machmind-dev/drone-swarm-challenge-2026/hardware/README.md

# Hardware

## Drone Version 2.0

| Swarm Stack Bracket | Base for LiDAR & Flow Motion | FC adapter 25.5 to 20 mm |
|---|---|---|
| [](drone/v2.0/swarm_stack_bracket.stl) | [](drone/v2.0/base_mount_lidar_flow_sensor_mk4.stl) | [](drone/v2.0/fc_mount_adapter_25_5%20_to_20_mm.stl) |

| Swarm Stack PCB | Spoiler Block (for RFID) | Spoiler Block Bracket |
|---|---|---|
| [](https://github.com/machmind-dev/drone-swarm-challenge-2026/tree/main/hardware/drone/v2.0/PCB) | [](drone/v2.0/spoiler_block_mk3.stl) | [](drone/v2.0/spoiler_block_bracket.stl) |

---

Drones assembled and ready for first flight test as formation of five units





<table><tr>
<td></td>
<td></td>
<td></td>
</tr><tr>
<td></td>
<td></td>
<td></td>
</tr><tr>
<td></td>
<td></td>
<td></td>
</tr></table>

---

## Ground Control Station

| Bezel Mk2 | Panel Bottom | Bottom Frame Mk2 |
|---|---|---|
| [](ground-station/bezel_mk2.stl) | [](ground-station/panel_bottom.stl) | [](ground-station/bottom_frame_mk2.stl) |

| Exhaust | Top Connector | Top Lower LH Mk3 |
|---|---|---|
| [](ground-station/exaust.stl) | [](ground-station/top_connector_mk3.stl) | [](ground-station/top_lower_lh_mk3.stl) |

| Top Lower RH Mk3 | Top Upper LH Mk3 | Top Upper RH Mk3 |
|---|---|---|
| [](ground-station/top_lower_rh_mk3.stl) | [](ground-station/top_upper_lh_mk3.stl) | [](ground-station/top_upper_rh_mk3.stl) |

Ground Control Station assembled and in use for flight testing





| Monitor trial fit | Assembling 1 | Assembling 2 |
|---|---|---|
|  |  |  |

---

## Transportation

| Transport Box Version 2.0 | Transport Box Version 1.0 |
|---|---|
| [](transportation/Version%202.0/transport_box_mk4.stl) | [](transportation/Version%201.0/transport_box_mk2.stl) |

---

Drones packed for trip to ILA Berlin 2026
