machmind-dev/drone-swarm-challenge-2026/ground-station-software/README.md

# Ground Control Station Software

Launch scripts are located in [launchers/](../launchers/).

**SDC26 Commander**



| Shortcut | Description | Source |
|---|---|---|
| Waypoint Commander | Sends arena coordinates to individual drones or all drones via Manhattan navigation. Format: `<drone_id\|all> <x> <y> [z] [yaw_deg]` | [Link](swarm/) |
| Keyboard Drone Control | Real-time manual keyboard control of a single drone. Selects drone and team/starting side interactively. | [Link](swarm/) |
| Ollama Control of Swarm | Natural-language swarm control via Gemma3 1B LLM running locally in Ollama. Converts text commands to arena coordinates over ROS2. | [Link](swarm/algorithm/) |
