machmind-dev/drone-swarm-challenge-2026/launchers/README.md

# Launchers

Platform-specific launch scripts for the Mach Mind Ground Control Station.

Screenshot of GCS desktop



| Property | [Ubuntu GNOME PC](ubuntu-gnome-pc/) | [Ubuntu XFCE Pi5](ubuntu-xfce-pi5/) |
|---|---|---|
| Platform | x86_64 | ARM64 (Raspberry Pi 5) |
| OS | Ubuntu 24.04 LTS (GNOME) | Ubuntu 24.04 LTS (XFCE) |
| ROS2 | Jazzy | Jazzy |
| Use | Development / home lab | Field GCS at competition |
| Network role | Wired to GL-AX1800 Flint router | Wired to GL-AX1800 Flint router |
