machmind-dev/drone-swarm-challenge-2026/hardware/drone/README.md

# Drone Hardware

## Drone v2.0

| Swarm Stack Bracket | Base for LiDAR & Flow Motion | FC adapter 25.5 to 20 mm |
|---|---|---|
| [](v2.0/swarm_stack_bracket.stl) | [](v2.0/base_mount_lidar_flow_sensor_mk4.stl) | [](v2.0/fc_mount_adapter_25_5%20_to_20_mm.stl) |

| Swarm Stack PCB | Spoiler Block (for RFID) | Spoiler Block Bracket |
|---|---|---|
| [](https://github.com/machmind-dev/drone-swarm-challenge-2026/tree/main/hardware/drone/v2.0/PCB) | [](v2.0/spoiler_block_mk3.stl) | [](v2.0/spoiler_block_bracket.stl) |

---

Drones assembled and ready for first flight test as formation of five units





<table><tr>
<td></td>
<td></td>
<td></td>
</tr><tr>
<td></td>
<td></td>
<td></td>
</tr><tr>
<td></td>
<td></td>
<td></td>
</tr></table>

---

## Version Comparison

| Version 1.0 | Version 2.0 |
|---|---|
| Version 1.0 | Version 2.0 |
| <div align="center">**Side view comparison**</div> | <div align="center">**Top view comparison**</div> |
| Stack comparison — side | Stack comparison — top |

**Swarm Stack Version 2.0**

Swarm Stack Version 2.0

---

## Part List

| # | Part Number | Description | Link |
|---|---|---|---|
| 1 | GEP-CT30 Cinebot30 | Airframe | [AliExpress](https://de.aliexpress.com/item/1005009477649601.html) |
| 2 | NxtPX4v2 H743 & BMI088 | Flight Controller | [AliExpress](https://de.aliexpress.com/item/1005006044318535.html) |
| 3 | GEPRC SPEEDX2 1804 2450KV | Motors | [AliExpress](https://de.aliexpress.com/item/1005009432319223.html) |
| 4 | HQPROP T3X1.5X3 | Propellers | [AliExpress](https://de.aliexpress.com/item/1005005411737841.html) |
| 5 | Tattu 1100mAh 15.2V 60C 4S1P | Battery | [Gens Ace](https://gensace.de/products/taa11004s60x3) |
| 6 | MicoAir MTF-01 | Optical Flow & LiDAR Sensor | [AliExpress](https://de.aliexpress.com/item/1005005545782306.html) |
| 7 | VL53L1X | ToF Laser Ranger (×6) | [AliExpress](https://de.aliexpress.com/item/1005009800135193.html) |
| 8 | OV5647 MIPI-CSI | Camera Module | [Amazon](https://www.amazon.de/dp/B07G9VLPZH) |
| 9 | ESP32-S3 | Comms Module | [Amazon](https://www.amazon.de/dp/B0C69FFVHH) |
| 10 | ESP32-P4 | Vision Module | [Amazon](https://www.amazon.de/dp/B0FKN8GCW6) |
| 11 | Seeed Studio 2.4GHz Rod Antenna | WiFi Antenna | [AliExpress](https://de.aliexpress.com/item/1005006991095171.html) |
