machmind-dev/drone-swarm-challenge-2026/hardware/ground-station/README.md

# Ground Control Station

| Bezel Mk2 | Panel Bottom | Bottom Frame Mk2 |
|---|---|---|
| [](bezel_mk2.stl) | [](panel_bottom.stl) | [](bottom_frame_mk2.stl) |

| Exhaust | Top Connector | Top Lower LH Mk3 |
|---|---|---|
| [](exaust.stl) | [](top_connector_mk3.stl) | [](top_lower_lh_mk3.stl) |

| Top Lower RH Mk3 | Top Upper LH Mk3 | Top Upper RH Mk3 |
|---|---|---|
| [](top_lower_rh_mk3.stl) | [](top_upper_lh_mk3.stl) | [](top_upper_rh_mk3.stl) |

---

Ground Control Station assembled and in use for flight testing





| Monitor trial fit | Assembling 1 | Assembling 2 |
|---|---|---|
|  |  |  |

---

## Part List

| # | Part Number | Description | Link |
|---|---|---|---|
| 1 | M3 x5 x 4 Voron | Threaded Insert M3 | [Amazon Shop](https://www.amazon.de/dp/B0CDH36ZMX?ref=ppx_yo2ov_dt_b_fed_asin_title&th=1) |
| 2 | Toolbox 38 x 14.5 x 33 cm | BigDean Machine Case with Foam Insert Empty | [Amazon Shop](https://www.amazon.de/dp/B0D37TFB92?ref=ppx_yo2ov_dt_b_fed_asin_title) |
