machmind-dev/drone-swarm-challenge-2026/hardware/transportation/README.md

# Transportation

| Transport Box Version 2.0 | Transport Box Version 1.0 |
|---|---|
| [](Version%202.0/transport_box_mk4.stl) | [](Version%201.0/transport_box_mk2.stl) |

---

Drones packed for trip to ILA Berlin 2026
