machmind-dev/drone-swarm-challenge-2026/drone-firmware/v2.0/README.md

# Drone Firmware v2.0

- **[drone-vision-esp32p4](drone-vision-esp32p4/)** — ESP32-P4 firmware — MIPI-CSI camera capture, ArUco marker detection (OpenCV), 6× VL53L1X ToF sensors, transmits pose + ToF data to S3 over UART
- **[drone-comms-esp32s3](drone-comms-esp32s3/)** — ESP32-S3 firmware — receives vision data from P4 over UART, bridges MAVLink between PX4 and the GCS over ROS2 micro-ROS
- **[shared](shared/)** — UART binary frame protocol header (`p4_link_protocol.h`) shared by both firmwares
- **[logs](logs/)** — PX4 flight logs (`.ulg`) and ROS2 bag files (`.mcap`) from test sessions

---

## Building and Flashing

Firmware is compiled and flashed from desktop shortcuts on the PC.

<table>
<tr>
<td align="center"><br><b>IDE — Flash P4</b></td>
<td>Firmware flashing for ESP32-P4 inside Docker (<a href="../../launchers/ubuntu-gnome-pc/launch-drone-vision-p4.sh">launch-drone-vision-p4.sh</a>)</td>
</tr>
<tr>
<td align="center"><br><b>IDE — Flash S3</b></td>
<td>Firmware flashing for ESP32-S3 inside Docker (<a href="../../launchers/ubuntu-gnome-pc/launch-drone-vision-s3.sh">launch-drone-vision-s3.sh</a>)</td>
</tr>
</table>

> **Note:** To avoid versioning issues, code is built and compiled inside Docker.

### Vision Module Configuration (ESP32-P4)

#### Camera Exposure Tuning

```cpp
#define CONFIG_VISION_AEC_TARGET 15   // ← tune per venue
```

| Value | Sensor target | Use when |
|---|---|---|
| 47 | ~91% (max) | Dark indoor arena, no windows |
| 20 | ~38% | Indoor with some ambient light |
| 15 | ~29% | Daylit venue, windows visible — current default |
| 10 | ~19% | Strong window glare / direct sunlight |

#### Detection Resolution

```cpp
#define VISION_RES_QVGA   // 320×240 — ~8 m detection range (default)
// #define VISION_RES_HVGA // 480×320 — ~12 m detection range, slower
```

---

### Comms Module Configuration (ESP32-S3)

#### DRONE_ID

```c
#define DRONE_ID 2   // ← set per airframe before flashing
```

Set `DRONE_ID` in `main/main.c` to the airframe number before building. This value is intentionally not committed — the repo keeps `2` as a neutral default. It controls the micro-ROS agent port (`8880 + DRONE_ID`) and the NED coordinate offset for arena navigation.

#### micro-ROS Agent IP and Port

The ESP32-S3 must be configured with the micro-ROS agent IP and port before flashing. Open `idf.py menuconfig` → **micro-ROS Settings**.

<table>
<tr>
<td align="center"><br><b>micro-ROS Agent IP</b><br>IP address of the GCS machine running the micro-ROS agent. Must match the static IP assigned to the GCS on the swarm network.</td>
<td align="center"><br><b>micro-ROS Agent Port</b><br>UDP port the agent listens on. Derived from <code>DRONE_ID</code>: port = <code>8880 + DRONE_ID</code> (e.g. drone 1 → 8881, drone 5 → 8885).</td>
</tr>
</table>

---

### idf.py commands

| Command | Description |
|---|---|
| `idf.py set-target <target>` | Set the chip target — `esp32p4` for the vision module or `esp32s3` for the comms module |
| `idf.py fullclean` | Delete build directory |
| `idf.py menuconfig` | Open settings menu for firmware settings (important for ESP32-S3) |
| `idf.py build` | Compile firmware |
| `idf.py flash` | Flash to board |
| `idf.py monitor` | Open serial console for debugging and troubleshooting |
