machmind-dev/drone-swarm-challenge-2026/hardware/drone/v2.0/PCB/README.md

# Swarm Stack PCB

Schematics and board design: **Autodesk Eagle** (`.sch` / `.brd`)

<table><tr>
<td></td>
<td></td>
</tr></table>

## ToF Sensors (VL53L1X)

| Sensor | XSHUT GPIO | Direction |
|---|---|---|
| S0 | GPIO4 | Left Hand (LH) |
| S1 | GPIO20 | LH 45° |
| S2 | GPIO21 | Forward |
| S3 | GPIO26 | 45° RH |
| S4 | GPIO32 | Right Hand (RH) |
| S5 | GPIO27 | Upwards |

## I2C (ESP32-P4)

| Signal | GPIO |
|---|---|
| SDA | GPIO2 |
| SCL | GPIO3 |

**Note 1:** The 1K Ohm current limiting resistor for LED strip control is not populated on the PCB — add it externally on the signal line.

**Note 2:** BEC must share a common ground with the Swarm Stack.

**Note 3:** Pinout was modified in the latest version — Waveshare ESP32-P4 with and without WiFi module have different pinouts.

**Note 4:** C6 module with WiFi 6 is not used and meant for the future.
