machmind-dev/drone-swarm-challenge-2026/docs/Technical Report for Finals Submission.pdf

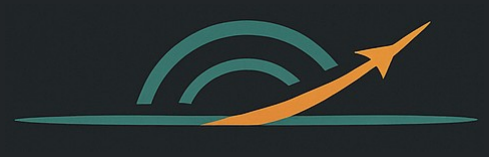
[picture p1: figure]

### 2026 June

2026

# Technical Report – Finals Submission

# Team

# Mach Mind

## Collective intelligence at Mach speed

X

# 1. System Architecture Overview – Version 2.0

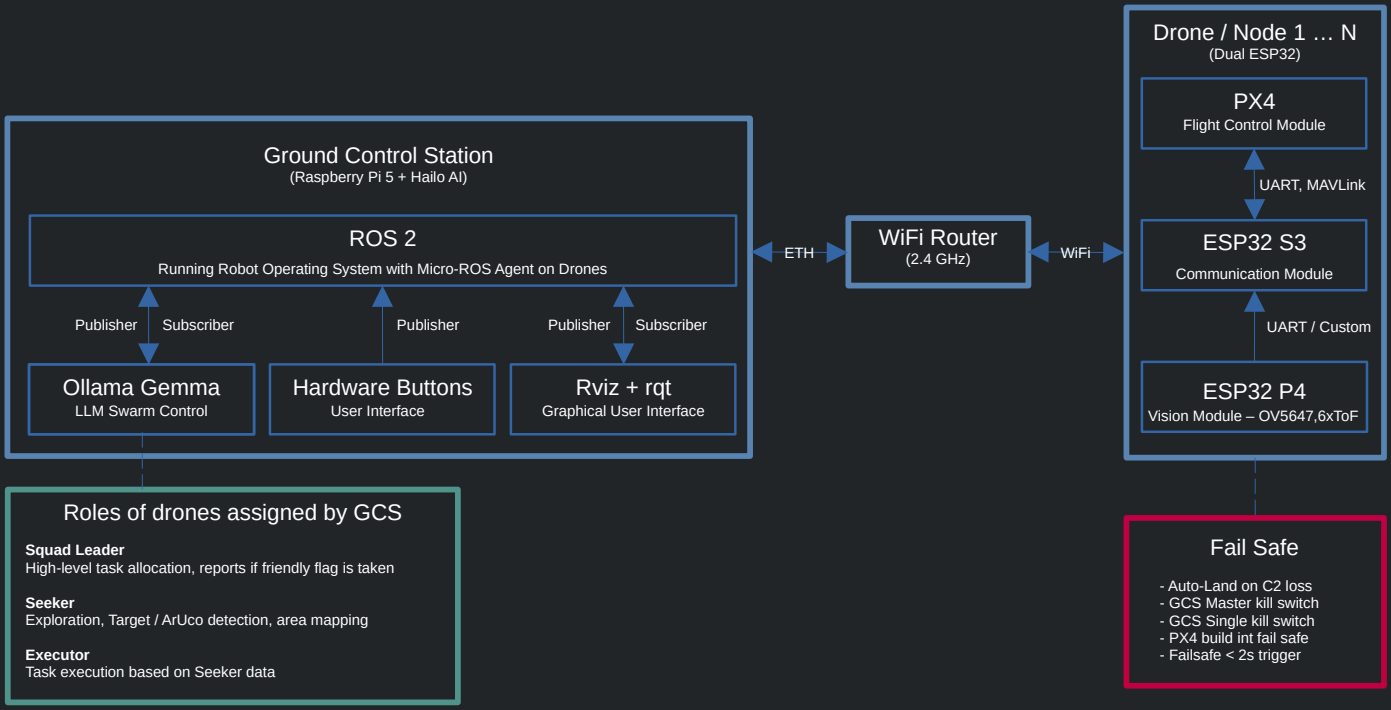
[picture p2: figure]
Ground Control Station; (Raspberry Pi 5 + Hailo AI); ROS 2; LLM Swarm Control; Ollama Gemma; Graphical User Interface; Hardware Buttons; Rviz + rqt; User Interface; WiFi Router; (2.4 GHz); WiFi; Drone / Node 1 … N; (Dual ESP32); Flight Control Module; ESP32 S3; Communication Module; Fail Safe; - Auto-Land on C2 loss - GCS Master kill switch - GCS Single kill switch - PX4 build int fail safe - Failsafe < 2s trigger; Roles of drones assigned by GCS; Squad Leader; Seeker; Executor Task execution based on Seeker data; Vision Module – OV5647,6xToF; ESP32 P4; UART, MAVLink; Publisher; Subscriber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

## System Summary

Mission | Autonomous multi-drone swarm for capture the flag scenario, GPS-denied indoor arena
Architecture | Ground Control Station handles tasks allocation, while drones maintain local autonomy.
System Config | 5 drones (1 Squad Leader, 2 Seekers, 2 Executors) and a Ground Control Station
Design Philosophy | Off-the-shelf hardware, open-source software stack - cost-effective, reproducible, scalable.

# Mach Mind

Collective intelligence at Mach speed

Team
Mindaugas Jonauskis
Hauke Renk

Contact
info@machmind.dev
http://machmind.dev

Running Robot Operating System with Micro-ROS Agent on Drones

High-level task allocation, reports if friendly flag is taken

Exploration, Target / ArUco detection, area mapping

# 2. Drone / Node

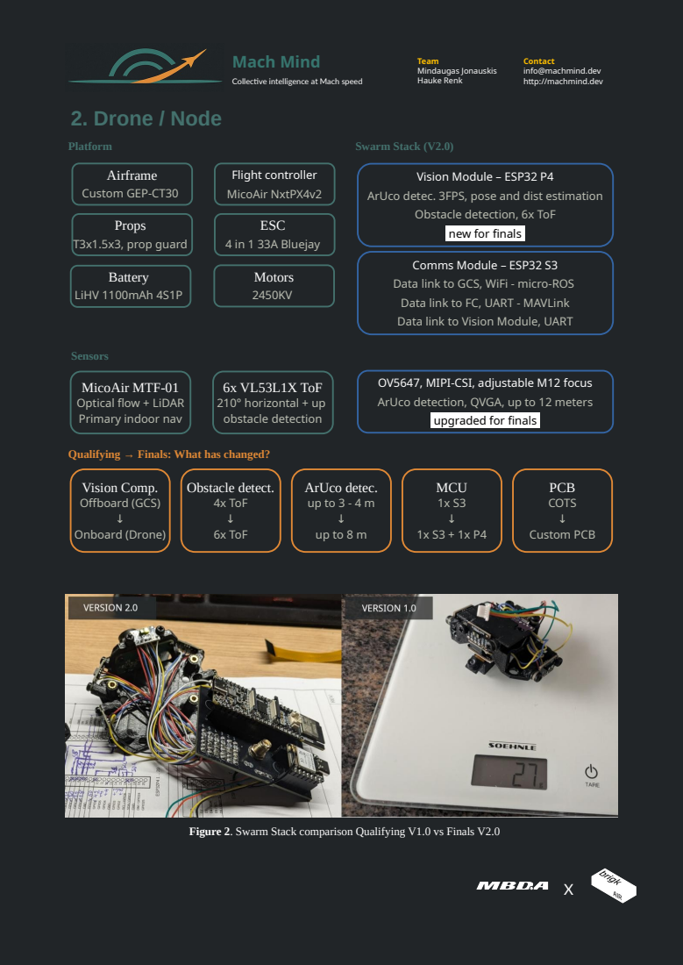
[picture p3: page 3]
Platform; Swarm Stack (V2.0); Sensors; Airframe Custom GEP-CT30; Flight controller MicoAir NxtPX4v2; Props T3x1.5x3, prop guard; ESC 4 in 1 33A Bluejay; Motors 2450KV; Battery LiHV 1100mAh 4S1P; Vision Module – ESP32 P4; 6x VL53L1X ToF 210° horizontal + up obstacle detection; Vision Comp. Offboard (GCS) ↓ Onboard (Drone); Obstacle detect. 4x ToF ↓ 6x ToF; ArUco detec. up to 3 - 4 m ↓ up to 8 m; MCU 1x S3 ↓ 1x S3 + 1x P4; PCB COTS ↓ Custom PCB

ArUco detec. 3FPS, pose and dist estimation

Obstacle detection, 6x ToF
new for finals

Comms Module – ESP32 S3
Team
Data link to GCS, WiFi - micro-ROS
Mindaugas Jonauskis
Hauke Renk
Data link to FC, UART - MAVLink
Data link to Vision Module, UART

Contact
info@machmind.dev
http://machmind.dev

MicoAir MTF-01
Optical flow + LiDAR
Primary indoor nav

OV5647, MIPI-CSI, adjustable M12 focus
ArUco detection, QVGA, up to 12 meters

upgraded for finals

Qualifying → Finals: What has changed?

Figure 2. Swarm Stack comparison Qualifying V1.0 vs Finals V2.0

# 3. Ground Control Station (GCS)

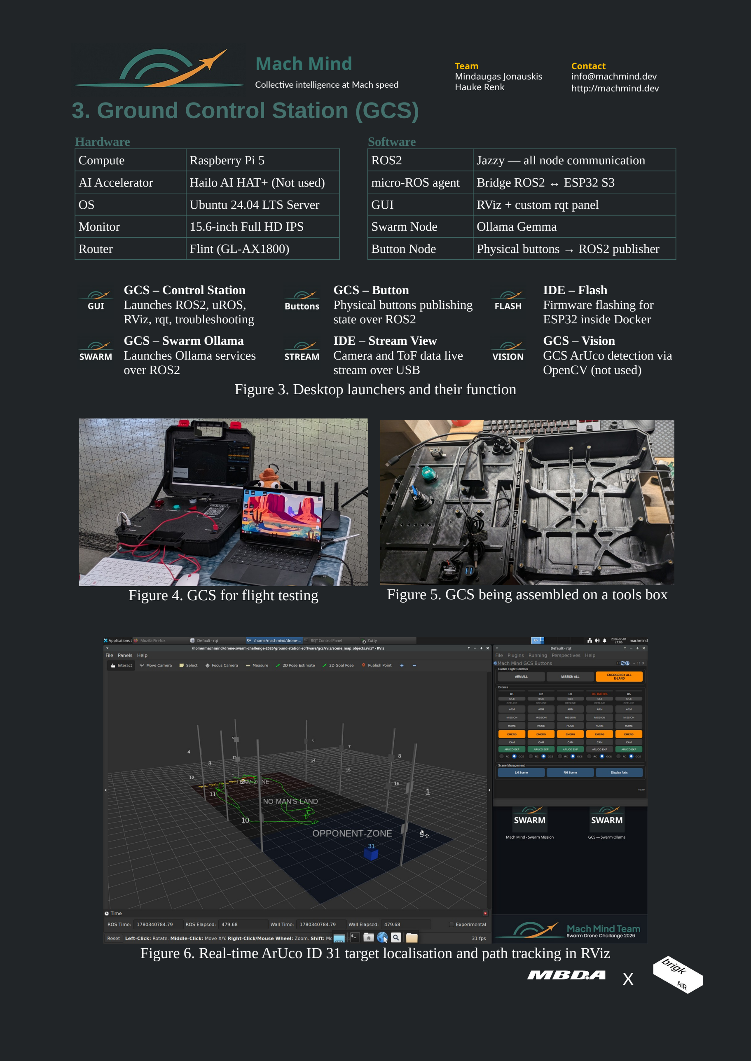
[picture p4: page 4]

Hardware
Compute | Raspberry Pi 5
AI Accelerator | Hailo AI HAT+ (Not used)
OS | Ubuntu 24.04 LTS Server
Monitor | 15.6-inch Full HD IPS
Router | Flint (GL-AX1800)

Software
ROS2 | Jazzy — all node communication
micro-ROS agent | Bridge ROS2 ↔ ESP32 S3
GUI | RViz + custom rqt panel
Swarm Node | Ollama Gemma
Button Node | Physical buttons → ROS2 publisher

GCS – Control Station
Launches ROS2, uROS,
RViz, rqt, troubleshooting

GCS – Button
Physical buttons publishing state over ROS2

IDE – Flash
Firmware flashing for
ESP32 inside Docker
GCS – Swarm Ollama
Launches Ollama services
over ROS2

IDE – Stream View
Camera and ToF data live
stream over USB

GCS – Vision
GCS ArUco detection via
OpenCV (not used)

### Figure 3. Desktop launchers and their function

Figure 4. GCS for flight testing | Figure 5. GCS being assembled on a tools box

### Figure 6. Real-time ArUco ID 31 target localisation and path tracking in RViz

# 4. Swarming

## 4.1 ROS Communication messaging for Swarm control

GCS (Publisher) → Drone (Subscriber) | Drone (Publisher) → GCS (Subscriber)
Topic (main) | Purpose | Topic (main) | Purpose
/gcs/drone_N/command Arm, takeoff, land, mission, emer. | /drone_N/state | Flight state
/gcs/drone_N/control | Waypoint | /drone_N/role | Accepted role
/gcs/drone_N/config | Runtime config (e.g. role) | /drone_N/vision_pose | Estimated position
/gcs/system/team_color Team colour, defines starting point | /drone_N/box_detected ID and position of box
Note: Only critical topics are shown, N – denotes drone ID.

## 4.2. Swarm Data

Swarm Size | 5 drones — finals config (2 drones at qualifying)
Coordination | Centralized GCS task allocation, drones maintain local autonomy
LLM control | Ollama Gemma 3 on Pi5 (CPU) via natural language ruleset → JSON → ROS2 commands
Inter-drone comms | All traffic routed through GCS
Autonomy level | Drones: local stabilize + collision avoidance. GCS: high-level task allocation

## 4.3. Swarm Control via LLM (DEMO)

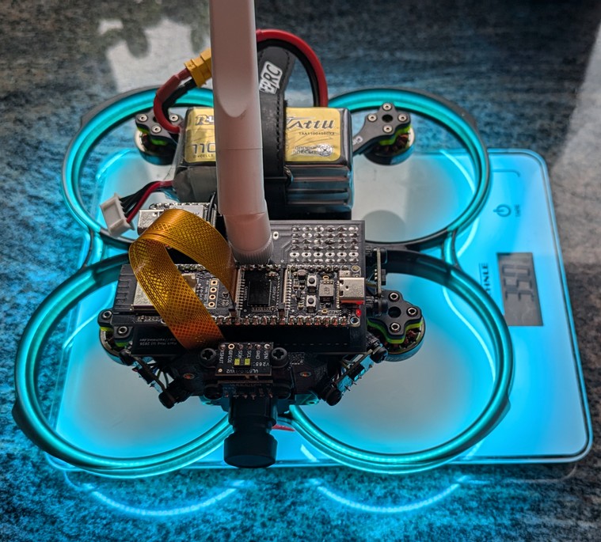
[picture p5: figure]
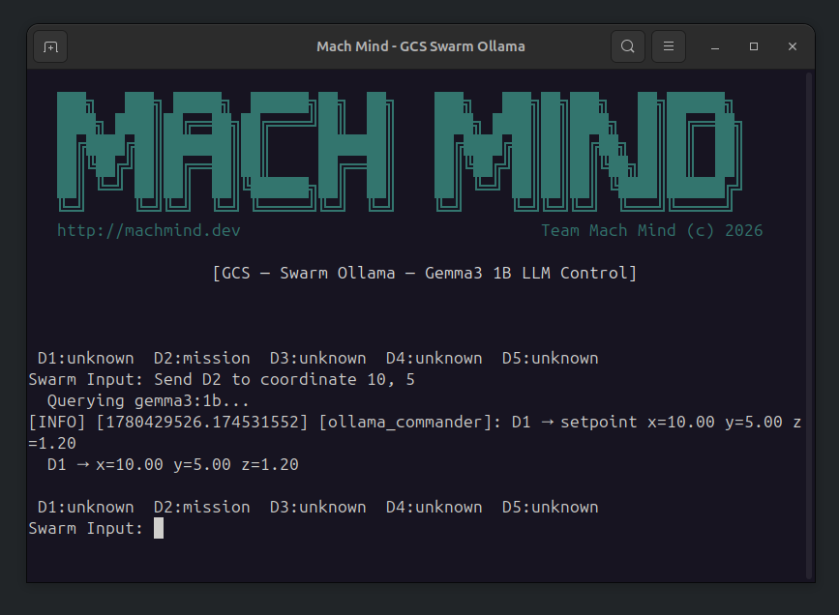
[picture p6: figure]

Figure 7. Sample of control input to LLM and drone with props removed.

# 5. Source Code and Drawings:

### https://github.com/machmind-dev/drone-swarm-challenge-2026

drone-swarm-challenge-2026/
├── drone-firmware/ | # All drone onboard firmware (v1.0 and v2.0)
│ | ├── v1.0/ | # SDC 2026 Qualifying — single ESP32-S3
│ | └── v2.0/ | # SDC 2026 Finals — dual ESP32-P4 + ESP32-S3
│ | ├── drone-vision-esp32p4/ | # Navigation: ArUco, ToF, UART TX
│ | ├── drone-comms-esp32s3/ | # Communication: MAVLink, micro-ROS
│ | └── shared/ | # Binary UART protocol header
├── ground-station-software/ | # ROS2 ground control station, swarm algorithms & vision
├── hardware/ | # Mechanical and electrical design files
├── launchers/ | # Platform-specific launch scripts
│ | ├── ubuntu-gnome-pc/ | # x86_64 Ubuntu GNOME (development GCS)
│ | └── ubuntu-xfce-pi5/ | # ARM64 Raspberry Pi 5 (field GCS)
└── docs/ | # Documentation and media
