machmind-dev/drone-swarm-challenge-2026/docs/media/README.md

# Media

## [flight-testing/](flight-testing/)

Flight test recordings and photos, in chronological order.

| First flight — 24 March 2026 | First flight 5 units — May 2026 | Basic swarming — June 2026 |
|---|---|---|
| [](https://github.com/machmind-dev/drone-swarm-challenge-2026/blob/main/docs/media/flight-testing/first-flight.mp4) | [](https://www.linkedin.com/embed/feed/update/urn:li:ugcPost:7463683893968187392) | [](https://www.linkedin.com/embed/feed/update/urn:li:ugcPost:7469555928992940034) |

### [flight-testing/crashes/](flight-testing/crashes/)

Photos from crash and repair incidents during development — documenting the hardware iteration process.

<table>
<tr>
<td></td>
<td></td>
<td></td>
</tr>
<tr>
<td></td>
<td></td>
<td></td>
</tr>
</table>

---

## [software/](software/)

3D model assets used by RViz for arena visualisation. Do not move or rename — paths are referenced by the RViz configuration.
