machmind-dev/drone-swarm-challenge-2026/ground-station-software/swarm/README.md

# Swarm Command and Control Tools

**SDC26 Commander** — [sdc26_commander.py](sdc26_commander.py)

Swarm orchestrator — assigns discovered boxes to executor drones, monitors leader home zone. Runs at 1 Hz, publishes waypoints over ROS2.



---

**Waypoint Commander** — [waypoint_commander.py](waypoint_commander.py)

Sends arena coordinates to individual drones or all drones via Manhattan navigation. Format: `<drone_id|all> <x> <y> [z] [yaw_deg]`. Arena: x=0–20 m, y=0–10 m.



---

**Keyboard Drone Control** — [mission_forward_back.py](mission_forward_back.py)

Real-time manual keyboard control of a single drone. Selects drone and team/starting side interactively before flight.



---

**Ollama Control of Swarm** — [algorithm/ollama_commander.py](algorithm/ollama_commander.py)

Natural-language swarm control via Gemma3 1B LLM running locally in Ollama. Converts text commands into arena coordinates published over ROS2.
