machmind-dev/drone-swarm-challenge-2026/drone-firmware/v1.0/components/espressif__opencv/examples/features2d/README.md

# Feature2d example for IDF OpenCV component

This example shows how to use OpenCV in ESP-IDF projects.

This example requires esp32-eye or esp32-s3-eye development boards. The example use opencv library to extract 
2D features from the image and compute the feature descriptors.
To run the example on target please run:

```
idf.py -p PORT flash monitor
```
