machmind-dev/drone-swarm-challenge-2026/(list of files, cad)

Other CAD files:
hardware/drone/for_reference_only_top_plate.stl
hardware/drone/v2.0/fc_mount_adapter_25_5 _to_20_mm.stl
hardware/ground-station/mk2/panel_4.stl
hardware/ground-station/top_lower_lh_mk3.stl
hardware/transportation/Version 2.0/transport_box_mk4.stl
hardware/drone/for_reference_only_bottom_frame_rough.stl
hardware/drone/v2.0/swarm_stack_bracket.stl
hardware/ground-station/mk2/panel_1_mk2.stl
hardware/ground-station/top_connector_mk3.stl
hardware/drone/v2.0/spoiler_block_bracket.stl
hardware/ground-station/bezel_mk2.stl
hardware/ground-station/mk2/panel_3_mk2.stl
hardware/drone/v2.0/spoiler_block_mk3.stl
hardware/ground-station/mk2/panel_6.stl
hardware/ground-station/top_upper_lh_mk3.stl
hardware/drone/v2.0/base_mount_lidar_flow_sensor_mk4.stl
hardware/ground-station/mk2/bottom_frame_mk2.stl
hardware/ground-station/top_upper_rh_mk3.stl
hardware/ground-station/mk2/panel_5.stl
hardware/ground-station/panel_bottom.stl
hardware/ground-station/mk2/panel_2.stl
hardware/ground-station/top_lower_rh_mk3.stl
hardware/ground-station/exaust.stl
drone-firmware/v1.0/components/espressif__opencv/opencv_contrib/modules/cnn_3dobj/samples/data/3Dmodel/ant.ply
drone-firmware/v1.0/components/espressif__opencv/opencv_contrib/modules/cnn_3dobj/samples/data/3Dmodel/ape.ply
drone-firmware/v1.0/components/espressif__opencv/opencv_contrib/modules/cnn_3dobj/samples/data/3Dmodel/bunny.ply
drone-firmware/v1.0/components/espressif__opencv/opencv_contrib/modules/cnn_3dobj/samples/data/3Dmodel/cow.ply
drone-firmware/v1.0/components/espressif__opencv/opencv_contrib/modules/cnn_3dobj/samples/data/3Dmodel/horse.ply
drone-firmware/v1.0/components/espressif__opencv/opencv_contrib/modules/cnn_3dobj/samples/data/3Dmodel/plane.ply
drone-firmware/v1.0/components/espressif__opencv/opencv_contrib/modules/sfm/samples/data/backyard.blend
drone-firmware/v1.0/components/espressif__opencv/opencv_contrib/modules/sfm/samples/data/desktop.blend
drone-firmware/v1.0/components/espressif__opencv/opencv_contrib/modules/surface_matching/samples/data/parasaurolophus_6700.ply
drone-firmware/v1.0/components/espressif__opencv/opencv_contrib/modules/surface_matching/samples/data/parasaurolophus_low_normals2.ply
drone-firmware/v1.0/components/espressif__opencv/opencv_contrib/modules/surface_matching/samples/data/rs1_normals.ply
drone-firmware/v1.0/components/espressif__opencv/opencv_contrib/modules/surface_matching/samples/data/rs22_proc2.ply
drone-firmware/v1.0/components/espressif__opencv/opencv_contrib/modules/viz/samples/data/bunny.ply
hardware/drone/v1.0/base_mount_lidar_flow_sensor_mk4.stl
hardware/drone/v1.0/camera_sleve.stl
hardware/drone/v1.0/camera_sleve_alternative.stl
hardware/drone/v1.0/fc_mount_adapter_25_5 _to_20_mm.stl
hardware/drone/v1.0/side_bracket_for_laser_ranger.stl
hardware/drone/v1.0/swarm stack bracket mk6.stl
hardware/drone/v1.0/swarm stack bracket mk7.stl
hardware/drone/v1.0/swarm stack bracket mk7_6.stl
hardware/transportation/Version 1.0/transport_box_mk2.stl
