machmind-dev/drone-swarm-challenge-2026/hardware/drone/v2.0/PCB/Schematics.brd

## EAGLE design hardware/drone/v2.0/PCB/Schematics.brd (2026-06-09)

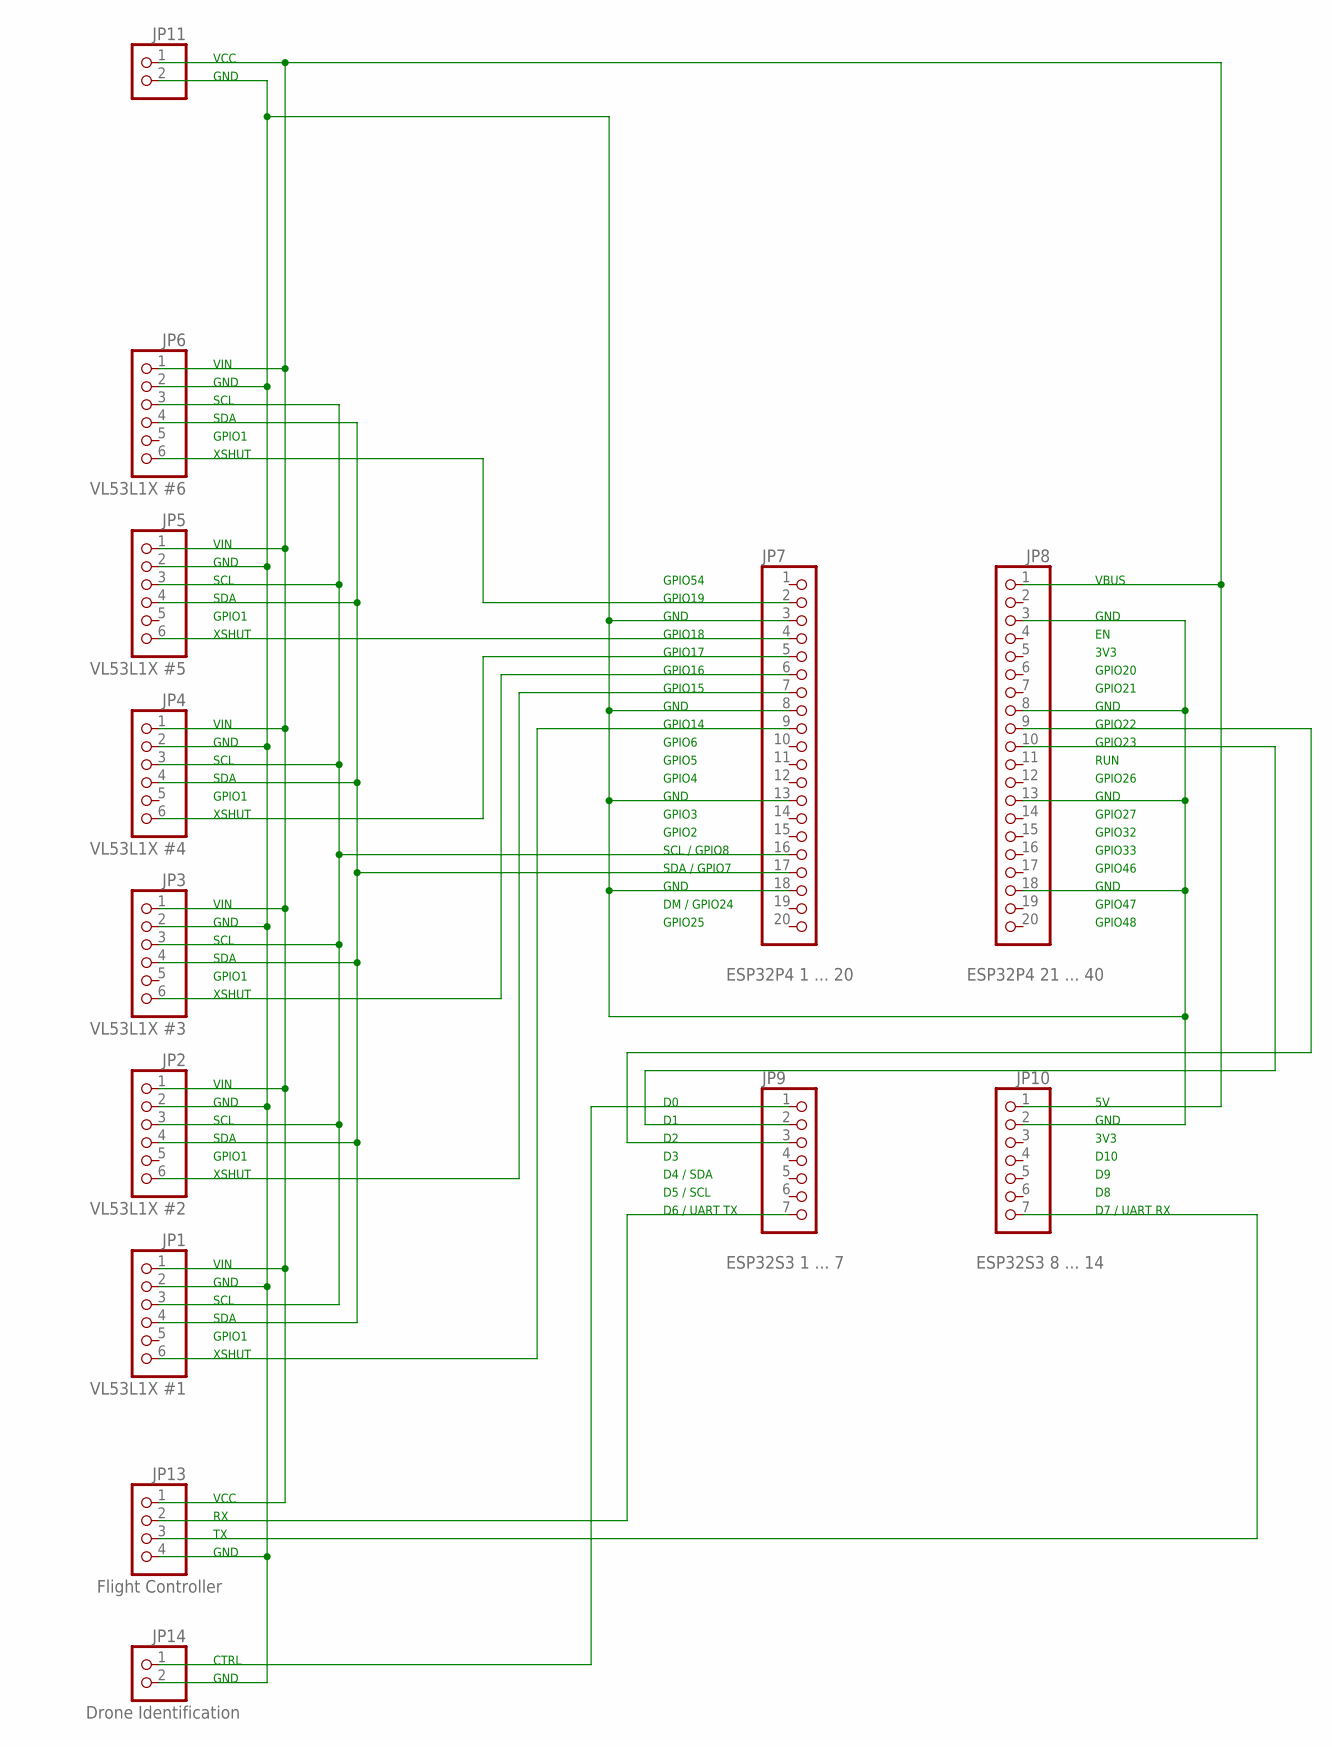
[picture p7: schematic Schematics.sch]

Parts:
JP1: VL53L1X #1; 1X06
JP2: VL53L1X #2; 1X06
JP3: VL53L1X #3; 1X06
JP4: VL53L1X #4; 1X06
JP5: VL53L1X #5; 1X06
JP6: VL53L1X #6; 1X06
JP7: ESP32P4 1 ... 20; 1X20
JP8: ESP32P4 21 ... 40; 1X20
JP9: ESP32S3 1 ... 7; 1X07
JP10: ESP32S3 8 ... 14; 1X07
JP11: PINHD-1X2; 1X02
JP13: Flight Controller; 1X04
JP14: Drone Identification; 1X02

Connections:
5VDC: JP1.1, JP2.1, JP3.1, JP4.1, JP5.1, JP6.1, JP8.1, JP10.1, JP11.1, JP13.1
GND: JP1.2, JP2.2, JP3.2, JP4.2, JP5.2, JP6.2, JP7.3, JP7.8, JP7.13, JP7.18, JP8.3, JP8.8, JP8.13, JP8.18, JP10.2, JP11.2, JP13.4, JP14.2
LED_CTRL: JP9.1, JP14.1
MASTER_RX: JP8.10, JP9.2
MASTER_TX: JP8.9, JP9.3
MAVLINK_RX: JP10.7, JP13.3
MAVLINK_TX: JP9.7, JP13.2
SCL: JP1.3, JP2.3, JP3.3, JP4.3, JP5.3, JP6.3, JP7.16
SDA: JP1.4, JP2.4, JP3.4, JP4.4, JP5.4, JP6.4, JP7.17
XSHUT1: JP1.6, JP7.9
XSHUT2: JP2.6, JP7.7
XSHUT3: JP3.6, JP7.6
XSHUT4: JP4.6, JP7.5
XSHUT5: JP5.6, JP7.4
XSHUT6: JP6.6, JP7.2

Notes on the sheet:
VIN
GND
SCL
SDA
GPIO1
XSHUT
GPIO54
GPIO19
GPIO18
GPIO17
GPIO16
GPIO15
GPIO14
GPIO6
GPIO5
GPIO4
GPIO3
GPIO2
SCL / GPIO8
SDA / GPIO7
DM / GPIO24
GPIO25
VBUS
GPIO20
3V3
GPIO21
GPIO22
GPIO23
RUN
GPIO26
GPIO27
GPIO32
GPIO33
GPIO46
GPIO47
GPIO48
D4 / SDA
D5 / SCL
D6 / UART TX
D10
D7 / UART RX
VCC
CTRL

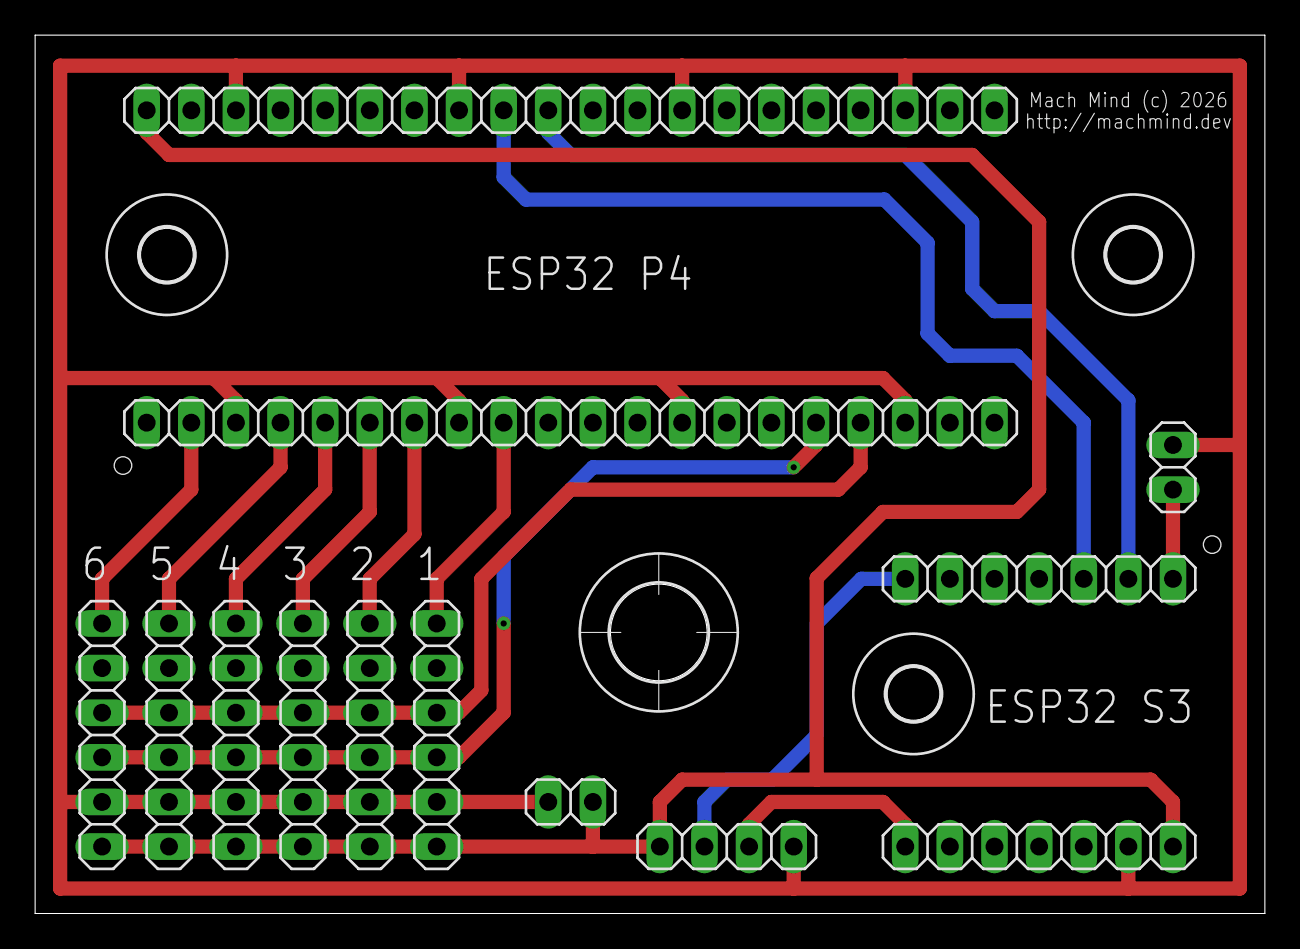
[picture p8: board Schematics.brd from above]

Board: 2 copper layers, 70.0 x 50.0 mm, 17 parts (0 on the bottom side), 15 nets.

Other parts of the board:
U$1, U$2, U$3: 3,0
U$4: 5,5
