machmind-dev/drone-swarm-challenge-2026/drone-firmware/PX4_settings.params

1	1	BAT1_A_PER_V	17.000000000000000000	9
1	1	BAT1_CAPACITY	-1.000000000000000000	9
1	1	BAT1_I_CHANNEL	-1	6
1	1	BAT1_N_CELLS	4	6
1	1	BAT1_R_INTERNAL	0.004999999888241291	9
1	1	BAT1_SOURCE	0	6
1	1	BAT1_V_CHANNEL	-1	6
1	1	BAT1_V_CHARGED	4.199999809265136719	9
1	1	BAT1_V_DIV	10.100000381469726563	9
1	1	BAT1_V_EMPTY	3.200000047683715820	9
1	1	BAT1_V_LOAD_DROP	0.100000001490116119	9
1	1	BAT_AVRG_CURRENT	15.000000000000000000	9
1	1	BAT_CRIT_THR	0.070000000298023224	9
1	1	BAT_EMERGEN_THR	0.050000000745058060	9
1	1	BAT_LOW_THR	0.150000005960464478	9
1	1	BAT_N_CELLS	3	6
1	1	BAT_V_CHARGED	4.050000190734863281	9
1	1	BAT_V_EMPTY	3.599999904632568359	9
1	1	BAT_V_LOAD_DROP	0.300000011920928955	9
1	1	BAT_V_OFFS_CURR	0.000000000000000000	9
1	1	CA_AIRFRAME	0	6
1	1	CA_ROTOR0_AX	0.000000000000000000	9
1	1	CA_ROTOR0_AY	0.000000000000000000	9
1	1	CA_ROTOR0_AZ	-1.000000000000000000	9
1	1	CA_ROTOR0_CT	6.500000000000000000	9
1	1	CA_ROTOR0_KM	0.050000000745058060	9
1	1	CA_ROTOR0_PX	0.150000005960464478	9
1	1	CA_ROTOR0_PY	0.150000005960464478	9
1	1	CA_ROTOR0_PZ	0.000000000000000000	9
1	1	CA_ROTOR10_AX	0.000000000000000000	9
1	1	CA_ROTOR10_AY	0.000000000000000000	9
1	1	CA_ROTOR10_AZ	-1.000000000000000000	9
1	1	CA_ROTOR10_CT	6.500000000000000000	9
1	1	CA_ROTOR10_KM	0.050000000745058060	9
1	1	CA_ROTOR10_PX	0.000000000000000000	9
1	1	CA_ROTOR10_PY	0.000000000000000000	9
1	1	CA_ROTOR10_PZ	0.000000000000000000	9
1	1	CA_ROTOR11_AX	0.000000000000000000	9
1	1	CA_ROTOR11_AY	0.000000000000000000	9
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
1	1	PWM_MAIN_DIS3	1000	6
1	1	PWM_MAIN_DIS4	1000	6
1	1	PWM_MAIN_DIS5	1000	6
1	1	PWM_MAIN_DIS6	1000	6
1	1	PWM_MAIN_DIS7	1000	6
1	1	PWM_MAIN_DIS8	1000	6
1	1	PWM_MAIN_FAIL1	-1	6
1	1	PWM_MAIN_FAIL2	-1	6
1	1	PWM_MAIN_FAIL3	-1	6
1	1	PWM_MAIN_FAIL4	-1	6
1	1	PWM_MAIN_FAIL5	-1	6
1	1	PWM_MAIN_FAIL6	-1	6
1	1	PWM_MAIN_FAIL7	-1	6
1	1	PWM_MAIN_FAIL8	-1	6
1	1	PWM_MAIN_FUNC1	101	6
1	1	PWM_MAIN_FUNC2	104	6
1	1	PWM_MAIN_FUNC3	103	6
1	1	PWM_MAIN_FUNC4	102	6
1	1	PWM_MAIN_FUNC5	0	6
1	1	PWM_MAIN_FUNC6	0	6
1	1	PWM_MAIN_FUNC7	0	6
1	1	PWM_MAIN_FUNC8	0	6
1	1	PWM_MAIN_MAX1	2000	6
1	1	PWM_MAIN_MAX2	2000	6
1	1	PWM_MAIN_MAX3	2000	6
1	1	PWM_MAIN_MAX4	2000	6
1	1	PWM_MAIN_MAX5	2000	6
1	1	PWM_MAIN_MAX6	2000	6
1	1	PWM_MAIN_MAX7	2000	6
1	1	PWM_MAIN_MAX8	2000	6
1	1	PWM_MAIN_MIN1	1000	6
1	1	PWM_MAIN_MIN2	1000	6
1	1	PWM_MAIN_MIN3	1000	6
1	1	PWM_MAIN_MIN4	1000	6
1	1	PWM_MAIN_MIN5	1000	6
1	1	PWM_MAIN_MIN6	1000	6
1	1	PWM_MAIN_MIN7	1000	6
1	1	PWM_MAIN_MIN8	1000	6
1	1	PWM_MAIN_TIM0	-3	6
1	1	PWM_MAIN_TIM1	400	6
1	1	PWM_MAIN_TIM2	400	6
1	1	SYS_AUTOSTART	4001	6
