machmind-dev/drone-swarm-challenge-2026/drone-firmware/v2.0/drone-vision-esp32p4/main/tof_task.c

/* tof_task.c — VL53L1X ToF sensor task for ESP32-P4 Navigation Module
 *
 * Hardware (Mach Mind Sensors Board rev 07/2026):
 *   I2C bus — dedicated I2C_NUM_0 on GPIO2 (SDA) / GPIO3 (SCL).
 *   Separate from camera SCCB (I2C_NUM_1, GPIO7/8): ISP AEC polls OV5647
 *   continuously; sharing that bus causes collision with 20 Hz TOF reads.
 *   Pull-ups: provided by the VL53L1X breakout board (4.7 kΩ to 3.3 V).
 *
 *   Wiring: SDA→GPIO2, SCL→GPIO3, GND, 3V3
 *   XSHUT pins: slot0→GPIO4, slot1→GPIO20, slot2→GPIO21, slot3→GPIO26,
 *               slot4→GPIO32, slot5→GPIO27 (up)
 *   GPIO22/23 reassigned to UART1 TX/RX → ESP32-S3
 *
 * Sensor slots (6 active):
 *   Slot 0  XSHUT GPIO4   addr 0x54
 *   Slot 1  XSHUT GPIO20  addr 0x56
 *   Slot 2  XSHUT GPIO21  addr 0x58
 *   Slot 3  XSHUT GPIO26  addr 0x5A
 *   Slot 4  XSHUT GPIO32  addr 0x5C
 *   Slot 5  XSHUT GPIO27  addr 0x5E  (upward-facing)
 *
 * Poll rate: ~20 Hz (50 ms; VL53L1X LONG mode needs ~33 ms/measurement)
 */

#include "tof_task.h"
#include "VL53L1X_api.h"
#include "vl53l1_platform.h"
#include "i2c_platform_esp.h"
#include "boards.h"
#include "p4_link_tx.h"
#include "aruco_pose.h"

#include "freertos/FreeRTOS.h"
#include "freertos/task.h"
#include "driver/gpio.h"
#include "esp_log.h"

static const char *TAG = "tof";

/* ── I2C bus config — pin constants come from boards.h ──────────────────── */
#define TOF_SDA_PIN     TOF_I2C_SDA     /* GPIO2 — dedicated I2C_NUM_0 bus  */
#define TOF_SCL_PIN     TOF_I2C_SCL     /* GPIO3 — dedicated I2C_NUM_0 bus  */
#define TOF_I2C_PORT    I2C_NUM_0
#define TOF_I2C_FREQ    100000

/* ── Sensor array ────────────────────────────────────────────────────────── */
#define SENSOR_COUNT 6
static VL53L1_Dev_t s_sensors[SENSOR_COUNT] = {
    { .I2cDevAddr = VL53L1_I2C_ADDRESS + 2,  /* 0x54 */
      .shutdown_pin = TOF_XSHUT_PIN_0,        /* GPIO4  */
      .distance_mode = DISTANCE_MODE_LONG, .timing_budget = 33, .inter_measurement = 40 },
    { .I2cDevAddr = VL53L1_I2C_ADDRESS + 4,  /* 0x56 */
      .shutdown_pin = TOF_XSHUT_PIN_1,        /* GPIO20 */
      .distance_mode = DISTANCE_MODE_LONG, .timing_budget = 33, .inter_measurement = 40 },
    { .I2cDevAddr = VL53L1_I2C_ADDRESS + 6,  /* 0x58 */
      .shutdown_pin = TOF_XSHUT_PIN_2,        /* GPIO21 */
      .distance_mode = DISTANCE_MODE_LONG, .timing_budget = 33, .inter_measurement = 40 },
    { .I2cDevAddr = VL53L1_I2C_ADDRESS + 8,  /* 0x5A */
      .shutdown_pin = TOF_XSHUT_PIN_3,        /* GPIO26 */
      .distance_mode = DISTANCE_MODE_LONG, .timing_budget = 33, .inter_measurement = 40 },
    { .I2cDevAddr = VL53L1_I2C_ADDRESS + 10, /* 0x5C */
      .shutdown_pin = TOF_XSHUT_PIN_4,        /* GPIO32 */
      .distance_mode = DISTANCE_MODE_LONG, .timing_budget = 33, .inter_measurement = 40 },
    { .I2cDevAddr = VL53L1_I2C_ADDRESS + 12, /* 0x5E */
      .shutdown_pin = TOF_XSHUT_PIN_5,        /* GPIO27 — upward-facing */
      .distance_mode = DISTANCE_MODE_LONG, .timing_budget = 33, .inter_measurement = 40 },
};


/* ── Latest readings (written by tof_task, read by aruco task) ──────────── */
static volatile uint16_t s_dist_mm[6]      = {0};
static volatile uint8_t  s_range_status[6] = {255, 255, 255, 255, 255, 255};

uint16_t tof_get_distance_mm(uint8_t idx)  { return (idx < SENSOR_COUNT) ? s_dist_mm[idx]      : 0;   }
uint8_t  tof_get_range_status(uint8_t idx) { return (idx < SENSOR_COUNT) ? s_range_status[idx] : 255; }
uint8_t  tof_sensor_count(void)            { return SENSOR_COUNT; }

/* ── Task ───────────────────────────────────────────────────────────────── */
static void tof_task(void *arg)
{
    (void)arg;

    /* Drive all XSHUT LOW immediately — pure GPIO, no I2C needed.
     * VL53L1X may hold SDA low from a previous boot's incomplete transaction.
     * This must happen before camera SCCB starts so the shared bus is clean;
     * otherwise esp_video_init() gets an I2C timeout and fails. */
    for (int k = 0; k < SENSOR_COUNT; k++) {
        gpio_num_t pin = s_sensors[k].shutdown_pin;
        if (pin == GPIO_NUM_NC) continue;
        gpio_config_t xshut_cfg = {
            .pin_bit_mask       = 1ULL << pin,
            .mode               = GPIO_MODE_OUTPUT_OD,
            .pull_up_en         = GPIO_PULLUP_DISABLE,
            .pull_down_en       = GPIO_PULLDOWN_DISABLE,
            .intr_type          = GPIO_INTR_DISABLE,
        };
        gpio_config(&xshut_cfg);
        gpio_set_level(pin, 0);
        ESP_LOGI(TAG, "XSHUT GPIO%d → LOW", (int)pin);
    }
    vTaskDelay(pdMS_TO_TICKS(10));

    i2c_init_config(TOF_I2C_PORT, TOF_SDA_PIN, TOF_SCL_PIN, TOF_I2C_FREQ);
    ESP_LOGI(TAG, "I2C_NUM_%d  SDA=GPIO%d  SCL=GPIO%d  %d Hz",
             (int)TOF_I2C_PORT, (int)TOF_SDA_PIN, (int)TOF_SCL_PIN, TOF_I2C_FREQ);

    /* Scan with all XSHUTs still LOW — no sensors on bus, so i2c_master_probe
     * never touches address 0x29 and leaves no ghost device in the driver.
     * Running the scan after releasing XSHUTs caused i2c_master_bus_add_device(0x29)
     * to fail for the entire InitSensorArray sequence. */
    i2c_scan();

    /* XSHUTs stay LOW — InitSensorArray releases each sensor individually
     * for address assignment; pre-releasing all here would put multiple
     * sensors on the bus at 0x29 simultaneously and cause contention. */
    ESP_LOGI(TAG, "=== VL53L1X_InitSensorArray START ===");
    VL53L1X_ERROR err = VL53L1X_InitSensorArray(s_sensors, SENSOR_COUNT);
    if (err != VL53L1_ERROR_NONE) {
        ESP_LOGE(TAG, "=== VL53L1X_InitSensorArray FAILED err=%d — check XSHUT wiring and I2C bus ===", err);
        vTaskDelete(NULL);
        return;
    }
    ESP_LOGI(TAG, "=== VL53L1X_InitSensorArray OK ===");

    for (int k = 0; k < SENSOR_COUNT; k++) {
        ESP_LOGI(TAG, "sensor[%d] addr=0x%02X XSHUT=GPIO%d ready",
                 k, s_sensors[k].I2cDevAddr, (int)s_sensors[k].shutdown_pin);
    }

    while (1) {
        for (int k = 0; k < SENSOR_COUNT; k++) {
            VL53L1_Dev_t *t = &s_sensors[k];
            if (t->I2cDevAddr == 0) continue;   /* not present — skipped during init */
            t->range_error = VL53L1X_GetAndRestartMeasurement(
                t->I2cDevAddr, &t->range_status, &t->range_mm);

            if (t->range_error == VL53L1_ERROR_NONE) {
                s_dist_mm[k]      = t->range_mm;
                s_range_status[k] = t->range_status;
            }
        }
        /* Transmit COMBINED frame to ESP32-S3 over UART1. */
        float px = 0, py = 0, pz = 0, pqx = 0, pqy = 0, pqz = 0, pqw = 1;
        float reproj = 0.0f;
        uint8_t tid = 0xFF;
        p4_boxes_t boxes;
        bool pv = aruco_pose_get_latest(&px, &py, &pz, &pqx, &pqy, &pqz, &pqw, &tid, &reproj);
        aruco_boxes_get_latest(&boxes);
        p4_link_send_combined(
            (const uint16_t *)s_dist_mm, (const uint8_t *)s_range_status,
            pv, px, py, pz, pqx, pqy, pqz, pqw, tid, reproj, &boxes);

        /* VL53L1X LONG mode measurement time ~33 ms; poll at 50 ms -> ~20 Hz */
        vTaskDelay(pdMS_TO_TICKS(50));
    }
}

void tof_task_start(void)
{
    p4_link_tx_init();
    xTaskCreatePinnedToCore(tof_task, "tof", 4096, NULL, 4, NULL,
                            1 /* CPU1 — aruco/camera on CPU0 */);
}
