machmind-dev/drone-swarm-challenge-2026/drone-firmware/v2.0/drone-comms-esp32s3/main/p4_link.h

/* p4_link.h — ESP32-S3 UART receiver for the P4->S3 binary link. */
#pragma once
#include <stdint.h>
#include <stdbool.h>
#include "../shared/p4_link_protocol.h"

typedef struct {
    uint16_t dist_mm[P4_LINK_SENSORS];
    uint8_t  status[P4_LINK_SENSORS];
} p4_tof_data_t;

typedef struct {
    bool    valid;
    uint8_t trigger_id;   /* TEST: detected marker ID, 0xFF = none */
    float   x, y, z;
    float   qx, qy, qz, qw;
    float   reproj_err;   /* mean corner reprojection error (pixels); 0 if pose invalid */
} p4_pose_data_t;

/* Start the UART2 receiver task.  Must be called once before app_main spins. */
void p4_link_init(void);

/* Copy the latest received ToF frame into *out.
 * Returns true if at least one frame has been received since boot. */
bool p4_link_get_tof(p4_tof_data_t *out);

/* Copy the latest received pose frame into *out.
 * Returns true if at least one frame has been received since boot. */
bool p4_link_get_pose(p4_pose_data_t *out);

/* Copy the latest received box marker positions into *out (count may be 0). */
void p4_link_get_boxes(p4_boxes_t *out);

/* Milliseconds since the last successfully parsed frame was received.
 * Returns INT64_MAX if no frame has arrived yet. */
int64_t p4_link_age_ms(void);
