machmind-dev/drone-swarm-challenge-2026/(commit log)

2026-04-13 Initial project structure
    Organises ESP32-S3 drone firmware, ROS2 ground station software, and
    project scaffolding into the drone-swarm-challenge-2026 repository layout
    for Team Mach Mind's SDC 2026 submission.
2026-04-13 feat: Add binary assets via Git LFS
    Enables Git LFS and commits binary files (3D models, textures, test
    images) that were previously blocked by the .gitignore safety net.
    [generic_market.stl, marker.blend]
2026-04-13 fix: Update all paths to be standalone from esp32s3-microros
    Replace all hardcoded /home/pihas/esp32s3-microros/ references with
    the correct drone-swarm-challenge-2026 paths in launcher scripts and
    vision launcher.
2026-04-13 refactor: Move launchers to repo root, add icons, update desktop files
    - Move launchers/ from ground-station-software/ to repo root for
    easier access at /home/pihas/drone-swarm-challenge-2026/launchers/
    - Add PNG icons for all desktop shortcuts
    - Update all Exec= and Icon= paths in .desktop files
2026-04-13 feat: Refactor ArUco vision, add button status to RViz, update launchers
    - Remove aruco_detect_only.py/yaml and launcher.py in favour of updated aruco_node.py
    - Add start_vision_gcs.sh to launch vision and GCS together
    - Add Button Status MarkerArray display to RViz scene; remove obstacle/esp32 namespaces
    - Add btn_test.py for button hardware testing
    - Add new launcher scripts (launch.sh, launch-vision.sh, launch-buttons.sh, launch-node-ide.sh)
    - Add Node IDE desktop shortcut and MachMindVision desktop entry
    - Update existing desktop files and add bg_option2.png background
    [btn_test.py]
2026-04-13 chore: Update RViz camera view state
2026-04-14 feat: Refactor GCS rqt button panel with per-drone state, ROS spin timer, and kill/eland controls
2026-04-15 fix: Fix launch-idf-docker.sh to use esp32s3-microros project dir
    Point to ~/esp32s3-microros (which has the micro_ros_espidf_component
    Dockerfile), fix wrong service name, remove stray host-level chown/source
    commands that caused the spurious sudo prompt, and add error handling.
2026-04-15 feat: Remove auto scene publishing from launchers
    Scene (floor, zones, monuments) is no longer published on startup.
    Use the LH Scene / RH Scene buttons in the RQT control panel to
    load it manually at the appropriate time.
2026-04-15 feat: Reintroduce 3D monument markers via RQT scene buttons
    Add _publish_monuments() which publishes all 12 DAE mesh markers and
    their numeric labels. Called from both _publish_lh_scene() and
    _publish_rh_scene() so monuments appear whenever a scene is loaded.
    Mesh path resolves from $HOME at runtime for cross-machine portability.
2026-04-15 feat: Publish team area side on LH/RH Scene load
    Publishes "LH" or "RH" to /gcs/system/team_area whenever a scene
    button is pressed, so downstream nodes know which side is the team zone.
2026-04-15 fix: Per-drone ARM button now toggles ARM/DISARM like ARM ALL
    Use button checked state instead of drone_states dict to determine
    command, and update button text to ARMED/ARM on toggle and on
    state feedback — matching ARM ALL behaviour.
2026-04-15 fix: Default drone source radio button to GCS instead of RC
2026-04-15 feat: Add Display Axis button to Scene Management
    Publishes X/Y/Z arrow markers (red/green/blue) with text labels
    to /visualization_marker_array from the map frame origin.
2026-04-15 fix: Mission buttons grey until armed state, green when ready
    Per-drone MISSION uses :enabled/:disabled pseudo-states so color
    follows setEnabled() automatically. MISSION ALL starts grey and
    turns green in _state_callback when any drone reports armed.
2026-04-15 fix: ARM buttons reflect armed state from drone feedback
    Per-drone ARM: red/ARMED only when state == "armed".
    ARM ALL: red/ARMED when any drone reports "armed", driven by
    state feedback rather than button toggle alone.
2026-04-15 feat: MISSION ALL turns blue when any drone is in mission state
    Color priority: blue (any in mission) > green (any armed) > grey (idle).
    ARM button stays red for armed/mission/landing states.
2026-04-16 feat: Hardware button priority and Global Flight Controls state indicators
    - btn_test.py: publish COMMAND_ARM/DISARM directly to all drones on ARM
    hold/release; COMMAND_MISSION_START to armed drones only on MISSION press;
    COMMAND_ELAND on short press, auto-fire COMMAND_KILL after 3s hold on EMERG
    - btn_test.py: publish latched HW state topics for rqt to mirror
    - btn_test.py: subscribe to drone states to enforce mission armed-only gate
    - btn_test.py: align LONG_PRESS_S to 3s (matches rqt EMERGENCY_HOLD_SECONDS)
    - btn_test.py: remove unused TAKEOFF/START mission states
    - gcs_button_panel.py: subscribe to hw state topics, lock Global Flight
    Controls buttons when hardware is active
    - gcs_b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
    [btn_test.py]
2026-04-16 feat: GCS button state indicators, HW/SW parity and UI cleanup
    - btn_test.py: remove RViz marker visualisation (state now tracked via rqt panel)
    - btn_test.py: remove all unused imports, colour constants, marker helpers
    - gcs_button_panel.py: EMERGENCY button colour-coded by state (orange-red=ELAND, red=KILL)
    - gcs_button_panel.py: SW emergency active state persists until pressed again to reset
    - gcs_button_panel.py: HW EMERG countdown published per-second (KILL IN 3/2/1)
    - gcs_button_panel.py: HW command helpers publish individual message per drone matching SW
    - gcs_button_panel.py: rename VIS button to ARUCO EKF on all drone panels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
    [btn_test.py]
2026-04-16 feat: add HOME (RTB) button per drone with context-aware colours
    - Add HOME button below MISSION for each drone, publishing COMMAND_RETURN_HOME
    to /gcs/drone_{i}/command
    - Button enabled only when drone is airborne (mission / returning_home states)
    - Colour logic: blue = active state, green = action available, grey = disabled
    - mission state: MISSION blue, HOME green
    - returning_home state: MISSION green, HOME blue
    - armed state: MISSION green, HOME grey
    - MISSION button now also enabled in returning_home state to allow resuming
    - Add returning_home to strip colour map (green)
    - Fix shutdown crash: stop all QTimers before destroying rclpy node
    - Fix launch.sh: source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
2026-04-16 feat: integrate GCS commands into drone firmware via MAVLink and micro-ROS
    - Replace flat /gcs_command topic with per-drone /gcs/drone_{ID}/command,
    /gcs/drone_{ID}/config, and /gcs/drone_{ID}/control subscribers
    - ARM/DISARM, KILL (force), ELAND via MAV_CMD_COMPONENT_ARM_DISARM and NAV_LAND
    - Mission sequence FreeRTOS task: pre-arm OFFBOARD stream → climb → setpoint → land
    - Return-home FreeRTOS task: stream home NED position → land
    - Home position captured from vision pose on ARM command
    - SET_POSITION_TARGET_LOCAL_NED for OFFBOARD setpoint streaming at 20 Hz
    - VISION_POSITION_ESTIMATE forwarded to PX4 EKF2 (MAV_FRAME_LOCAL_NED)
    when CONFIG_VISION_ENABLE; quat→euler conversio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
    [main.c]
2026-04-16 fix: raise micro-ROS entity limits and resolve firmware build errors
    - colcon.meta: increase MAX_PUBLISHERS/MAX_SUBSCRIPTIONS from 2→5 and
    MAX_HISTORY from 1→4 to support 4 publishers + 4 subscribers required
    by the new GCS command/config/control/vision_pose topics; track
    colcon.meta in git via .gitignore exception
    - main.c: cast ip4addr_aton args to (ip4_addr_t *) to fix
    -Werror=incompatible-pointer-types on esp_netif_ip_info_t fields;
    rewrite compact same-line if chains to else-if to fix
    -Werror=misleading-indentation; set DRONE_ID=2 for this unit
    - launch-idf-docker.sh: point PROJECT_DIR at new repo path, remove sudo,
    add chown step to fix /code permission errors in Dock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
    [main.c]
2026-04-16 chore: add PX4 settings params and brochure reference snapshot
    - drone-firmware/PX4_settings.params: PX4 flight controller parameter
    export for the swarm drones
    - for broschure/: snapshot of source files and docs prepared for the
    project brochure
    [PX4_settings.params, generic_market.stl, marker.blend]
2026-04-16 chore: remove for broschure directory
    [generic_market.stl, marker.blend]
2026-04-17 feat: add C2 watchdog, ELAND disarm, waypoint arrow, and mission setpoints
    Drone firmware (main.c):
    - camera_streaming initialised to false (black-frame mode on boot)
    - ELAND: extract trigger_eland() helper + eland_task_fn that disarms
    after MISSION_LAND_DESCEND_MS — closes missing disarm after landing
    - Mission Phase 5: land on spot immediately, remove return-to-home stream
    - C2 watchdog: pings micro-ROS agent every 1 s with 500 ms timeout;
    2 consecutive failures (~2 s) triggers ELAND per competition rules
    - RViz waypoint arrow: 2-point ARROW from drone to setpoint with
    TEXT_VIEW_FACING label at midpoint, Z-staggered by DRONE_ID * 0.15 m
    GCS buttons (btn_test.py):
    - Subscribe to /d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
    [btn_test.py, main.c]
2026-04-17 fix: increase c2_watchdog stack size to 4096 to prevent overflow
    rmw_uros_ping_agent requires more stack than the initial 2048 bytes,
    causing a stack overflow crash on boot.
    [main.c]
2026-04-17 fix: remove camera drain when streaming disabled to prevent cam_task panic
    With CAMERA_GRAB_WHEN_EMPTY and fb_count=2 the driver stops capturing
    once buffers are full — draining is unnecessary. Periodic fb_get/return
    while camera_streaming=false was causing a FB-SIZE mismatch panic in
    the camera driver's internal cam_task.
    [main.c]
2026-04-17 fix: move C2 ping into micro_ros_task to prevent lwIP pbuf race condition
    rmw_uros_ping_agent called from a separate FreeRTOS task concurrently
    with rcl_publish caused a double-free in the lwIP pbuf stack, crashing
    the firmware. Moved the ping check inline into the micro_ros_task while
    loop so transport access is always single-threaded.
    [main.c]
2026-04-17 perf: reduce obstacle marker latency to 40 Hz, drop idle black frame
    - Add dedicated 25 ms obstacle_timer_callback so ToF distance labels
    publish at 40 Hz (matching sensor read rate) instead of 10 Hz
    - Remove black-frame publish when camera_streaming=false — the 19200-byte
    UDP payload every 100 ms was competing with obstacle markers in the
    executor loop and had no effect on ArUco detection (black frame never
    yields a marker detection anyway)
    - Executor handle count bumped from 5 to 6 (2 timers + 4 subscriptions)
2026-04-17 feat: publish single black frame with drone ID on camera disable
    On the streaming→off transition, timer_callback fires the black-frame
    generator exactly once then goes silent. Prevents the RViz viewer from
    freezing on the last live image while keeping executor bandwidth free.
    [main.c]
2026-04-17 fix: status line overwrites in-place, shorten sensor labels
    Add fflush(stdout) so the \r line is flushed before any ESP_LOG message
    can push the cursor to a new line. Shorten labels for compactness:
    RIGHT→RH, LEFT→LH, FRONT→FWD, VISION→VIS.
    [main.c]
2026-04-17 fix: reformat status line with pipe separators and correct sensor order
    Format: |LH|RH|FWD|TOP|STATE|VIS| with (cm) units per field.
    Sensor order corrected: LH=tof[2], RH=tof[0], FWD=tof[3], TOP=tof[1].
    STATE padded to 14 chars (covers "returning_home").
    [main.c]
2026-04-17 fix: hide waypoint arrow until vision_pose is valid
    Arrow tail (vp_x/y/z) defaults to 0,0,0 on boot. If a setpoint
    arrives before the first vision_pose message the tail is stuck at the
    map origin while the tip is at the drone's real position, producing a
    spurious 10-12 m diagonal. Guard with vision_pose_valid so the arrow
    only appears when both a setpoint and a confirmed drone position exist.
    [main.c]
2026-04-17 feat: phase arrows with drone ID label for takeoff, waypoint, landing
    Three state-gated 2-point ARROW markers, each with drone ID label at midpoint:
    - Takeoff (green): DRONE_MISSION while vp_z < takeoff altitude - 0.15 m
    - Waypoint (amber): DRONE_MISSION at altitude with valid setpoint
    - Landing (orange): DRONE_LANDING covers both NAV_LAND and ELAND/C2 loss
    publish_phase_arrow() helper updates points + label midpoint and publishes ADD.
    hide_phase_arrow() sends DELETE only once on the visible→hidden transition,
    avoiding repeated DELETE traffic when an arrow is already hidden.
    [main.c]
2026-04-17 fix: phase arrows not appearing in RViz
    Two bugs:
    1. All three arrows required vision_pose_valid which is false whenever
    ArUco times out (VISION_TIMEOUT_MS=1500ms). Replace with pos_known
    (last_vision_pose_ms > 0) for takeoff/landing — tolerates brief
    dropouts while still preventing the 0,0,0 tail bug. Waypoint arrow
    keeps vision_pose_valid since it needs a live position for direction.
    2. at_altitude check (vp_z >= 1.35) permanently blocked the waypoint
    arrow on vision systems that publish NED z (negative when airborne).
    Removed the altitude split — takeoff and waypoint arrows both show
    throughout DRONE_MISSION, which is more informative anyway.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
    [main.c]
2026-04-17 fix: show phase arrows regardless of vision state
    Log confirmed VIS:NO throughout entire flight — last_vision_pose_ms
    stays 0 when ArUco is not running, so pos_known check also blocked
    all arrows. Gate purely on drone state so arrows always appear during
    DRONE_MISSION and DRONE_LANDING regardless of vision availability.
    [main.c]
2026-04-20 fix: improve drone launch reliability and camera streaming
    - firmware: fix OV3660 gain=0 zeroing registers (use gain=1 minimum)
    - firmware: add Option 1 camera settings for noisy 2.4GHz ArUco detection
    - firmware: switch to CAMERA_GRAB_LATEST to eliminate stale frame lag
    - firmware: image publisher soft-fail with publisher_image_ok guard
    - firmware: change image publisher to best-effort QoS to prevent WiFi backlog
    - colcon.meta: increase RMW_UXRCE_XML_BUFFER_LENGTH 400→4000
    - gcs/btn_test: add 400ms ARM→MISSION guard with pending-retry loop
    - gcs/rqt: add 400ms ARM→MISSION guard with QTimer auto-retry
    - gcs/rqt: lock per-drone ARM buttons when hardware ARM is held
    - gcs/rqt: populate _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
    [btn_test.py, main.c]
2026-04-21 feat: integrate OpenCV ArUco marker detection on ESP32S3
    - Add aruco_task.cpp/h for onboard ArUco pose estimation
    - Add espressif/opencv ^4.10.0~3 IDF component dependency
    - Add custom partitions.csv and enable PSRAM BSS/stack to fit OpenCV
    - Wire aruco_task_start() into app_main after camera init
    - Expose vision globals and mav_send_vision_estimate for ArUco task
    [ant.ply, ape.ply, backyard.blend, bunny.ply, cow.ply, desktop.blend, funclist.csv, horse.ply]
2026-04-21 debug: add Xtensa static-init diagnostic probes to OpenCV core
    Add printf probes guarded by #ifdef __XTENSA__ to narrow down the
    ESP32S3 do_global_ctors crash location:
    - system.cpp: 7 step probes around each file-scope static initializer
    - logger.cpp: probe confirming TU static init completes (GlobalLoggingInitCall disabled for Xtensa)
    - parallel_impl.cpp: per-variable probes inside HAVE_PTHREADS_PF block
    - umatrix.cpp: probe at TU entry
    - utility.hpp: no-op cv::Mutex/AutoLock for Xtensa (OPENCV_DISABLE_THREAD_SUPPORT)
    - main.c: probe confirming app_main is reached
    [main.c]
2026-04-21 debug: add binary-search TU probes for do_global_ctors crash
    Adds 6 Xtensa printf probes to narrow down the TU crashing after
    [cv::logger] fires but before [cv::parallel] probes would appear:
    [cv::alloc] alloc.cpp
    [cv::mathfuncs] mathfuncs.cpp
    [cv::matrix_expressions] matrix_expressions.cpp
    [cv::norm] norm.cpp
    [cv::ocl] ocl.cpp
    [cv::parallel.cpp] parallel.cpp
    The first probe absent from the serial log identifies the crashing TU.
2026-04-21 fix: defer AllocatorStatistics construction to avoid do_global_ctors crash on ESP32-S3
    File-scope `static cv::utils::AllocatorStatistics` objects crash during
    `do_global_ctors` on Xtensa because the vtable pointer write to PSRAM
    happens before FreeRTOS/PSRAM is fully initialised.
    Convert both `allocator_stats` (alloc.cpp) and `opencl_allocator_stats`
    (ocl.cpp) to function-local statics so construction is deferred until the
    first call at runtime. Also skip the eager `g_force_initialization_memalign_flag`
    init on __XTENSA__ — `isAlignedAllocationEnabled()` uses its own magic static
    and is safe to call lazily.
2026-04-21 debug: add probes to narrow crash location beyond alloc.cpp on Xtensa
    alloc.cpp exit-confirmation probe + imgproc/utils (last alphabetically),
    imgproc/thresh, imgproc/accum (first alphabetically) probes.
    The post-alloc-exit probe confirms whether alloc.cpp itself completes
    cleanly; imgproc probes determine whether the next crashing TU is in
    imgproc and whether the reverse-alphabetical init order holds across
    module boundaries.
2026-04-21 debug: add thresh.cpp exit probe to confirm TU completes on Xtensa
2026-04-21 debug: add binary-search probes to imgproc TUs between thresh and accum
    Probes added to color_lab.cpp, imgwarp.cpp, and resize.cpp to bracket
    the crash occurring between thresh.cpp (confirmed clean) and accum.cpp
    (probe never fires). Init order is reverse-alphabetical:
    resize (r) → imgwarp (i) → color_lab (c)
2026-04-21 fix: skip eager LUT init in imgwarp.cpp on Xtensa at file scope
    initAllInterTab2D() calls AutoBuffer heap alloc, std::sin/cos before
    FreeRTOS scheduler — crashes in do_global_ctors on ESP32-S3. Guard
    with !defined(__XTENSA__) so tables are lazily initialized on first
    use via the existing inittab[] guard in initInterTab2D().
    Also add exit probe to confirm TU completes cleanly.
2026-04-21 cleanup: remove all ESP32-S3 static-init diagnostic probes
    Boot crash during do_global_ctors is fully resolved. Removing all
    #ifdef __XTENSA__ printf probes from core and imgproc TUs.
2026-04-21 debug: halt on panic to capture WDT backtrace
    TG1WDT_SYS_RST (interrupt watchdog) fires after WiFi init at runtime.
    Device reboots before backtrace can print. Add PRINT_HALT to stop on
    panic and show the full register dump + stack trace.
2026-04-21 debug: increase INT WDT timeout to capture full panic backtrace
    Level-2 INT WDT (2x level-1) fires and resets before panic handler can
    print. Increase from 300ms to 2000ms so the backtrace fully prints.
    Requires idf.py fullclean to regenerate sdkconfig from defaults.
2026-04-21 fix: restore INT WDT and raise timeout for WiFi crash diagnosis
    Removing CONFIG_ESP_INT_WDT=n — disabling the interrupt WDT left the
    ROM-level TG1 WDT running unfed (ESP-IDF startup only feeds TG1 when
    INT WDT is enabled), causing TG1WDT_SYS_RST during WiFi init at ~1.8s.
    Raise INT WDT timeout to 800ms so the panic handler can print the full
    backtrace before the level-2 hard-reset fires.
2026-04-21 fix: stop routing all BSS to PSRAM, use selective opencv_psram_bss.ld instead
    CONFIG_SPIRAM_ALLOW_BSS_SEG_EXTERNAL_MEMORY=y was moving every library's
    BSS (including WiFi net80211/pp DMA descriptors and ring buffers) into PSRAM.
    The ESP32-S3 DMA engine cannot access PSRAM, so WiFi init crashed with
    TG1WDT_SYS_RST immediately after "Init static tx buffer num: 16".
    The opencv_psram_bss.ld linker script already handles moving only OpenCV
    library BSS to PSRAM via INSERT BEFORE. The global flag is redundant for
    OpenCV and fatal for WiFi — remove it.
2026-04-21 fix: rescue WiFi/LwIP BSS to DRAM, re-enable ext_ram BSS for heap safety
    Root cause of WiFi crash (TG1WDT_SYS_RST at 'Init static tx buffer num: 16'):
    Two problems existed depending on CONFIG_SPIRAM_ALLOW_BSS_SEG_EXTERNAL_MEMORY:
    1. With it ENABLED: .ext_ram.bss captures ALL .bss (including WiFi DMA blob BSS)
    into PSRAM. WiFi DMA ring buffers in PSRAM → DMA engine can't reach them →
    WiFi abort → panic → crash.
    2. With it DISABLED (our previous attempt): esp_psram_extram_heap_add() starts
    the PSRAM heap at SOC_EXTRAM_DATA_LOW (0x3D000000). opencv_psram_bss.ld also
    places .opencv.bss at 0x3D000000. Heap TLSF metadata overwrites OpenCV BSS
    at boot → memory corruption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
2026-04-21 fix: route OpenCV BSS to PSRAM, zero-init before WiFi
    opencv_psram_bss.ld: use INSERT BEFORE .dram0.bss (not .ext_ram.bss)
    so extern_ram_seg is valid at parse time; capture all OpenCV library
    BSS/COMMON into .opencv.bss with boundary symbols for zero-init.
    With CONFIG_SPIRAM_ALLOW_BSS_SEG_EXTERNAL_MEMORY=y the PSRAM heap
    starts at _ext_ram_bss_end (after our BSS), eliminating the
    heap-metadata/OpenCV-BSS overlap that caused the TG1WDT WiFi crash.
    app_main: memset [_opencv_psram_bss_start, _opencv_psram_bss_end]
    before WiFi init so OpenCV static tables start clean.
    [main.c]
2026-04-21 fix: INSERT BEFORE .ext_ram.bss so OpenCV BSS lands in real PSRAM
    extern_ram_seg and drom0_0_seg share the same bus/address space on
    ESP32-S3 (both origin 0x3c000020). sections.ld uses .ext_ram.dummy
    to advance the pointer past the flash-mapped DROM content to the first
    actual PSRAM address before .ext_ram.bss is placed.
    INSERT BEFORE .dram0.bss fired before .ext_ram.dummy ran, leaving the
    extern_ram_seg pointer at 0x3c000020 (read-only flash) — memset to that
    address faulted, causing TG1WDT_SYS_RST on every boot.
    INSERT BEFORE .ext_ram.bss fires after .ext_ram.dummy has positioned
    the pointer at real PSRAM, so .opencv.bss now lands at ~0x3c5a0000.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
2026-04-21 fix: route OpenCV BSS to PSRAM via linker fragment (extram_bss)
    Replace custom opencv_psram_bss.ld INSERT script with an ESP-IDF linker
    fragment file (linker.lf) that maps all OpenCV library BSS/COMMON into
    .ext_ram.bss using the standard extram_bss scheme.
    The INSERT script approach placed OpenCV BSS outside [_ext_ram_bss_start,
    _ext_ram_bss_end], causing esp_psram.c to start the PSRAM heap inside the
    OpenCV BSS region. The memset in app_main then zeroed the PSRAM heap's
    TLSF metadata, corrupting every subsequent heap allocation and manifesting
    as ESP_ERR_NO_MEM in WiFi init.
    With linker fragments, OpenCV BSS is inside .ext_ram.bss. esp_psram.c
    correctly advances the heap start past the f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
    [main.c]
2026-04-21 fix: init camera before WiFi to avoid DRAM heap fragmentation
    WiFi static TX/RX buffers (16×1600B + management buffers) fragment the
    DRAM heap before camera init, leaving the largest contiguous block at
    15 KB — smaller than the camera DMA ring buffer (30720 B).
    Moving esp_camera_init() to before uros_network_interface_initialize()
    claims the contiguous 30 KB block from the fresh, unfragmented heap.
    Camera uses its own SCCB port (I2C0, pins 40/39) with no runtime
    dependencies before this point.
    [main.c]
2026-04-21 fix: resolve WiFi init OOM when camera DMA and WiFi coexist in DRAM
    Camera DMA ring (30 720 B) consumed 94 % of the 32 KB DMA-capable
    internal DRAM pool (SPIRAM_MALLOC_RESERVE_INTERNAL), leaving < 2 KB
    for WiFi static RX buffer allocation → esp_wifi_init() abort.
    - sdkconfig.defaults: double DMA pool to 64 KB so camera (30 720) +
    WiFi static RX (10 × 1 600 = 16 000) fit with 18 KB headroom
    - sdkconfig.defaults: add WiFi dynamic TX / reduced static RX tuning
    (belt-and-suspenders, primary fix is the pool size)
    - main.c: move esp_camera_init() before WiFi to claim the 30 KB DMA
    ring from the unfragmented heap; defer aruco_task_start() to after
    WiFi so task stacks don't compete with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
    [main.c]
2026-04-22 fix: run ArUco detector end-to-end with PSRAM stacks and 80×60 detection
    All tasks now start and ArUco marker detection works (VIS:OK).
    Key changes:
    - aruco_task.cpp: use xTaskCreateStaticPinnedToCore with EXT_RAM_BSS_ATTR
    stacks for both cam and det tasks — only ~2 KB internal DRAM was free at
    boot so dynamic stack alloc always failed silently (return unchecked)
    - aruco_task.cpp: TCBs kept in internal DRAM (xPortCheckValidTCBMem requires it)
    - aruco_task.cpp: downsample 160×120 → 80×60 in cam task before queuing;
    reduces detectMarkers cost from ~5 s to ~300 ms per frame
    - aruco_task.cpp: allocate 4800-byte fast_frame in internal DRAM for OpenCV
    pixel ops — PSRAM random-acc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
    [main.c]
2026-04-22 fix: update ArUco marker size to 50 cm, improve console output, fix cam_task stack overflow
    - Set MARKER_SIZE_M to 0.50 m for 50×50 cm physical markers (was 0.15 m)
    - Replace pos=(x,y,z) log with dist/yaw/pitch/detection-ratio for situational awareness
    - Set CONFIG_CAMERA_TASK_STACK_SIZE=4096 — default 2048 B overflows during FB-OVF handling
    - Fix duplicate else clause in gcs_button_panel.py mission_all_btn handler
2026-04-22 fix: gate OV3660 180° flip on sensor PID — do not flip OV2640
    Previously vflip+hmirror was applied unconditionally to all cameras.
    Now checks sensor PID: OV3660 (mounted 180° rotated) gets hardware flip,
    OV2640 (mounted correctly) gets none. Console logs which path was taken.
    [main.c]
2026-04-22 fix: per-sensor ArUco params and exposure to fix OV3660 false positives and missed detections
    OV3660 heavy downscaling (2048x1536 → 80x60) produces noisier bit patterns
    than OV2640, causing ghost IDs (e.g. ID 17) and poor detection rate.
    - Tighten errorCorrectionRate to 0.3 for OV3660 (vs 0.6 for OV2640)
    - Reduce adaptiveThreshWinSizeMax to 11 for OV3660 noise profile
    - Raise minMarkerPerimeterRate from 0.05 to 0.10 for both sensors
    - Set aec_value=200 for OV3660, 400 for OV2640 (different exposure scales)
    [main.c]
2026-04-22 docs: document dual camera support and per-sensor ArUco settings in README
2026-04-22 fix: revert OV3660 detection params — errorCorrectionRate=0.3 was too strict
    Strict errorCorrectionRate prevented any detection on OV3660 because heavy
    downscaling (2048x1536 → 80x60) blurs edges and legitimate markers need the
    full correction budget. Reverted to 0.6 for both sensors.
    Also re-enable AEC for OV3660: manual aec_value=200 was making the image too
    dark. OV3660 exposure register scale differs from OV2640 and needs calibration
    before a fixed value can be used safely.
    [main.c]
2026-04-22 fix: apply OV3660 flip last — gain/exposure writes reset image option registers
    Some OV3660 register writes (set_gain_ctrl, set_exposure_ctrl) trigger an
    internal set_image_options call that clears previously written flip bits.
    Moving set_vflip + set_hmirror to after all other register writes ensures
    the 180° correction is always the final state.
    [main.c]
2026-04-22 fix: apply 180° flip unconditionally — both OV2640 and OV3660 are mounted rotated
    Both sensors are physically mounted 180° rotated on the drone frame.
    Previously gating the flip on OV3660_PID left OV2640 streams rotated on GCS.
    Flip is applied last in init to prevent OV3660 register writes from clearing it.
    [main.c]
2026-04-22 fix: rotate streamed image 180° in software during downsampling
    Hardware flip registers do not reliably affect the streaming pipeline.
    Reverse pixel indices in the 160x120 → 80x60 downsampling loop to apply
    180° rotation in software. Detection pipeline is unaffected.
    [main.c]
2026-04-22 revert: remove software 180° rotation from streaming — hardware flip is working
    Hardware set_vflip + set_hmirror correctly orients the streamed frames.
    The software pixel reversal was double-rotating back to wrong orientation.
    [main.c]
2026-04-22 fix: software 180° rotation for OV3660 stream — hardware flip does not persist
    OV2640 hardware flip works reliably. OV3660 flip bits are cleared by
    subsequent register writes and cannot be made to persist. Added
    camera_rotate_180 flag set at init, used in streaming downsampling loop
    to reverse pixel indices for OV3660 only.
    [main.c]
2026-04-22 fix: disable AEC on OV3660 so hardware flip persists — remove software rotation
    OV3660 AEC continuously rewrites TIMING_TC_REG20/21 (flip registers) as
    part of its exposure loop, clearing vflip+hmirror after init. Disabling AEC
    with aec_value=300 (tune 150-500 to ambient) allows hardware flip to persist.
    Software rotation fallback and camera_rotate_180 flag removed.
    [main.c]
2026-04-22 fix: software 180° rotation for OV3660 stream — hardware flip non-functional
    OV3660 AEC continuously rewrites TIMING_TC_REG20/21 (the vflip/hmirror
    registers), so hardware flip bits do not persist regardless of AEC being
    disabled. Rotate 180° by reversing pixel indices in the streaming
    downsampling loop instead. OV2640 hardware flip works reliably and is
    unchanged.
    [main.c]
2026-04-22 fix: OV3660 stream — software vflip only, hmirror persists via hardware
    AEC clears the vflip bit (TIMING_TC_REG20) but leaves hmirror intact.
    Previous fix reversed both x and y, double-applying hmirror and leaving
    the image horizontally mirrored when the camera was panned. Now only
    y is reversed in software; hardware handles the horizontal mirror.
    [main.c]
2026-04-22 tune: OV3660 ArUco params — smaller window, stricter error correction
    Heavy downscaling (2048×1536 → 80×60) makes OV3660 images noisier than
    OV2640 at the same resolution. Apply per-sensor params at runtime:
    adaptiveThreshWinSizeMax: 15 → 11 (matches OV3660 noise profile)
    minMarkerPerimeterRate: 0.10 → 0.12 (rejects sub-10 px noise blobs)
    errorCorrectionRate: 0.6 → 0.5 (stricter bit-pattern matching)
    OV2640 params unchanged. Log line now prints all three active values.
2026-04-22 fix: OV3660 ArUco — Gaussian blur before detection, revert tighter params
    Tighter detector params (Option 1) reduced false positives but also
    eliminated real detections — OV3660's heavy downscaling blurs marker
    edges beyond what param tuning can recover.
    Apply a 3×3 Gaussian blur (OV3660 only) before detectMarkers so the
    adaptive threshold finds real edges instead of noise spikes. Detector
    params reverted to OV2640 values (errorCorrectionRate=0.6) to give
    markers the full correction budget.
2026-04-22 fix: 2×2 averaging downsampling for ArUco cam task + increase cam_task stack
    OV3660 point-sampled 80×60 frames have high noise — Gaussian blur on the
    result was smoothing aliasing artifacts, not the original pixel noise.
    Replace point sampling with 2×2 box-filter averaging in aruco_cam_task_fn:
    each output pixel = mean of the 2×2 input block. Suppresses noise at source
    before the blur in aruco_task_fn runs, improving edge contrast for detection.
    Increase CONFIG_CAMERA_TASK_STACK_SIZE 4096 → 6144 to handle bursts of
    consecutive FB-OVF events without cam_task stack overflow.
2026-04-22 fix: add CLAHE after Gaussian blur for OV3660 ArUco detection
    Heavy downscaling (2048×1536 → 80×60) collapses local contrast — blur
    alone reduces noise but doesn't recover the lost edge contrast needed
    by detectMarkers' adaptive threshold.
    Add CLAHE (clipLimit=2.0, tileSize=8×8) after the Gaussian blur for
    OV3660. CLAHE redistributes intensity locally so marker edges become
    detectable without amplifying the noise the blur already suppressed.
2026-04-22 fix: CLAHE output to internal DRAM — prevent PSRAM bus starvation on Core 0
    CLAHE's default allocator uses PSRAM (SPIRAM_USE_MALLOC=y), causing
    detectMarkers to run on a PSRAM-backed Mat (~5 s/frame). The continuous
    PSRAM bus traffic on Core 1 starved Core 0 micro-ROS of memory bandwidth,
    causing ping timeouts and stream drops immediately after detection.
    Allocate a dedicated internal DRAM buffer (clahe_buf, 4800 B) at task
    init and pass it as the CLAHE output Mat. detectMarkers now always runs
    on internal DRAM regardless of preprocessing path.
2026-04-22 fix: move clahe_buf declaration after is_ov3660 — build error
    clahe_buf allocation used is_ov3660 before it was declared in scope.
    Reorder: is_ov3660 first, then clahe_buf conditional malloc.
2026-04-22 fix: disable OV3660 DNR and maximise contrast/sharpness for ArUco
    OV3660 default register 0x5306=0x1c enables digital noise reduction at
    boot. DNR blurs edges — exactly the opposite of what ArUco's adaptive
    threshold needs. OV2640 has no DNR block, which is why it produces
    visibly higher-contrast images with the same firmware settings.
    For OV3660: disable DNR (set_denoise=0), contrast 2→3, sharpness 2→3.
    OV2640 settings unchanged.
    [main.c]
2026-04-22 revert: remove OV3660 SW preprocessing — hardware DNR disable makes it counterproductive
    Now that OV3660 DNR is disabled and contrast/sharpness are at max in HW,
    Gaussian blur + CLAHE were blurring a hardware-sharpened image, degrading
    the edges detectMarkers needs. Also revert cam task to point sampling —
    same pipeline as OV2640, which works without any SW preprocessing.
2026-04-22 fix: reliable first-shot arm and mission without GPS
    Three changes to fix PX4 arming and mission reliability when flying
    without GPS or VISION_POSITION_ESTIMATE:
    1. Prearm setpoint stream: start streaming SET_POSITION_TARGET_LOCAL_NED
    at 20 Hz the moment COMMAND_ARM is received, before MISSION_START.
    Gives PX4 EKF2 the maximum convergence time (ARM→MISSION gap + Phase 1).
    Task exits naturally when drone transitions out of DRONE_ARMED.
    2. OFFBOARD → ARM order (was ARM → OFFBOARD): PX4 waives the "no valid
    global position estimate" pre-arm check once OFFBOARD mode is active
    with setpoints flowing. Setpoints continue streaming during the 500 ms
    OFFBOARD settle window s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
    [main.c]
2026-04-22 fix: auto-restart on C2 loss while disarmed for clean micro-ROS reconnect
    When the micro-ROS agent connection drops while the drone is disarmed
    or killed (safely on the ground), call esp_restart() instead of doing
    nothing. This gives a clean XRCE-DDS session on reconnect so rqt shows
    the drone online without requiring a manual power cycle.
    Previously, a brief connection drop on first battery boot left the
    micro-ROS spin loop running but silently undelivered — the drone
    appeared offline in rqt until a second power cycle re-established a
    stable session.
    In-flight C2 loss (armed, mission, returning home) still triggers
    emergency landing as before.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
    [main.c]
2026-04-22 feat: swarm mission script — forward / rotate 180° / back
    Firmware (main.c):
    - Add mav_set_position_yaw_ned(): SET_POSITION_TARGET_LOCAL_NED with
    position + yaw (type_mask 0b0000101111111000). Yaw extracted from
    pose.orientation quaternion in control_callback and stored as
    setpoint_yaw (radians, NED convention, 0 = North CW positive).
    - Phase 4 hover loop now calls mav_set_position_yaw_ned so the drone
    follows both position and heading from /gcs/drone_X/control.
    - setpoint_yaw reset to 0 on each COMMAND_MISSION_START.
    - MISSION_MAX_HOVER_MS = 15 min safety timeout replaces fixed 3 s dwell.
    Python (ground-station-software/swarm/mission_forward_back.py):
    - Waits for drone to enter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
    [main.c]
2026-04-22 feat: battery status on rqt drone title via PX4 MAVLink BATTERY_STATUS
    Firmware: add a MAVLink UART RX task (mav_rx) that parses incoming
    BATTERY_STATUS messages from PX4 and stores battery_remaining_pct.
    Publish /drone_{ID}/battery (std_msgs/Int8, 0-100, -1=unknown) every 5 s
    from the existing 100 ms timer callback.
    rqt: subscribe to /drone_{i}/battery (Int8) for each drone; update the
    title label to "D1 BAT:87%" with colour coding (red <20%, orange <40%,
    default otherwise). Falls back to plain "D1" when value is -1/unknown.
2026-04-23 fix: drone 2 bringup — init order, memory, I2C crash, mav_rx stack
    - WiFi init before camera in app_main: WiFi static DMA buffers (9.6 KB)
    claim the 64 KB reserved DMA pool first; camera DMA ring (30 KB) then
    falls to the unfragmented main DRAM heap and succeeds
    - SPIRAM_TRY_ALLOCATE_WIFI_LWIP=y routes WiFi/LwIP dynamic allocs to PSRAM,
    keeping main DRAM contiguous for the camera DMA allocation
    - Add CONFIG_ESP_WIFI_STATIC_TX_BUFFER=y / STATIC_RX_BUFFER=y as explicit
    Kconfig choice prerequisites so buffer counts (6/6) apply on fresh builds
    - mav_rx task stack 2048 → 4096 B — fixes stack overflow during MAVLink parsing
    - VL53L1X I2C: replace heap-allocated cmd_link with a static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
    [i2c_platform_esp.c, main.c]
2026-04-23 fix: rqt panel version label, window focus, and MISSION ALL guard fixes
    - Add version label (v1.3.1) to bottom-right of panel
    - Call raise_() and activateWindow() so panel comes to foreground on launch
    - Fix MISSION ALL: send to ready drones immediately, then retry pending ones
    (previously drones past the ARM guard were silently dropped when others were pending)
    - Add returning_home to ARMED_STATES in hw_arm_callback so ARM ALL button
    stays active during return-home phase
2026-04-23 feat: L-loop flight path for two drones in parallel
    Replace the simple forward/rotate/back path with a full L-loop sequence:
    fwd 1m → rotate -90° → fwd 2m → climb 3m → rotate -90° → fwd 1m →
    rotate -90° → fwd 2m → descend 0.5m → return home
    Launcher updated to run D1 and D2 simultaneously with prefixed output
    ([D1]/[D2]) instead of a single configurable drone ID.
    Node name is now drone-ID-scoped (swarm_mission_forward_back_d{ID}) so
    both instances can run without ROS node name conflicts.
2026-04-23 feat: rqt panel — drone OFFLINE detection via heartbeat watchdog
    Add a 1 Hz staleness timer that marks each drone panel OFFLINE when no
    /drone_{i}/state message has been received for >3 s. OFFLINE drones show
    a dim strip, greyed-out state label, and have ARM/MISSION/HOME buttons
    disabled until the drone reconnects. Controls and colours restore
    automatically on the next incoming state message. Bumps version to 1.3.2.
2026-04-23 fix: unique micro-ROS client key per drone + set DRONE_ID=2
    - rmw_uros_options_set_client_key(DRONE_ID): each drone registers a unique
    XRCE-DDS session with the agent; without this both drones use the same
    default key and the agent conflates them, causing one to drop offline
    when the other connects
    - DRONE_ID 1 → 2 for the second drone hardware unit
    [main.c]
2026-04-23 fix: state publish every 2 s to stay under 3 s GCS offline timeout
    Previous 5 s interval caused drones in stable state (DISARMED / MISSION
    with no transitions) to be marked OFFLINE by the GCS heartbeat watchdog.
    Reduces to 20 × 100 ms = 2 s, giving 1 s headroom. DRONE_ID reset to 1.
    [main.c]
2026-04-24 fix: lower C2 ping timeout to 100 ms and drop RViz phase arrows
    - C2_PING_TIMEOUT_MS 500 → 100: cuts worst-case executor blocking from
    1 s/s to 200 ms/s so arm/mission callbacks stop being missed when
    multiple drones share the agent.
    - Removed takeoff / waypoint / landing arrow markers and their helpers
    to declutter RViz during flight.
    [main.c]
2026-04-27 feat: drone-vision — ESP32S3 ArUco FPS benchmark (OV3660, OpenCV, PSRAM)
    - New drone-vision project: stripped-down ESP-IDF app with espressif/opencv
    and esp32-camera only (no micro-ROS, no MAVLink, no VL53L1)
    - 4-stage ArUco benchmark: QQVGA → QVGA → HVGA → VGA, prints FPS/hit%/
    latency table + CSV over USB-serial, auto-restarts after 10 s
    - OV3660 support: DNR disabled, sharpness=2, correct board pin macros
    - psram_bss_scheme component: provides [scheme:extram_bss] linker fragment
    so OpenCV BSS (~500 KB) routes to PSRAM without requiring esp_wifi
    - fix: fast_buf sized per-stage (not max VGA) so DRAM fast-path works for
    QQVGA/QVGA/HVGA; VGA falls back gracefully with named wa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
    [partitions.csv]
2026-04-27 feat: drone-vision — on-board ArUco pose estimator (aruco_pose mode)
    Adds CONFIG_VISION_MODE_POSE build target alongside existing BENCH mode.
    aruco_pose.cpp ports aruco_node.py to bare ESP32-S3: continuous QVGA/QQVGA/HVGA
    capture, DICT_4X4_50 detection, per-marker dist/H/V angles, multi-marker
    world pose via solvePnP, output over USB-serial at 115200.
    SDC26 arena map hardcoded (25 markers, 0.50 m side, yaw-facing).
    Fallback default for POSE_MARKER_SIZE_CM so bench mode still compiles.
    Fix container volume-mount stale state by tracking all source in host mount.
    [aruco_pose.cpp, aruco_pose.h, main.c]
2026-04-27 fix: aruco_pose — stack overflow, OV3660 mirror, FPS optimisation
    - Spawn aruco_pose in 32 KB FreeRTOS task on CPU1 (fixes main_task
    stack overflow from cv::Mat / std::vector / solvePnP allocations)
    - OV3660: set_hmirror(0) + set_vflip(1) — mirrored image prevented
    ArUco bit-pattern matching; OV2640 was unaffected
    - Reduce adaptiveThreshWinSizeMax 23→7 (2 window sizes vs 6): ~3×
    faster detection at QQVGA; confirmed ~5 FPS vs ~1 FPS before
    - Pre-allocate ids/corners/rejected vectors outside detect loop to
    eliminate per-frame heap alloc/free overhead
    - Add FPS + det_ms to heartbeat log for performance monitoring
    - Kconfig: default pose resolution QVGA→QQVGA (19 KB fits in DRAM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
    [aruco_pose.cpp, main.c]
2026-04-27 feat: rolling single-line console status + pose as default mode
    Output overwrites the same terminal line every frame:
    [f=142] 2M: M1:1.83m(-5/+13) M3:2.10m(+2/-3) | x=4.23 y=2.14 z=0.50 5.4fps
    [f=143] --- no markers --- 5.1fps
    Uses \r\033[K so no scrolling; fflush(stdout) after each frame.
    FPS computed over 30-frame rolling window; det_ms removed (was per-heartbeat).
    mbuf pre-allocated static char[160] — no heap alloc in hot path.
    Kconfig: default mode changed from BENCH → POSE.
    sdkconfig.defaults: pin CONFIG_VISION_MODE_POSE=y so fullclean + rebuild
    never reverts to bench mode.
    vision_bench.cpp: #ifndef fallbacks so it compiles in pose mode.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
    [aruco_pose.cpp, main.c]
2026-04-27 feat: compact single-line console output for pose mode
    Drop frame counter, shorten distance to 1 decimal, remove marker count
    prefix. New format: M1:1.8(-5/+13) M3:2.1(+2/-3) > 4.23,2.14,0.50 5fps
    No-marker line: --- 5fps
    [aruco_pose.cpp]
2026-04-27 feat: simplify console output to marker ID + distance only
    Remove angles, world pose, fps from rolling status line.
    Output: M1:1.23m M3:2.45m (or --- when no markers).
    Drops world-pose solvePnP call each frame, freeing ~5ms CPU.
2026-04-27 feat: add fps back to console output, update every 10 frames
    fps_last persists between updates so it always shows a value.
    Update interval 30→10 frames so reading refreshes ~3× faster.
    Helps diagnose actual detection rate vs perceived 2s delay.
2026-04-27 feat: multi-drone ARM fix, inertial position tracking, L-loop showcase modes
    - Reduce C2 ping timeout to 100 ms (was 500 ms) so rmw_uros_ping_agent
    blocks the executor for at most 200 ms — well within the 400 ms GCS
    ARM_MISSION_GUARD window that determines which drones enter mission
    - Add publish_state_now() helper for immediate state publish from within
    executor callbacks; replaces state_dirty flag on ARM/DISARM/MISSION_START/
    RETURN_HOME/KILL so GCS sees state changes without waiting for next timer tick
    - Capture PX4 home position on ARM for inertial displacement tracking
    - Parse LOCAL_POSITION_NED from PX4 MAVLink RX task; negate z (NED→up-positive)
    - Update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
    [main.c]
2026-04-27 feat: bind-mount sdkconfig to host filesystem
    sdkconfig is now stored in drone-vision/sdkconfig on the Pi5.
    Avoids needing to enter the container to delete it after git pulls.
2026-04-27 feat: print detection line only when markers found, no fps
    Silent when no markers detected. Each detection prints a new line.
    Removes fps counter and ANSI escape sequences entirely.
2026-04-27 perf: single adaptive threshold window + raise min perimeter rate
    - adaptiveThreshWinSizeMin/Max both 7: one threshold pass instead of two,
    halving the most expensive detector step (~40% faster overall)
    - minMarkerPerimeterRate 0.10→0.35: rejects blobs <14px/side early,
    eliminating noise contours before any ArUco decode work
    - cornerRefinementMethod=NONE: explicit, guards against future default change
    Expected result: ~8-10fps at QQVGA for 50cm markers at 0.5-5m range.
    [aruco_pose.cpp]
2026-04-27 fix: lower minMarkerPerimeterRate 0.35→0.20, restores 4m detection
    0.35 was cutting off markers at 4m due to focal-length uncertainty in
    the hardcoded fx=140 estimate. 0.20 covers ~8m with safe margin.
    [aruco_pose.cpp]
2026-04-28 feat: switch ESP32-P4 camera to esp_cam_ctlr_csi API (Option D)
    Replace the esp_video V4L2 layer with the low-level esp_cam_ctlr_csi
    API, matching the official Espressif mipi_isp_dsi example. This
    eliminates the esp_video_buffer_element PSRAM uninit crash entirely:
    Old path: esp_video_init → /dev/video0 MMAP → on_get_new_trans reads
    ELEMENT_SIZE(element) → dereferences element->video_buffer (PSRAM
    garbage 0x00138800) → buflen=1.2 GB → esp_cache_msync overflow crash
    New path: I2C/SCCB + OV5647 detect → ISP (RAW8→RGB565) → CSI ctlr →
    fixed PSRAM frame buffer → esp_cam_ctlr_receive() per frame
    - aruco_pose.cpp: sensor init loop (esp_cam_sensor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
    [aruco_pose.cpp]
2026-04-28 chore: add ESP32P4/S3 full project, launchers, and desktop shortcuts
    Includes everything not staged in the previous commit:
    ESP32-P4:
    - CMakeLists.txt, Dockerfile, docker-compose.yml
    - main.c, aruco_pose.h, boards.h, Kconfig.projbuild
    - sbss_psram.lf, sbss_extram.ld, partitions.csv
    ESP32-S3:
    - Full project: CMakeLists.txt, Dockerfile, docker-compose.yml
    - main.c, aruco_pose.cpp/h, vision_bench.cpp/h, boards.h
    - idf_component.yml, Kconfig.projbuild, partitions.csv
    - sdkconfig, sdkconfig.defaults
    Launchers (ubuntu-gnome-pc and ubuntu-xfce-pi5):
    - Desktop .desktop shortcut files for GCS, Vision, Swarm Mission, IDE
    - launch-*.sh scripts for P4/S3 vision, swarm mission, node IDE
    - README.md fi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
    [partitions.csv]
2026-04-30 feat: ESP32-P4 binary stream camera viewer working (CAMERA_VIEW_MODE)
    Switch camera_view_mode() from hex-text protocol to binary streaming:
    - Protocol: [0xAA][0x55][0x50][0x3C] + 80x60x2 raw RGB565 per frame
    - Camera stays STREAMON always (no per-frame stop/start → no overheating)
    - fwrite() sends whole frame atomically — ISP log interleaving harmless
    - stream_view.py resyncs on magic header after any stray log bytes
    - ~9 fps at 921600 baud (vs 1 fps at 115200 with hex protocol)
    Also includes full ESP32-P4 V4L2 camera stack (OV5647 MIPI-CSI, ISP
    pipeline controller, PSRAM frame buffers, ArUco pose estimation).
    [aruco_pose.cpp, main.c, stream_view.py, view_frame.py]
2026-04-30 fix: silence ISP log stripes in binary stream with null vprintf
    esp_log_level_set("*", ESP_LOG_NONE) filters by log level but some ISP
    and CSI driver tasks bypass it via direct uart_write_bytes(), producing
    rainbow noise stripes in the RGB panels of stream_view.py.
    Replace the vprintf function pointer with a no-op lambda — this is the
    only path guaranteed to intercept all log output before it reaches UART.
    [aruco_pose.cpp]
2026-04-30 fix: 8-byte magic prevents false-sync mid-frame in stream_view.py
    The 4-byte magic [0xAA][0x55][0x50][0x3C] can appear as valid RGB565
    pixel values in ordinary image data, causing stream_view.py to
    false-sync partway through a frame and display it as stacked fragments
    with rainbow noise between them.
    Expand magic to 8 bytes: AA 55 A5 5A F0 0F 50 3C
    P(false match in 9600-byte frame) < 10^-15.
    Also silences ISP log output completely via esp_log_set_vprintf(null
    lambda) to prevent any stray bytes corrupting the binary stream.
    [aruco_pose.cpp, stream_view.py]
2026-04-30 feat: switch OV5647 to 800x640 mode, fix stream_view frame dimensions
    Sensor mode: RAW8 800x800 → RAW8 800x640 (50fps, closer to standard
    640x480 Full Frame mode; ~20% fewer pixels → lower ISP heat).
    Stream viewer output: 80x60 → 80x64 (exact 10x downscale of 800x640,
    preserves correct 5:4 aspect ratio; avoids fractional row sampling).
    stream_view.py: updated W,H and docstring to match new frame size.
    [aruco_pose.cpp, stream_view.py]
2026-04-30 fix: sync_to_magic uses len(MAGIC) not hardcoded 4
    Buffer was trimmed to [-4:] while MAGIC grew to 8 bytes —
    buf could never equal MAGIC so sync never succeeded.
    [stream_view.py]
2026-04-30 fix: extend ISP convergence delay 3s→5s, improve log suppression comment
    Bright light sources trigger fast AE/AWB adjustments which produce
    log bursts. Extra 2 s lets the ISP AE/AWB loop fully settle before
    binary streaming begins, reducing residual noise stripes.
    [aruco_pose.cpp]
2026-05-01 feat: resolution select via #define in aruco_pose.cpp, stream detection crop
    - main.c: add /* ── Identity */ block with #define DRONE_ID 1 (matches S3 pattern)
    - aruco_pose.cpp: replace Kconfig VISION_POSE_RES with VISION_RES_QVGA /
    VISION_RES_HVGA defines at top of file; adds VIEW_W/VIEW_H for stream output
    - aruco_pose.cpp: camera_view_mode now streams the detection crop region
    (same center-crop as ArUco detector) instead of raw 800×800 downscale
    - aruco_pose.cpp: protocol adds 4-byte W×H header after magic so viewer
    auto-adapts to resolution without changes
    - aruco_pose.cpp: fix intrinsics scale to use cap_w (from V4L2) not stale POSE_W=1280
    - Kconfig.projbuild: remove VISION_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
    [aruco_pose.cpp, main.c, stream_view.py]
2026-05-02 feat: ESP32P4 ArUco world-pose estimation enabled
    Disable CAMERA_VIEW_MODE to activate OpenCV ArUco detection.
    For each detected known marker, compute camera world position via
    R_lw * (-R_l2c^T * t) + t_marker and average across all visible
    known markers. Quaternion taken from closest marker. Output:
    M7:2.34m M9:3.10m POSE:2:7.230:3.456:1.512:0.001:-0.003:0.707:0.707
    Remove unused-function pragma suppressions from find_marker() and
    rot_to_quat() since both are now called in the detection loop.
2026-05-02 feat: DETECTION_STREAM mode — live annotated view + POSE overlay
    Firmware (aruco_pose.cpp / CMakeLists.txt):
    - Add DETECTION_STREAM define (enabled by default alongside ArUco detection)
    - After each detection cycle, draw detected marker outlines (white lines)
    onto fast_frame, downsample 320×240 → 80×60, convert gray→RGB565, and
    send as a binary frame using the same magic+W×H+pixels protocol as
    CAMERA_VIEW_MODE — runs every frame so viewer stays live with no markers
    - Restructure ids.empty() early-exit into if(!ids.empty()) wrapper so the
    binary stream unconditionally follows the per-marker POSE block
    Viewer (stream_view.py):
    - sync_to_magic() now captures printable bytes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
2026-05-02 fix: DETECTION_STREAM use color thumbnail not fast_frame
    fast_frame is overwritten in-place by detectMarkers via adaptive
    thresholding — the output is a binary (black/white) image, producing
    the checkerboard artifact in the viewer.
    Switch to s_color_thumb (80×60 RGB888), which is built every frame
    from the raw ISP data before detectMarkers runs and is never touched
    by the detection pipeline. Convert RGB888→RGB565 for the stream and
    scale marker corner coordinates from detection (320×240) to view (80×60).
    [aruco_pose.cpp]
2026-05-02 fix: DETECTION_STREAM use raw ISP snapshot instead of s_color_thumb
    s_color_thumb was unreliable for streaming: it applies the aggressive
    98th-percentile normalization (ns), may be placed in PSRAM by the linker,
    and the RGB888→RGB565 re-encode introduced additional unknowns.
    Replace with det_snap: a static uint16_t[VIEW_W*VIEW_H] buffer filled
    once per frame in the STREAMOFF window from the raw ISP buffer using the
    exact same crop+downsample code as CAMERA_VIEW_MODE (which the viewer
    confirmed correct). The format is identical — raw ISP RGB565 uint16 LE —
    so no decode changes are needed in stream_view.py.
    [aruco_pose.cpp]
2026-05-02 fix: restore original 3-panel stream_view.py + add POSE overlay
    Restore the exact working layout from commit 947cc94:
    - Three panels: RGB565→RGB | RGB565→BGR (swapped) | Luminance Y
    - Up to 32× brightness amplification for dark scenes
    - R/G/B mean + max + DARK/BRIGHT/OK status line
    New additions on top:
    - sync_to_magic() now captures text lines between binary frames and
    parses M:/POSE: output from DETECTION_STREAM firmware mode
    - Cyan POSE overlay (top-left of first panel) shows world position
    x/y/z when a known marker is visible, marker distances otherwise
    [stream_view.py]
2026-05-02 fix: DETECTION_STREAM use ns-normalised fast_frame not raw ISP
    Root cause: STREAMOFF every frame prevents ISP auto-exposure from
    converging. Raw ISP pixels are very dark; stream_view.py's 32x
    brightness amplification then turns tiny noise into colourful pixels.
    Fix: snapshot fast_frame (already corrected to 0-255 by the 98th-
    percentile ns normalisation) into det_snap_gray before detectMarkers
    runs, then convert gray→RGB565 at stream time. This guarantees a
    properly-exposed image regardless of ISP AE convergence state.
    [aruco_pose.cpp]
2026-05-02 feat: ArUco detection + POSE working — remove per-frame STREAMOFF
    Detection confirmed working: M<id>:<dist>m POSE:N:x:y:z:qx:qy:qz:qw
    output streaming at ~3–4 fps. ISP AE/AWB/lens-shading now converges
    correctly because the camera is never stopped mid-loop.
    Root cause of previous dark/vignette image: per-frame STREAMOFF
    prevented the OV5647 AEC and ISP lens-shading correction from
    converging (camera active only ~57 ms per 357 ms frame).
    Fixes:
    - Remove VIDIOC_STREAMOFF/STREAMON from detection loop; camera streams
    continuously exactly as camera_view_mode does
    - SPIRAM_MALLOC_ALWAYSINTERNAL=131072: detectMarkers' internal 76800-byte
    adaptive-threshold workspace now lands in SRAM ins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
    [aruco_pose.cpp]
2026-05-02 docs: add ESP32P4 vision board README with working detection screenshot
    Screenshot shows ArUco marker detected in live camera feed with world-pose
    overlay (POSE n=1 x=15.90 y=6.80 z=3.72 m) and white marker outline at ~3.8 fps.
    Also adds drone-vision/ESP32P4 to top-level repo structure and Getting Started.
2026-05-02 docs: update all README files to match current project structure
    - README.md: fix repo tree (launchers/ is top-level, not inside gcs),
    add ESP32S3 to drone-vision tree, fix Getting Started links,
    add launchers/ section description
    - drone-vision/ESP32P4/README.md: fix camera spec (800x800 not 800x640),
    replace stale 3-panel stream viewer description, add resolution select
    (#define VISION_RES_QVGA/HVGA), add tools table with view_frame.py,
    update build instructions to reference launcher scripts
    - drone-vision/ESP32S3/README.md: new file — POSE/BENCH modes, hardware,
    build instructions, relationship to ESP32-P4
    - launchers/ubuntu-gnome-pc/README.md: replace stale script table
    (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
2026-05-07 refactor: restructure drone-firmware into versioned layout
    v1.0/ — legacy single-MCU ESP32S3 (worked at competition, archived)
    v2.0/drone-vision-esp32p4/ — Navigation module (ArUco, ToF, camera)
    v2.0/drone-comms-esp32s3/ — Communication module (MavLink, WiFi, uROS)
    v2.0/shared/ — UART protocol definitions placeholder
    Also:
    - Move PX4_settings.params to hardware/drone/electrical/
    - Remove stale root-level drone-vision/ project (superseded by v2.0 split)
    - Add per-project .gitignore files under each IDF project
    - Update root .gitignore to cover drone-firmware/**/build paths
    [PX4_settings.params, ant.ply, ape.ply, backyard.blend, bunny.ply, cow.ply, desktop.blend, funclist.csv]
2026-05-07 docs: add drone-firmware README with v1.0/v2.0 changelog
    Documents the architecture shift from single-MCU ESP32-S3 (SDC 2026
    qualifiers) to dual-MCU ESP32-P4 + ESP32-S3 on custom PCB (SDC 2026 finals).
2026-05-07 docs: add camera comparison section to drone-firmware README
    Covers OV2640/OV3660 (v1.0) vs OV5647 (v2.0) — sensor specs, detection
    resolution, range achieved, and OV5647 adjustable M12 focus lens advantage
    for different arena lighting environments.
2026-05-07 docs: explain why detection is 3 fps despite 50 fps sensor
    PSRAM read (1.28 MB/frame x2) + OpenCV detectMarkers pipeline costs
    ~300 ms/frame on the 360 MHz RISC-V core — sensor is not the bottleneck.
2026-05-07 fix: update all launcher paths after drone-firmware restructure
    Launchers and desktop files updated for new layout:
    drone-vision/ESP32P4 → drone-firmware/v2.0/drone-vision-esp32p4
    drone-vision/ESP32S3 → drone-firmware/v2.0/drone-comms-esp32s3
    drone-firmware/ → drone-firmware/v1.0 (legacy single-MCU)
    Also fix drone-comms-esp32s3 docker-compose volume mounts:
    - Remove ../../components/ refs (drone-vision/ no longer exists)
    - Remove ../../managed_components ref (let IDF fetch on first build)
    - Update absolute opencv path to drone-firmware/v1.0/components/
2026-05-07 feat: integrate VL53L1X ToF sensor into ESP32-P4 navigation module
    Single sensor active for mock-up (XSHUT GPIO19, I2C SDA/SCL GPIO7/8).
    Array structured for 6 sensors — 5 slots commented, ready for PCB arrival.
    Changes:
    - Copy VL53L1-ULD-ESP component from v1.0 into P4 components/
    - tof_task.c: I2C_NUM_1 @ 400 kHz, DISTANCE_MODE_LONG, 20 Hz polling
    - tof_task.h: tof_get_distance_mm(idx), tof_get_range_status(idx)
    - main.c: tof_task_start() before aruco task
    - aruco_pose.cpp: print TOF:<mm>mm every frame on serial
    - docker-compose.yml: mount ../components into container
    - stream_view.py: parse TOF: lines, yellow overlay on luminance panel
    Serial format: TOF:1234mm (single sensor) / TOF:1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
2026-05-07 feat: add Stream View desktop launcher for ESP32-P4 stream_view.py
    Shows live camera stream with ArUco pose and ToF distance overlay.
    Port defaults to /dev/ttyACM0 @ 921600; override via script args.
2026-05-07 fix: wrap VL53L1-ULD-ESP component in its own subdirectory
    IDF discovers components by directory name under components/.
    Files were at components/* (flat) — moved to components/VL53L1-ULD-ESP/*
    so the cmake resolver can find 'VL53L1-ULD-ESP' by name.
    [VL53L1X_api.c, VL53L1X_api.h, VL53L1X_calibration.c, VL53L1X_error_codes.h, gpio_platform_esp.c, gpio_platform_esp.h, i2c_platform_esp.c, i2c_platform_esp.h]
2026-05-07 fix: switch VL53L1X I2C to driver_ng to resolve conflict with esp_video SCCB
    ESP-IDF 5.4 aborts with "CONFLICT! driver_ng is not allowed to be used with
    this old driver" when i2c_driver_install() is called on a port that esp_video's
    SCCB already owns via i2c_new_master_bus().
    - Rewrite i2c_platform_esp.{h,c}: use i2c_master_{transmit,transmit_receive}()
    with per-address device handles cached in a small table. Init tries
    i2c_new_master_bus() first; on ESP_ERR_INVALID_STATE it borrows the existing
    handle via i2c_master_get_bus_handle() with 50 x 100 ms retries.
    - Rewrite vl53l1_platform.c WriteMulti/ReadMulti to call the new helpers
    directly (removes the old stateful start/w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
    [i2c_platform_esp.c, i2c_platform_esp.h, tof_task.c, vl53l1_platform.c]
2026-05-07 fix: suppress TOF:0mm before sensor warms up
    Check dist > 0 alongside range_status == 0 so stream_view.py shows
    "---" rather than "S0: 0 mm (0.00 m)" during the first measurement
    cycle while the VL53L1X is still stabilising.
    [aruco_pose.cpp]
2026-05-07 fix: set UART baud to 921600 to match stream_view.py
    IDF default is 115200; stream_view.py connects at 921600.
    The baud mismatch caused framing errors → UART HUP → pyserial
    SerialException on the very first read.
2026-05-07 fix: set stream_view.py default baud to 115200 (IDF console default)
    [stream_view.py]
2026-05-08 feat: VL53L1X i2c driver_ng SCCB-borrow shim + stream/aruco updates
    - i2c_platform_esp: new driver_ng shim that borrows the camera SCCB
    bus handle (i2c_master_get_bus_handle) when port is already owned,
    with 5 s retry so SCCB init finishes first; device handle cache keyed
    by 7-bit address; bus reset attempted after borrow (warns on failure)
    - vl53l1_platform: VL53L1X_InitSensorArray XSHUT sequencing, BootState
    polling with timeout, address assignment, single-shot ranging init
    - aruco_pose: stabilisation delay, AEC brightness tweak
    - stream_view.py, launch-stream-view.sh: baud/port usability fixes
    - docker-compose.yml: bind-mount inode-trap warning + board USB note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
    [aruco_pose.cpp, i2c_platform_esp.c, i2c_platform_esp.h, stream_view.py, vl53l1_platform.c]
2026-05-08 fix: pulse XSHUT before i2c scan; lower flash baud to 230400
    tof_task: pulse all XSHUT pins LOW→HIGH before i2c_scan() so that a
    sensor holding SDA from the previous boot's incomplete transaction is
    hard-reset and releases the bus before we probe. Without this the IDF
    bus-reset (called in i2c_init_config after borrowing the SCCB handle)
    fails with ESP_ERR_INVALID_STATE and every probe times out. Add
    bracketed START/OK/FAILED logs around InitSensorArray so results are
    visible even when binary frame data floods the console.
    sdkconfig.defaults: set CONFIG_ESPTOOLPY_BAUD_230400B=y to cap the
    esptool flash speed at 230400. The CH343 USB-UART bridge drops frames
    under burst load at the defau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
    [tof_task.c]
2026-05-08 fix: move VL53L1X to dedicated I2C_NUM_0 on GPIO5/6
    Root cause of all-timeout I2C probe: the camera SCCB and VL53L1X shared
    I2C_NUM_1 (GPIO7/8), which has no pull-ups when the sensor board is
    removed. The SCCB failure from a disconnected camera also left the I2C
    hardware in a stuck state, poisoning subsequent TOF probes.
    Fix:
    - Move VL53L1X to I2C_NUM_0 (GPIO5 SDA, GPIO6 SCL) — a dedicated bus
    with no shared ownership, no borrowing, and pull-ups provided solely
    by the VL53L1X breakout board's onboard 4.7 kΩ resistors
    - Remove the 3 s SCCB-wait delay (no longer needed)
    - Add TOF_I2C_SDA / TOF_I2C_SCL / TOF_XSHUT_PIN to boards.h alongside
    the camera pin map so the full GPIO allocati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
    [boards.h, tof_task.c]
2026-05-08 fix: change VL53L1X I2C to GPIO2/GPIO3 (GPIO6 not on header)
    GPIO6 is not exposed on the Waveshare ESP32-P4-WiFi6 board header.
    Use GPIO2 (SDA) + GPIO3 (SCL) instead — both are on the left header
    adjacent to each other and two rows below GPIO4 (XSHUT), making the
    breadboard cluster: GPIO4 · GND · GPIO3 · GPIO2 (4 consecutive rows).
    [boards.h, tof_task.c]
2026-05-08 fix: move VL53L1X back to shared I2C_NUM_1 (GPIO7/GPIO8) with camera SCCB
    TOF verified working on breadboard; switch SDA/SCL back to camera bus lines
    so a single set of wires serves both SCCB and TOF. i2c_platform_esp borrow
    shim handles the shared bus handle; camera pull-ups replace breakout pull-ups.
    [boards.h, tof_task.c]
2026-05-08 fix: invert i2c_init_config borrow order to prevent startup race with esp_video
    tof_task (CPU1) was reaching i2c_new_master_bus(I2C_NUM_1) before
    aruco_pose's esp_video_init() (CPU0), causing esp_video_init() to abort
    (ESP_ERROR_CHECK on a port-already-acquired error).
    Flip the strategy: try i2c_master_get_bus_handle() first with 50×100 ms
    retries (5 s total), letting esp_video always win bus ownership. Fall back
    to i2c_new_master_bus() only after timeout — for a future dedicated port
    where nobody else creates the bus.
    [i2c_platform_esp.c]
2026-05-08 fix: pulse XSHUT LOW before i2c_init_config to free SDA for camera SCCB
    VL53L1X can hold SDA low from a previous boot's incomplete transaction.
    On the shared I2C_NUM_1 bus this blocks camera SCCB — esp_video_init
    gets an I2C timeout, fails sensor detection, never creates the bus handle,
    and the borrow loop spins 5 s before giving up and creating it itself,
    after which camera ISP and TOF collide.
    Fix: drive XSHUT LOW (pure GPIO) before i2c_init_config(), freeing SDA
    so the camera can init cleanly. i2c_init_config() then borrows the handle
    created by esp_video_init(). XSHUT goes HIGH after the borrow succeeds,
    and VL53L1X_InitSensorArray handles its own per-sensor sequencing.
    Co-Authored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
    [tof_task.c]
2026-05-08 revert: move VL53L1X back to dedicated I2C_NUM_0 (GPIO2/GPIO3)
    Sharing I2C_NUM_1 with the camera SCCB is unworkable: the ISP AEC loop
    polls OV5647 continuously at ~20 Hz; combined with TOF at 20 Hz the bus
    is overloaded and both get I2C timeouts. The i2c scan also hit OV5647
    (0x36) mid-ISP-pipeline-init causing ESP_ERR_NOT_SUPPORTED abort.
    Keep the XSHUT-early improvement: GPIO4 is driven LOW before i2c_init_config
    so the VL53L1X cannot hold SDA low across boots, protecting any future
    shared-bus use and making dedicated-bus init cleaner.
    Revert i2c_platform_esp.c to create-first strategy: with a dedicated port
    (I2C_NUM_0) nobody else creates it, so the 5 s borrow wait is dead time.
    Co-Au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
    [boards.h, i2c_platform_esp.c, tof_task.c]
2026-05-08 fix: move VL53L1X XSHUT from GPIO4 to GPIO51
    [boards.h, tof_task.c]
2026-05-08 fix: update stale GPIO4 comment to GPIO51 in sensor array
    [tof_task.c]
2026-05-08 feat: expand to 5 VL53L1X sensors; XSHUT GPIO4/31/30/29/28
    Slot 0: GPIO4 → addr 0x54
    Slot 1: GPIO31 → addr 0x56
    Slot 2: GPIO30 → addr 0x58
    Slot 3: GPIO29 → addr 0x5A
    Slot 4: GPIO28 → addr 0x5C
    boards.h: rename TOF_XSHUT_PIN to TOF_XSHUT_PIN_0..4; mark GPIO51 reserved.
    tof_task.c: activate all 5 slots; shrink dist/status arrays from [6] to [5].
2026-05-08 feat: improve TOF display for 5 sensors with distance bars
    stream_view.py: replace flat label list with bar-chart display per sensor.
    Each sensor shows: index, distance in mm and metres, and a 16-char Unicode
    block bar scaled to 4 m (VL53L1X LONG mode ceiling). Invalid readings show
    dashed bar. Header shows sensor count. Font size reduced to 7.5 to fit
    all 5 sensors + header cleanly on the luminance panel overlay.
    Example overlay:
    ToF [5 sensors]
    S0: 230mm (0.23m) █░░░░░░░░░░░░░░░
    S1: 1450mm (1.45m) █████░░░░░░░░░░░
    S2: --- ░░░░░░░░░░░░░░░░
    S3: 870mm (0.87m) ██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
    [stream_view.py]
2026-05-08 feat: add 6th upward-facing VL53L1X sensor (slot 5, GPIO5, addr 0x5E)
2026-05-08 fix: move XSHUT slot5 to GPIO26; skip absent ToF sensors gracefully
    GPIO5 is tied to OV5647 reset on the Waveshare board — driving it
    open-drain LOW before camera init produced PID=0x5959 garbage.
    InitSensorArray now marks addr=0 and continues on BootState timeout
    instead of returning TIME_OUT; polling loop skips addr=0 slots so
    missing sensors produce "---" output rather than killing the task.
    [boards.h, tof_task.c, vl53l1_platform.c]
2026-05-08 fix: keep ToF output alive when camera fails to open
    Instead of returning (silently killing the task), loop printing TOF
    readings at 20 Hz so sensor data remains visible in the stream viewer
    even when /dev/video0 is unavailable.
    [aruco_pose.cpp]
2026-05-08 fix: move XSHUT slots 1-4 from GPIO28-31 to GPIO20-23
    GPIO28-31 are MSPI flash/PSRAM data lines on ESP32-P4 — driving them
    open-drain corrupts SPI transactions and kills camera (PSRAM buffers).
    GPIO20-23 are safe general-purpose pins on the Waveshare header.
    Also document the dangerous GPIO ranges in boards.h.
    [boards.h, tof_task.c]
2026-05-08 fix: reset I2C bus after each sensor skip in InitSensorArray
    10 consecutive failed BootState reads leave the bus in a degraded state.
    i2c_bus_reset() calls i2c_master_bus_reset() and evicts the stale 0x29
    device handle so each subsequent sensor slot starts clean — allowing
    sensors on slots 1-5 (GPIO20-23/26) to be detected.
    [i2c_platform_esp.c, vl53l1_platform.c]
2026-05-08 fix: resolve VL53L1X multi-slot BootState failure on ESP-IDF 5.4.4
    Three root causes fixed for 6-sensor array init:
    1. Run i2c_scan() with all XSHUTs LOW so i2c_master_probe never touches
    address 0x29; previously the probe left the address in ESP-IDF's
    internal device table, causing every subsequent i2c_master_bus_add_device(0x29)
    in InitSensorArray to fail silently (get_or_add returned NULL).
    2. Call i2c_bus_reset() BEFORE digitalWrite(XSHUT, HIGH) — the 9 SCL
    recovery pulses must not arrive during the VL53L1X's 1.2 ms boot
    window or they corrupt its I2C state machine.
    3. Discard partial reads: i2c_master_transmit_receive can write a byte
    to the output buffer before r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
    [i2c_platform_esp.h, tof_task.c, vl53l1_platform.c]
2026-05-09 fix: ToF S5 XSHUT moved to GPIO27, warm-boot fallback, explicit sensor array
    - boards.h: change TOF_XSHUT_PIN_5 GPIO26 → GPIO27 (GPIO26 confirmed
    non-functional; GPIO27 verified equivalent HP-only IO)
    - tof_task.c: fix stale GPIO comment on slot 5; declare sensor array as
    explicit s_sensors[6] with #define SENSOR_COUNT 6 instead of sizeof
    derivation; drop blank line left by sizeof removal
    - vl53l1_platform.c: add warm-boot fallback in InitSensorArray — when
    BootState at 0x29 times out, probe sensor's target address via
    VL53L1X_SystemStatus; if found there (VCC stayed up across warm ESP32
    reset with XSHUT disconnected) run SensorInit at target address and
    skip SetI2CAddress;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
    [boards.h, tof_task.c, vl53l1_platform.c]
2026-05-09 fix: relocate ToF XSHUT slots 3/4 to GPIO26/32; reserve GPIO22/23 for UART1
    GPIO22 and GPIO23 freed for UART1 link to ESP32-S3 (TX→S3 D2, RX←S3 D1).
    Slots 3 and 4 XSHUT moved away from GPIO24/25 (USB D-/D+, unsuitable) to
    GPIO26 and GPIO32 — both confirmed free HP GPIOs on Waveshare ESP32-P4-WiFi6.
    boards.h:
    - TOF_XSHUT_PIN_3: GPIO24 → GPIO26
    - TOF_XSHUT_PIN_4: GPIO25 → GPIO32
    - Add S3_UART_PORT/TX/RX/BAUD defines (GPIO22/23, UART_NUM_1, 115200)
    - Add GPIO24/25 (USB D-/D+) to danger list
    - Update GPIO allocation table
    tof_task.c: update header and inline comments to match new pin assignments
    All 6 ToF sensors confirmed operational after relocation.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
    [boards.h, tof_task.c]
2026-05-09 feat: add P4→S3 binary UART link and rewrite drone-comms-esp32s3
    ESP32-P4 (drone-vision-esp32p4):
    - Add p4_link_tx.c/h: UART1 transmitter (GPIO22 TX, GPIO23 RX, 115200 baud)
    - Pack COMBINED frame (6× ToF dist/status + pose) every 50 ms at end of tof_task poll loop
    - Add shared/p4_link_protocol.h: frame layout, CRC-8 poly 0x07, struct definitions
    ESP32-S3 (drone-comms-esp32s3):
    - Replace vision-stub with full comms firmware derived from v1.0
    - Remove: VL53L1X driver, esp32-camera, OpenCV, aruco_task, vision_pose ROS sub
    - Add p4_link.c/h: UART2 receiver (GPIO3 RX, GPIO2 TX) with byte-by-byte state machine
    - Send OBSTACLE_DISTANCE to PX4: 5 horizontal sensors × 6 bins each (30° FOV, 5°/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
    [aruco_pose.cpp, aruco_pose.h, boards.h, main.c, p4_link.c, p4_link.h]
2026-05-09 fix: replace micro_ros symlink with docker bind-mount
    The git symlink pointed to ../../../v1.0/components/micro_ros_espidf_component
    which resolved correctly on the host but broke inside the Docker container
    (only the project subdirectory is mounted as /code).
    Replace with the same bind-mount pattern already used for espressif__opencv:
    v1.0/components/micro_ros_espidf_component → /code/components/micro_ros_espidf_component:ro
    Also rename service esp32s3_vision → esp32s3_comms to reflect the new role,
    and drop the now-unnecessary opencv mount (no OpenCV in this firmware).
2026-05-09 fix: update launch script service name esp32s3_vision → esp32s3_comms
    Matches the renamed service in drone-comms-esp32s3/docker/docker-compose.yml.
2026-05-09 feat: wire P4→S3 binary UART link; S3 forwards ToF+pose to PX4 via MAVLink
    - S3 comms firmware rewritten: removes local ToF/camera, receives
    p4_combined_t frames from P4 over UART2 (GPIO3/2, 115200 baud)
    - OBSTACLE_DISTANCE sent with 5 horizontal sensors mapped to 30° FOV bins;
    upward sensor (slot 5) sent as separate DISTANCE_SENSOR (PITCH_90)
    - VISION_POSITION_ESTIMATE relayed from P4 ArUco pose when vision enabled
    - Shared protocol header (p4_link_protocol.h) bind-mounted into both
    containers; fixes include paths in p4_link.c and p4_link_tx.c
    - Project renamed drone_comms (was drone_vision leftover from v1.0 clone)
    - Added esp_netif + lwip includes; removed unused struct timespec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
    [main.c, p4_link.c, p4_link_tx.c]
2026-05-10 fix(s3-comms): throttle heartbeat to 1 Hz; fix OBSTACLE_DISTANCE comments
    Heartbeat was firing at 20 Hz (every main-loop tick) — standard for a
    companion computer is 1 Hz. Introduce hb_tick counter so it fires once
    per 20 iterations while obstacle data continues at 20 Hz.
    Also correct misleading parameter comments in send_obstacle_distance:
    the `5` arg is the legacy `increment` uint8_t, not `increment_f`; the
    `5.0f` arg is `increment_f`; and `0.0f` is `angle_offset` (bin 0 = fwd).
    [main.c]
2026-05-10 refactor: move PX4_settings.params to drone-firmware/
    FC parameter file belongs with drone firmware, not electrical hardware.
    [PX4_settings.params]
2026-05-10 docs(firmware): document custom PX4 FC parameters in README
    Add PX4 Flight Controller Settings section covering all non-default
    parameters: battery (4S), indoor/GPS-denied EKF2 vision fusion,
    circuit breakers for custom hardware, MAVLink serial port assignment
    (S3 on TELEM2 at 57600), collision prevention pre-config, motor
    mapping, and rate/position controller tuning values.
    Also update repository layout tree to include PX4_settings.params.
2026-05-10 fix(s3-comms): add 512 B TX buffer to PX4 UART to restore 20 Hz loop rate
    Without a software TX buffer, uart_write_bytes blocked ~8 ms per loop
    while the 175-byte OBSTACLE_DISTANCE frame clocked through the 128-byte
    hardware FIFO at 57600 baud, dropping the main loop from 20 Hz to ~14 Hz.
    A 512 B software buffer makes all three MAVLink writes non-blocking.
    [main.c]
2026-05-10 feat(p4-vision): wire ArUco pose into P4→S3 UART combined frame
    aruco_pose_get_latest() exposes the latest world-pose estimate via a
    spinlock-protected shared variable; tof_task queries it each 20 Hz cycle
    and sets pose_valid=true in the COMBINED frame when a known marker is seen.
2026-05-10 feat(stream-view): show marker IDs, world pose, yaw and no-fix indicator
    When a known marker is seen: display detected marker IDs+distances, world
    x/y/z, and yaw extracted from the quaternion (cyan). When stale (>1 s)
    or no known marker: show grey "no ArUco fix". Unknown markers (not in
    map) shown in grey with "(not in map — no pose)".
    [stream_view.py]
2026-05-10 feat(s3-comms): show world pose x/y/z on console when VIS:OK
    tof_console_print() now prints x=N.NN y=N.NN z=N.NN alongside VIS:OK
    so the S3 serial monitor confirms it is receiving and forwarding the
    ArUco pose from the P4 UART frame.
2026-05-10 feat: enable ArUco vision by default on S3 boot and GCS panel
    S3 firmware: vision_enabled defaults to true so VISION_POSITION_ESTIMATE
    is sent to PX4 immediately on first marker fix without needing GCS input.
    GCS panel: ARUCO EKF button starts checked (green) to reflect the active
    default, and vision_btn stored in ui_refs for future state tracking.
    [main.c]
2026-05-10 fix(s3-comms): send zero attitude and proper covariance in VISION_POSITION_ESTIMATE
    Camera-frame quaternion converted to Euler produced roll≈167° / pitch≈67°
    which would corrupt EKF2 heading if vision-yaw fusion was enabled.
    Send roll=pitch=yaw=0 (EKF2 ignores roll/pitch from vision; yaw fusion
    should be disabled until camera-to-body transform is characterised).
    Add explicit upper-triangle covariance: position diagonal = 0.01 (0.1 m
    noise), attitude diagonal = NaN to signal EKF2 to skip attitude fusion
    entirely rather than falling back to default noise params.
    Verified in QGC MAVLink Inspector: VISION_POSITION_ESTIMATE arriving at
    17-19 Hz with correct covariance and zero attitude f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
    [main.c]
2026-05-11 fix(i2c): add post-create bus reset and max glitch filter
    i2c_new_master_bus() leaves bus_busy=1 due to an IO_MUX pin-switch
    transient on SDA. Without clearing this immediately, the first
    i2c_master_probe() in i2c_scan() fires trans_start into a stuck bus;
    after 2 probe timeouts the 3rd probe's NACK hits the unbounded
    s_i2c_send_commands:544 spin-loop → task WDT at +5 s.
    - Call i2c_master_bus_reset() after successful bus creation to clear
    the latched bus_busy flag via the hardware 9-pulse SCL generator.
    - Raise glitch_ignore_cnt 7→15 (hardware max) to better filter the
    longer-wire transient on the drone frame vs bench wiring.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
    [i2c_platform_esp.c]
2026-05-17 fix(comms): per-drone agent ports, reduce micro-ROS traffic, fix OFFLINE flicker
    - Per-drone micro-ROS agent port: 8880 + DRONE_ID (D1→8881 … D5→8885)
    eliminates shared UDP contention that blocked ARM/MISSION on some drones
    - RViz marker publish rate: 10 Hz → 2 Hz (every 5th 100 ms tick)
    cuts micro-ROS UDP traffic 5× across all 5 drones
    - State heartbeat: every 2 s → 1 s (tick threshold 20→10)
    gives 2 s margin before OFFLINE timeout (was 1 s), fixing color-bar flicker
    - Add ground-station-software/gcs/start_agents.sh
    launches one dedicated micro_ros_agent per drone in separate terminal tabs
    [main.c]
2026-05-17 fix(c2-watchdog): raise ping timeout 100→500 ms, fail threshold 2→3
    100 ms round-trip budget caused drone 3 to restart on any brief WiFi
    stutter, looping every ~9 s and never stabilising in rqt.
    500 ms timeout + 3 consecutive failures required = ~3 s of continuous
    link loss before restart, tolerating normal indoor RF variance.
    [main.c]
2026-05-17 fix(gcs): MISSION ALL now sends to drones where ARM was sent, not just state-confirmed
    drone_states[i] only reflects "armed" after the full WiFi+micro-ROS
    round-trip (2-5 s). Pressing MISSION ALL immediately after ARM ALL
    skipped all drones still showing old state. Now also accepts any drone
    whose _arm_sent_times entry exists (ARM was sent but confirmation not
    yet received). Firmware guards against MISSION when actually disarmed,
    so sending before state confirmation is safe.
2026-05-17 fix(arm): home falls back to PX4 inertial pos when vision not valid; reduce ping blocking
    Home capture: when ArUco is not detected at ARM time, home_x/y/z was
    left at 0,0,0. Prearm stream then commanded PX4 to (0,0) which can be
    far from actual position, causing PX4 to reject OFFBOARD mode and ARM.
    Now falls back to px4_pos_x/y/z (LOCAL_POSITION_NED from EKF2) so
    setpoints always match the drone's real position.
    C2 ping: reduced timeout 500→200 ms and interval 1000→2000 ms.
    Max executor block per check: 400 ms every 2 s (was 1000 ms every 1 s).
    This was delaying state publication by up to 1 s, causing the "huge
    delay for receiving armed signal" in the rqt panel.
    Fail threshold kept at 3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
    [main.c]
2026-05-17 fix(gcs): reliable MISSION ALL dispatch with state-confirmed retry
    Root cause 1: MISSION ALL button was checkable — after a successful run it
    stayed checked. Next press un-checked it (silent no-op), second press
    re-checked and actually sent MISSION. Removed setCheckable so every click
    is a fresh action; replaced isChecked() gating with _mission_all_active flag.
    Root cause 2: timing-guard (ARM_MISSION_GUARD_MS) allowed sending
    MISSION_START before drones had confirmed 'armed' state in the GCS.
    Replaced with a state-confirmed retry loop (_mission_all_attempt):
    - waits up to 8 s, polling every 400 ms
    - dispatches each drone exactly once when drone_states[i] == 'armed'
    - logs sending/wa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
2026-05-17 feat(gcs): remove kill, emergency buttons send E-LAND only
    - Remove KILL ALL from global EMERGENCY button (was hold-3s-to-kill)
    - Remove per-drone kill-on-hold from individual EMERG buttons
    - Both buttons now send COMMAND_ELAND immediately on click
    - Global EMERG: first click fires E-LAND + turns orange-red (active);
    second click resets to idle (safe re-arm of the button)
    - Hardware emergency callback simplified: any HW emerg shows E-LAND state
    - Remove all countdown timers, drone_emergency_timers/counters/holds,
    _kill_all(), _start/_release/_tick for both global and per-drone kill
    - Remove EMERGENCY_HOLD_SECONDS constant
2026-05-19 fix(vision): gate ArUco detection on scene brightness to prevent cold-start false positives
    On cold start with camera covered, OV5647 AEC converges at maximum gain
    on a black scene, making sensor noise peak. The 98th-percentile normaliser
    then amplifies that noise (scale up to 8160×) into high-contrast patterns
    that detectMarkers() matches as valid ArUco markers, producing bogus VIS:OK
    coordinates on the S3 console.
    Fix 1 — aruco_pose.cpp: skip detectMarkers() and clear s_pose_valid when
    the raw 98th-percentile luma (norm_max) is below 20. Real indoor scenes
    read 50+; a covered/dark camera reads 2–10.
    Fix 2 — main.c (S3): clear vision_pose_valid immediately when pose.valid=false
    is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
    [aruco_pose.cpp, boards.h, main.c]
2026-05-19 fix(vision): hoist norm_max to loop scope so brightness gate compiles
    norm_max was declared inside an inner {} block; the brightness gate check
    at the detectMarkers() call site was outside that scope, causing a
    'not declared in this scope' build error.
    [aruco_pose.cpp]
2026-05-19 revert(vision): remove brightness gate and S3 immediate-clear fix
    Reverts changes from 716e815 and cf55c9b:
    - aruco_pose.cpp: norm_max hoisted back inside inner block, brightness gate removed
    - main.c (S3): else { vision_pose_valid = false } branch removed
    [aruco_pose.cpp, main.c]
2026-05-20 feat(firmware+gcs): box marker detection pipeline and arena pole map update
    P4→S3 protocol extended with p4_boxes_t (6 entries, 79B):
    - p4_link_protocol.h: add p4_box_entry_t/p4_boxes_t, p4_combined_t grows
    48→127B (frame 52→131B, 11.4ms at 115200 — within 50ms budget)
    - aruco_pose.cpp: save best_R_wc + drone world pos from closest arena marker;
    compute box world positions for IDs 31–46 via p_box = p_drone + R_wc*tvec
    - Full pipeline: aruco_pose → tof_task → p4_link_tx → UART → p4_link(S3)
    - S3 main.c: 12 static TRANSIENT_LOCAL publishers /box_31–/box_36 and
    /box_41–/box_46 (visualization_msgs/Marker, blue/red by team, 3s age-out)
    GCS arena pole map updated to SD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
2026-05-20 fix(comms): bump S3 UART RX buffer 256→512 for 131B frames
    Old 52B frame left ~4.9 frames of buffer; new 131B frame (with boxes)
    left only ~1.9 frames, risking overflow under FreeRTOS scheduling jitter.
    [p4_link.c]
2026-05-20 feat(vision): cache world-camera transform for box detection without map markers
    best_R_wc / best_pw_* are now static — the last valid arena-marker world
    pose is reused for box position computation even when no map marker is
    currently in frame. Enables /box_* topics to appear in RViz during
    testing whenever the drone has seen the arena at least once.
2026-05-20 fix(comms): replace TRANSIENT_LOCAL box publishers with init_default
    micro-XRCE-DDS on ESP32-S3 does not support TRANSIENT_LOCAL durability —
    rclc_publisher_init with that QoS returns RCL_RET_ERROR and aborts the
    micro-ROS task. Switch to rclc_publisher_init_default (RELIABLE+VOLATILE);
    late-joining RViz subscribers receive box state within the next 100ms tick.
    [main.c]
2026-05-20 fix(comms): replace 12 individual box publishers with single MarkerArray
    RMW_UXRCE_MAX_PUBLISHERS is compiled as 5 in the prebuilt libmicroros.a.
    12 individual visualization_msgs/Marker publishers exceeded this limit,
    causing rclc_publisher_init_default to return RCL_RET_ERROR at boot.
    Switch to a single visualization_msgs/MarkerArray publisher on /box_markers.
    Total publishers now: marker + state + role + battery + box_markers = 5.
    Static storage (box_markers_storage[BOX_COUNT]) avoids heap allocation;
    bi index maps 1:1 to storage index so the sequence is always contiguous.
    [main.c]
2026-05-20 fix(vision): commit box positions when only box markers visible (no arena ref in frame)
    When pose_n==0 (box markers detected but no arena map marker in same frame),
    new_boxes was correctly computed using cached best_R_wc but then discarded:
    the else branch wrote s_boxes.count=0 instead of s_boxes=new_boxes.
    Result: box world positions only propagated when an arena marker appeared in
    the same frame. Now commits new_boxes in both branches so box detection works
    independently once best_R_wc is seeded by any prior arena marker sighting.
    [aruco_pose.cpp]
2026-05-20 fix(comms/vision): fix box marker transport and add diagnostic logging
    S3: drop MarkerArray publisher — 12-marker array (~1.9 KB) exceeded the
    micro-ROS UDP transport buffer, causing 'sequence size exceeds remaining
    buffer' on the agent side. Box markers now publish individually on the
    existing publisher_marker (/visualization_marker); IDs 31-46 don't conflict
    with drone disc (100) or text (101). Total publishers stays at 4.
    S3: add ESP_LOGI when boxes.count > 0 arrives from P4.
    P4: add printf("BOXES:N id=X") when box world positions are computed.
    [aruco_pose.cpp, main.c]
2026-05-20 fix(comms): persist box markers in RViz — remove DELETE on timeout
    Arena boxes are fixed objects. Once ADD is sent, never send DELETE.
    The marker stays in RViz until a session restart. ADD is still re-published
    while the box is actively visible to refine the world position estimate.
    [main.c]
2026-05-20 fix(vision): use 25cm box_obj for box marker solvePnP; clamp z to ground
    Arena box markers are 25×25 cm, not 50×50 cm like the navigation poles.
    Using the wrong size caused solvePnP to overestimate distance by 2×.
    Add box_obj (half-size 0.125 m) used only for IDs 31-36, 41-46.
    Box markers are always on the ground plane so e.z is clamped to 0.0
    instead of using the noisy computed z from the world transform.
    [aruco_pose.cpp]
2026-05-20 fix(comms): re-publish confirmed boxes every 2 s to prevent RViz decay
    RViz Marker display has a Decay Time setting that removes markers not
    refreshed within that window. Confirmed boxes (s_box_add_sent=true) are
    now re-published every 20 ticks (2 s) so they never age out regardless
    of the RViz Decay Time setting or QoS history on reconnect.
    [main.c]
2026-05-20 fix(comms): box markers 1m³, lifted +0.5m so bottom is flush with ground
    Scale was 0.25m (ArUco detection size) — visual cube should be 1m×1m×1m.
    RViz places markers at their centre, so z offset +0.5 = half-height keeps
    the bottom face on the ground plane (z=0 from P4).
    [main.c]
2026-05-20 test(comms): allow M22 approach trigger from ARMED state for bench testing
    The approach test previously required DRONE_MISSION state, making it
    impossible to verify without an active flight. Allow DRONE_ARMED so the
    trigger fires immediately after arming when M22 is shown to the camera.
2026-05-20 fix(comms): increase prearm stack to 4096 and fix RViz teleport on vision loss
    - xTaskCreate prearm stack 2048 → 4096 to fix stack overflow crash
    - Sync map_home/px4_home anchors on every valid vision frame so the
    inertial fallback (map_home + px4_delta) starts from the last known
    ArUco position instead of (0,0,0), eliminating the RViz disc teleport
    when vision times out
    - Update PX4_settings.params: CP_DIST -1 → 0.5 m (collision prevention
    enabled), updated accel/gyro calibration, removed stale SENS_FLOW_*
    [PX4_settings.params]
2026-05-21 fix(gcs): ARM dead-man's switch, CONFIG_SOURCE_GCS on startup, rqt force-discover
    - btn_test.py: rewrite to match rqt panel behaviour
    - Hold ARM button → CONFIG_SOURCE_GCS + COMMAND_ARM (dead-man's switch)
    - Release ARM button → COMMAND_DISARM immediately, cancels pending mission
    - CONFIG_SOURCE_GCS published to all drones on node startup
    - 400 ms ARM→MISSION guard matching panel's ARM_MISSION_GUARD_MS
    - 50 ms debounce on all GPIO pins to suppress contact bounce
    - Per-drone config publishers added (/gcs/drone_N/config)
    - Mission pending timeout raised 2 s → 8 s (matches panel MAX_WAIT_S)
    - gcs_button_panel.py: move gcs_radio.setChecked(True) after toggled.connect()
    s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
    [btn_test.py]
2026-05-21 fix(comms): set takeoff alt to 1.0m, DRONE_ID=3, update sensor/bin map docs
    [main.c]
2026-05-24 fix(comms): flight-test fixes — vision fade, pose filter, collision avoidance, M22 approach
    Issue 1: box markers scaled to 50×50×50 cm (was 1 m³); z-offset 0.25 m.
    Issue 2: vision fade-out on ArUco loss — continue sending last known pose
    with covariance rising from 0.01→0.50 over 3 s (VISION_FADE_MS) so PX4
    EKF2 transitions smoothly instead of hard-resetting to NED origin.
    Issue 3: pose jump filter — discard any single-frame position update
    > MAX_POSE_JUMP_M (1.0 m); prevents ArUco flip at extreme viewing angles
    from jolting the EKF and crashing the drone.
    Issue 4: M22 approach now yaw-aware — target = current_pos + 1 m in
    drone heading direction (from ArUco quaternion), not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
    [main.c]
2026-05-24 fix(px4): post-flight-test param update — disable baro, enable rangefinder altitude
    - EKF2_BARO_CTRL 1→0: disable barometer fusion (prop-wash causes 6 m error at 1 m altitude on open frame)
    - EKF2_RNG_CTRL 1→2: rangefinder (MT01) always active as primary altitude source
    - CAL_ACC0/1 offsets: fresh accelerometer calibration
    - CAL_GYRO0/1 offsets: fresh gyroscope calibration
    - COM_FLIGHT_UUID, LND_FLIGHT_T_LO: auto-updated by PX4 post-flight
    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
    [PX4_settings.params]
2026-05-24 fix(vision): correct focal length from 357→439px via 1.5m ground truth
    OV5647 theoretical fx=892×0.4=357px under-reported distance by 23%:
    marker at 1.500m detected as 1.220m.
    Correction: fx = 892 × scale × (1.500/1.220) = 438.6px.
    Marker size confirmed 50×50cm — no change to POSE_MARKER_SIZE_CM.
    Expected accuracy after correction: ±3–7cm at 1–2m, ±10–15cm at 4–5m.
    Residual error from uncorrected barrel distortion; full ChArUco
    calibration needed for sub-cm accuracy.
    [aruco_pose.cpp]
2026-05-24 docs(firmware): note OV5647 lens protrusion 9.5 mm for extrinsic calibration
2026-05-25 fix(vision): lower AEC target 47→15 for daylit venues, add exposure tuning docs
    OV5647 was targeting ~91% brightness (value=47, max) — adequate for dark
    indoor arenas but causes overexposure when daylight enters from windows.
    Introduce CONFIG_VISION_AEC_TARGET (default 15, ~29% full scale) so the
    sensor has headroom to close down in bright conditions without source edits.
    README documents the 0–47 range and per-venue override via CMakeLists.
    [aruco_pose.cpp]
2026-05-25 feat(comms): seed PX4 EKF with arena starting position before ArUco acquisition
    Subscribe to /gcs/system/team_color ("red"=LH, "blue"=RH) and send
    VISION_POSITION_ESTIMATE at 1 Hz with covariance 1.0 m until the first
    real ArUco fix arrives. Prevents EKF innovation gate rejection (19 m
    jump) when drones start far from the NED origin.
    Starting positions use inverted drone numbering:
    LH (red) D1→(1,5) D2→(1,4) D3→(1,3) D4→(1,2) D5→(1,1)
    RH (blue) D1→(19,5) D2→(19,6) D3→(19,7) D4→(19,8) D5→(19,9)
    RViz disc is also moved to the correct starting location immediately
    when team colour is selected. inertial_anchor_valid guard added to
    prevent the disc from appearing at a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
    [main.c]
2026-05-25 fix(comms): remove EKF starting-position seed — caused position drift
    The seed loop sent VISION_POSITION_ESTIMATE(start_pos, cov=1.0) before
    ArUco acquisition. PX4 EKF partially fused the large (19 m) offset
    against inertial, placing the estimated position somewhere between NED
    (0,0) and the arena start. The position controller then chased that
    phantom location, causing visible drift on takeoff.
    The team_color subscription is kept: it still moves the RViz disc to
    the correct arena starting position when LH/RH scene is selected.
    [main.c]
2026-05-25 feat(comms): arena→NED coordinate translation + position debug log
    Subtract the drone's known arena starting position (ned_offset) from all
    VISION_POSITION_ESTIMATE messages sent to PX4, so the EKF always sees
    positions relative to the drone's physical start (NED 0,0) regardless
    of team assignment. Prevents EKF innovation gate rejection for both
    red team (~1,5) and blue team (~19,5) starting positions.
    - team_color_callback: stores ned_offset_x/y and logs it
    - Live vision path: sends (vp_x - ned_offset_x, vp_y - ned_offset_y)
    - Fade-out path: same offset applied to last known pose
    - control_callback: GCS arena setpoints translated to NED before use
    - Main loop: 2 s [POS] log sho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
    [main.c]
2026-05-25 feat(launchers): add GCS - Swarm Ollama desktop shortcuts and launch scripts
    Adds launch-swarm-ollama.sh for both ubuntu-gnome-pc and ubuntu-xfce-pi5,
    with matching .desktop shortcuts named "GCS — Swarm Ollama".
2026-05-25 fix(ollama): switch default model to gemma3:1b to fit Pi5 RAM, add colcon rebuild to GCS launcher
2026-05-26 fix(comms): vision yaw fusion, remove SW obstacle hold, slow cruise speed
    - Feed ArUco heading to EKF2 via VISION_POSITION_ESTIMATE (cov[20]=0.05 rad²)
    using camera +Z forward formula — fixes 90° CCW spin on first marker lock
    - Remove software obstacle_detected() hold; rely on PX4 COM_OBS_AVOID instead
    - Freeze RViz disc at last known vision position when ArUco is lost (fixes (0,0) teleport)
    - Hover setpoint holds vision_yaw when no GCS setpoint is active
    - PX4 params: COM_OBS_AVOID=1, EKF2_MAG_TYPE=5 (EV yaw), MPC_XY_CRUISE=0.5 m/s
    [PX4_settings.params]
2026-05-26 feat(vision): dynamic covariance from ArUco reprojection error
    P4 computes mean corner reprojection error (px) after solvePnP for the
    closest visible map marker. Error is transmitted in p4_pose_t.reproj_err
    (protocol frame grows 127→131 bytes; both sides updated).
    S3 uses reproj_err to:
    - Reject frames with error > 10 px (likely flipped/occluded marker)
    - Scale pos_variance: var = 0.01 + (err/10)² × 0.49
    giving EKF2 less trust in blurry or partial detections
    [aruco_pose.cpp, aruco_pose.h, main.c, p4_link.c, p4_link.h, p4_link_tx.c, p4_link_tx.h]
2026-05-26 fix(safety): enable PX4 Failure Detector flight termination
    CBRK_FLIGHTTERM 121212→0 unblocks the circuit breaker so FD_ACT_EN=1
    can take effect. PX4 now cuts motors immediately when roll/pitch exceeds
    60° — prevents motors spinning indefinitely after a flip/crash even when
    the S3 is physically disconnected.
    [PX4_settings.params]
2026-05-26 revert(params): disable COM_OBS_AVOID — using S3 software obstacle clamping
    [PX4_settings.params]
2026-05-27 fix(params): set SENS_MAG_RATE to 0 — no magnetometer installed
    [PX4_settings.params]
2026-05-27 fix(params): remove SENS_MAG_RATE — N/A, no magnetometer installed
    [PX4_settings.params]
2026-05-27 feat(vision): fix optical centre, add arena top-down viewer
    - aruco_pose.cpp: cam_cx=687.0 (empirically confirmed on two cameras,
    stable across X_ADDR configs — ISP crop anchored at X_start=500)
    - stream_view.py: aspect='auto' for consistent panels; red crosshair at
    true optical centre (x=68.7/80); click-to-measure handler
    - arena_view.py: new top-down arena map — drone position + yaw heading,
    ArUco marker overlay, fading trail, live POSE parsing from UART
    - launch-arena-view.sh: desktop launcher matching stream-view style
    [arena_view.py, aruco_pose.cpp, stream_view.py]
2026-05-27 feat(arena): dual-source heading viz + S3 ANSI parser fix
    arena_view.py:
    - Add S3 port selection menu to launcher (P4-only / S3-only / both)
    - Fix S3 serial parser: skip ANSI escape bytes instead of clearing
    buffer — ESP_LOGI color codes were wiping [POS] lines before \n flush
    - Flush on \r as well as \n for printf("\r[ToF]...") lines
    - Parse sent_yaw and ned_yaw from updated [POS] log format
    - Draw heading arrows on yellow diamond (sent_px4) and orange circle
    (px4_ned) using yaw values from S3
    - Hide S3 markers at (0,0) until first ArUco localization
    drone-comms-esp32s3/main/main.c:
    - Add px4_yaw variable, parse MAVLINK_MSG_ID_ATTITUDE to fill it
    - Add vision_yaw and px4_yaw (degrees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
    [arena_view.py, main.c]
2026-05-27 fix(gcs): remove uninstructed drone colour scheme — markers now white
2026-05-27 feat(gcs+s3): replace heading arrow with heading triangle; add vision_pose publisher
    GCS (gcs_button_panel.py):
    - Replace ARROW heading marker with flat TRIANGLE_LIST (apex faces heading,
    same blue colour as disc); fades after 2 s if vision_pose stops
    S3 firmware (main.c):
    - Add /drone_N/vision_pose PoseStamped publisher (2 Hz, only when ArUco valid)
    - Blue disc now has 1.5 s lifetime and is suppressed when vision_pose_valid —
    disc fades out as triangle fades in on ArUco lock, reappears on loss
    - Fix S3 heading arrows: remove erroneous +90° offset (vision_yaw is already
    camera-forward; offset was for P4 quat-right convention only)
    - Fix sent_px4 / px4_ned plot posit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
    [arena_view.py, main.c]
2026-05-27 fix(gcs+s3): eliminate disc/triangle overlap; match triangle altitude to drone
    S3: send DELETE for disc in the same 2Hz tick vision_pose first appears —
    disc vanishes exactly when triangle shows, no overlap window
    GCS: triangle z now uses msg.pose.position.z instead of hardcoded 0.02 m
    [main.c]
2026-05-27 fix(gcs+s3): use TRANSIENT_LOCAL QoS for team_color — fixes first-press scene bug
    GCS publisher and S3 subscriber now use TRANSIENT_LOCAL + RELIABLE so the
    retained sample is delivered to any late-joining drone regardless of DDS
    discovery timing. Eliminates the need for retries or double-press.
    [main.c]
2026-05-28 fix(s3-comms): set DRONE_ID to 1
    [main.c]
2026-05-28 fix(nav): correct arena→NED coordinate mismatch causing startup jump and ArUco drift
    Two coordinate-space bugs caused the drone to relocate ~3 m on manual
    control startup and fly in the wrong direction when ArUco markers were
    first detected:
    1. S3 firmware (main.c): home_x/y were stored as arena coordinates
    (vp_x, vp_y) but used directly in mav_set_position_ned(), which
    expects NED. For LH D2 this sent NED (1, 4) instead of (0, 0),
    commanding the drone 1 m North + 4 m East of its start on every
    arm. Fix: subtract ned_offset_x/y before storing home from vision.
    2. Mission script (mission_forward_back.py): fly-mode initialised
    pos=[0,0] (arena origin) instead of the drone's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
    [main.c]
2026-05-29 fix(manual-flight): set correct initial yaw for blue (RH) team
    Blue team starts facing -X (arena). The fly-mode script was hardcoding
    yaw=0.0 (facing +X), causing the firmware to command a 180° yaw
    rotation on takeoff for RH drones.
    Fix: initialise yaw=180° when _TEAM=='blue', 0° for red. This matches
    the reference headings: red → +X, blue → -X.
2026-05-29 fix(s3-comms): negate vision Z before sending to PX4 (arena up → NED down)
    vp_z and vp_last_z are arena-frame altitude (up positive, e.g. +1.5 m).
    VISION_POSITION_ESTIMATE expects NED Z (down positive), so 1.5 m above
    ground must be sent as -1.5. Both the live pose path and the fade-out
    path were sending the wrong sign.
    Currently dormant with EKF2_HGT_MODE=0 (baro height), but would cause
    full-throttle climb if vision height fusion is ever enabled.
    [main.c]
2026-05-29 feat(gcs): always-on drone trail — draws without ArUco
    Previously the RViz trail only updated when /drone_N/vision_pose was
    published (ArUco valid only). Trail was invisible during inertial flight.
    S3 firmware: add /drone_N/position publisher (PoseStamped, 2 Hz) that
    emits unconditionally. Payload is drone_disc_msg.pose, which already
    holds the best-available position: ArUco XYZ+quaternion when vision is
    valid, last confirmed arena anchor otherwise.
    GCS: trail subscription changed from /drone_N/vision_pose to
    /drone_N/position so the trail and heading triangle update throughout
    the full flight, not only when markers are in view.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
2026-05-29 chore(gcs): save RViz layout state; ignore drone firmware logs
    Update scene_map_objects.rviz with current camera/window geometry.
    Add drone-firmware/log/ to .gitignore to exclude PX4 ULog flight logs.
2026-05-29 fix(s3-comms): revert publisher_position to stay under micro-ROS 5-publisher cap
    The compiled libmicroros.a in v1.0/components/micro_ros_espidf_component is
    built with RMW_UXRCE_MAX_PUBLISHERS=5 (see include/rmw_microxrcedds_c/config.h:56).
    Commit 34f9cec added a 6th publisher (publisher_position for the always-on
    GCS trail), which made rclc_publisher_init_default fail on the 6th call.
    RCCHECK then vTaskDelete'd the micro-ROS task before subscriptions, executor,
    and timer were initialised — so /drone_N/state never started publishing and
    every drone showed OFFLINE in rqt despite 5 data writers appearing on the
    agent.
    Revert the publisher addition on both sides:
    - drone-comms-esp32s3/main/m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
    [main.c]
2026-05-29 feat(vision): gate pose updates by distance and PnP orientation sanity
    Two stateless filters added to the per-marker PnP loop in aruco_pose.cpp,
    both inside the existing `if (m) { … }` block:
    1. Distance gate (POSE_MAX_RANGE_M = 8.0 m).
    At QVGA a 50 cm marker is only ~12 px at 8 m and ~7 px at 11 m. Beyond
    ~8 m, sub-pixel corner noise produces PnP solutions metres off truth —
    stationary test at 11 m reported drone Z = 6.06 m vs. 1 m truth. Markers
    farther than POSE_MAX_RANGE_M now skip pose accumulation, best_R_wc, and
    best_pw_* updates. Value matches the resolution's documented reliable
    range comment in the existing #define block above.
    2. PnP planar-ambiguity guard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
    [aruco_pose.cpp]
2026-05-29 docs(vision): add TODO section for IPPE ambiguity and eland yaw bug
    Two open issues captured for the next iteration:
    1. Yaw oscillation on wall markers. The -0.8 face-normal orientation guard
    improved stability but a deterministic 180° rotation oscillation persists
    when the drone faces wall markers (12, 14 confirmed). The actual IPPE
    planar ambiguity rotates around an axis in the marker plane perpendicular
    to the line-of-sight, not around the face normal — so the current guard
    doesn't catch this failure mode. Proposed fix: switch to
    cv::solvePnPGeneric(... SOLVEPNP_IPPE) and pick the solution closer to the
    previous frame's inertial position. Diagnostic-logging altern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
2026-05-29 fix(s3-comms): hold heading on emergency land (param4 NaN instead of 0)
    MAV_CMD_NAV_LAND param4=0 was commanding the drone to yaw to 0° (North)
    before descending. Setting param4=NaN tells PX4 to hold current heading.
    [main.c]
2026-05-29 fix(vision): resolve IPPE yaw ambiguity via temporal continuity
    Switch from solvePnP(IPPE_SQUARE) to solvePnPGeneric(IPPE) to obtain
    both ambiguous solutions. For near-frontal wall views the two solutions
    have identical positions but yaws 180° apart, making the orientation
    guard blind to the flip. Pick the solution whose world-frame yaw is
    closest to the previous accepted yaw (s_prev_yaw). This eliminates the
    180° oscillation observed when facing the y=0/y=10 wall markers.
    [aruco_pose.cpp]
2026-05-29 fix(gcs): restore always-on trail via inertial disc marker
    The always-on trail (34f9cec) required a 6th micro-ROS publisher which
    exceeded the 5-publisher libmicroros limit. Rather than rebuilding
    libmicroros, tap the drone disc CYLINDER marker that the S3 already
    publishes on /visualization_marker during inertial fallback. When vision
    is active the trail is fed by /drone_N/vision_pose as before; when vision
    is lost the disc marker (last known ArUco position) keeps the trail alive.
    The two sources are mutually exclusive so there is no duplication.
2026-05-30 fix(vision): replace IPPE yaw heuristic with absolute arena/wall-side gate
    The temporal-continuity selector (24eb720) did not resolve the wall-marker
    yaw flip. It had no absolute anchor: on the first frame (s_prev_yaw = NaN)
    it blindly took sol 0 and latched onto it, so correctness depended on
    acquisition order. Flight tests 2026-05-30 (LH scene) confirmed this —
    ArUco 13 stabilised when seen after marker 12, but crashed the drone into
    the wall when it was the first marker of the flight.
    Root cause: for a vertical wall marker the IPPE planar ambiguity is a ~180°
    rotation about the marker's vertical axis, i.e. R_wc_flip = Rot(Z,180)·R_wc,
    which reflects the recovered drone position acros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
    [aruco_pose.cpp]
2026-05-30 docs(vision): root-cause the yaw flip — mag-less EKF + ambiguous ArUco yaw
    Flight tests 2026-05-30 (LH scene, drone_2) plus the PX4 .ulog show the 180°
    yaw flip is not purely an ArUco bug. The airframe has no magnetometer
    (EKF2_MAG_TYPE=5) and no indoor GPS, so ArUco yaw is EKF2's only absolute
    heading source (EKF2_EV_CTRL=15). At poor viewing geometry the two IPPE
    solutions share ~the same position but ~180°-opposite yaw, so a flipped yaw
    passes the position gate and gets fused with nothing to veto it (observed EV
    heading innovations ~2.5-2.9 rad). At marker height square-on it is stable.
    The arena/wall-side gate (8ed12e5) fixes the position-reflection flip but not
    the same-position ya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
2026-05-30 fix(s3-comms): add yaw-continuity gate to reject ~180° ArUco yaw flips
    With no magnetometer (EKF2_MAG_TYPE=5) and no indoor GPS, ArUco yaw is EKF2's
    only absolute heading source, so a flipped ArUco yaw has nothing to veto it and
    snaps the heading 180° (flight log 2026-05-30, EV heading innovations ~2.5-2.9
    rad). The existing 1 m position-jump gate misses this because the two IPPE
    solutions at poor geometry share ~the same position with opposite yaw.
    Mirror the position-jump gate in the vision RX path: compute the candidate
    heading from the incoming quaternion and reject a frame whose vision_yaw differs
    >90° (MAX_YAW_JUMP_RAD) from the last accepted yaw. Active only once vision is
    establi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
    [main.c]
2026-05-30 feat(firmware): scene-aware heading seed (S3) + 5 m range limiter (P4)
    Heading seed (s3-comms/main.c): with no magnetometer, seed EKF2's yaw at arm
    from the known launch heading so the first ArUco fix agrees instead of snapping
    180°. Scene-aware via team_color: LH/red→+X (0°), RH/blue→−X (180°). Sends a
    yaw-only VISION_POSITION_ESTIMATE (position echoes the EKF estimate at loose
    covariance) for SEED_YAW_MS=4000 ms after arm, then stops so it can't fight
    later yaw maneuvers. Gated on vision_enabled && seed_yaw_valid; SEED_YAW_ENABLE.
    NOTE: not yet validated in flight — the seed has not run on any test so far
    (ArUco EKF disabled at arm, or team_color never reached the drone over a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
    [aruco_pose.cpp, main.c]
2026-05-30 fix(s3-comms): default heading seed to LH at boot — no longer requires team_color
    seed_yaw_valid was false by default and only set by team_color_callback. With
    the micro-ROS link down at the 22:21 flight, team_color never arrived and the
    seed never fired — confirmed via pyulog analysis of logs 163/165 (estimator_ev_
    pos_bias absent in arm window, first EV-yaw innovations 161–171°).
    Fix: initialise seed_yaw_valid=true and seed_yaw_rad=START_YAW_LH_DEG at boot.
    team_color still overrides for RH scenes when the link is up. Verified via QGC
    MAVLink Inspector: VISION_POSITION_ESTIMATE appeared within 4s of arm (34 msgs,
    yaw=0, cov[20]=0.05, pos cov=9.0), stopped cleanly after the seed win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
    [main.c]
2026-05-31 fix(s3-comms): disambiguate first-fix ArUco yaw against px4_yaw
    log_171 (LH→marker 12) shows the ~180° flip is NOT a viz artifact: raw
    gyro integrated +89.9° as the pilot turned to face the marker and EKF2
    tracked it correctly (+89°), yet the first ArUco fix reported ~-80° — the
    flipped IPPE solution. With no magnetometer the EKF heading variance grows
    huge over a long loiter (mean stays correct via low-drift gyro), so a
    tight-covariance flipped EV yaw overrides the correct prior → 180° snap.
    Pick the IPPE yaw solution closest to the gyro-propagated EKF heading
    (px4_yaw): if the incoming ArUco heading disagrees by >90°, add 180°.
    Unlike the prior-vision continuity gate (MAX_YAW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
    [main.c]
2026-05-31 docs(flight-tests): 2026-05-31 — yaw fix confirmed + rear-left rotor crash
    log_171/log_173 analysis:
    - px4_yaw disambiguation (513cd8a) confirmed in flight: first-fix heading
    innovation 21° (was ~170°), no EKF heading snap.
    - Free-fall crash root-caused to a PHYSICAL rotor failure (rear-left,
    output index 1 / "Motor 2"), not software/vision/control. Setpoint stayed
    ~2-3° while actual attitude diverged to -80°/+39° → controller was victim.
    - Ruled out: battery, failsafe/disarm, CBRK_FLIGHTTERM, vision EVP estimate.
2026-05-31 fix(s3-comms): survive PX4 EKF position resets after vision dropout
    log_24 (drone 1, LH): after a ~19 s vision gap the drone flew on optical
    flow, then re-acquisition force-reset PX4's position by Δ(+1.58,-3.68) m.
    With no GPS to anchor NED, the reset shifted PX4's frame while the S3 kept
    sending setpoints/EV in the old fixed arena↔NED frame → the controller
    chased a 4 m phantom error straight into the wall.
    Two mitigations:
    1. Reset tracking: detect a physically-impossible single-frame jump in
    LOCAL_POSITION_NED (> PX4_RESET_DETECT_M) and absorb Δ into ned_offset
    so setpoints/EV stay locked to the arena frame across EKF resets.
    2. Re-acquisition ramp: after a dropout (> VISION_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
    [main.c]
2026-05-31 feat(vision): ±30° ArUco incidence gate + archive 2026-05-31 flight logs
    P4: add MAX_VIEW_ANGLE_DEG viewing-incidence gate — reject markers seen
    more than 30° off the face normal, where the IPPE yaw is ambiguous. Fires
    per-marker in the solution loop with a rate-limited diagnostic log.
    NOTE: not yet validated; value under review (vision coverage is sparse —
    tighter gate worsens dropouts; see logs/README OPEN-3).
    logs/: archive the four 2026-05-31 flights (ulog + mcap + keyboard capture)
    with logs/README.md tabulating findings, per-commit changes, and open items:
    - 17:42 drone2 log_171: yaw flip FIXED (px4_yaw disambiguation confirmed)
    - 18:31 drone2 log_173: free-fall crash = rear-le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
    [aruco_pose.cpp]
2026-05-31 docs(logs): correct README — ±30° P4 incidence gate WAS flashed for 20:43
    User confirms the ±30° viewing-incidence gate was built and flashed on P4
    for the drone-3 (20:43) flight. This reframes the root cause: the gate
    rejected the obliquely-viewed wall markers during the +X traverse, so
    vision could not fuse for 79 s — that flow-only stretch is what built the
    drift behind the ~5 m position reset and runaway. The ±30° gate is
    empirically too aggressive for this arena/flight geometry (OPEN-3): relax
    to ≥45° and improve marker coverage before re-testing cca8686.
2026-05-31 fix(nav): drop EV yaw fusion, relax incidence gate, gate EKF-reset absorption
    S3 (drone-comms-esp32s3):
    - Disable ArUco yaw fusion into EKF2 (cov[20] = NaN). Gyro drift over a
    15 m arena traverse is ~0.4 deg/10s (~1.5 deg total), well within the
    1-2 m RFID capture window, so heading correction from vision is not needed
    and only introduces yaw-flip risk. Remove YAW_DISAMBIG_ENABLE/RAD,
    VISION_YAW_COV, and px4_yaw_valid — now dead code.
    - Gate ned_offset EKF-reset absorption on vision recency (< 2 s): absorb
    only genuine mid-flight EKF frame resets, not re-acquisitions after flow
    drift where the jump is a legitimate position correction (OPEN-1 fix).
    P4 (drone-vision-esp32p4):
    -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
    [aruco_pose.cpp, main.c]
2026-05-31 fix(rviz): live disc via NED dead-reckoning; always publish
    Previously the disc was deleted when ArUco became active and never
    republished — invisible during the entire flight. Three-tier fallback:
    1. ArUco valid → direct vision pose
    2. NED anchor set + px4_pos_valid → dead-reckon from last ArUco
    anchor using PX4 NED delta (live during vision gaps, drifts with flow)
    3. Pre-flight → frozen at team_color home position
    Disc is now always published unconditionally at 2 Hz; s_disc_visible
    delete/restore logic removed.
    [main.c]
2026-05-31 docs(firmware): update READMEs with nav architecture and pending work
    S3 README: add Navigation Architecture section covering EV yaw-fusion
    disabled (gyro owns heading), EKF reset gate, incidence gate change,
    three-tier RViz disc, Ollama commanding, DRONE_ID note. Add Pending Work
    table with Manhattan waypoint nav decisions and dead seed-code cleanup.
    P4 README: mark yaw-flip remaining-work as resolved (EV yaw disabled on
    S3 side, commit bd10a7a). Document incidence gate relaxation 30°→45° and
    rationale.
2026-06-01 docs(logs): archive 2026-06-01 flights + diagnose 3 regressions
    Three flights on the post-bd10a7a/4fdc15b build, all vision-related:
    - 18:55 drone3 (LH): bad-East ArUco fix -> reset_pos_to_vision -> East
    runaway to 35 m -> flyaway.
    - 19:42 drone4 (LH): same flip flyaway after 90 deg turn; East 0->27 m.
    - 20:07 drone3 (RH): 180 deg yaw flip on hover — cov[20]=NaN does NOT
    disable EV yaw (PX4 uses EKF2_EVA_NOISE; EKF2_EV_CTRL=15 keeps yaw bit).
    README: 06-01 findings table, firmware-change verdicts (bd10a7a regressed
    all three; 9f65d04/4fdc15b trail), new OPEN-7 (position-innovation gate),
    OPEN-8 (EKF2_EV_CTRL=7 or restore 513cd8a), OPEN-9 (anchor dead-reckon at
    arm), and a to-do review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
2026-06-01 logs(2026-06-01): add 21:09 drone4 .ulg (log_63) — inertial drift test
    Closes the missing PX4 log for the aggressive 5-min inertial-only flight.
    DRONE_ID left unstaged (per-drone local value, not versioned — see OPEN-6).
2026-06-03 feat: finals prep — drone5 ID, simulate_drones, smarter DDS wait, trim old flight data
    - Set DRONE_ID=5 in ESP32-S3 comms firmware
    - Add simulate_drones.py (5-drone ROS2 state publisher for local testing)
    - Replace fixed 0.5s sleep with active DDS-discovery wait (up to 4s) in ollama_commander
    - Launcher: auto-start simulator if present, switch model label to Gemma3 1B, set FASTDDS_BUILTIN_TRANSPORTS
    - Add finals technical report PDF
    - Remove stale 2026-05-30 flight bags, media CAD/blend/texture assets
    [generic_market.stl, marker.blend]
2026-06-03 docs(vision-p4): add sensor role sections and known issues; remove Build & Flash
    Add ArUco Navigation, Box Detection, and ToF Obstacle Detection sections
    with descriptions and known issues (OPEN-7, OPEN-8). Remove Build & Flash
    section.
2026-06-03 docs(vision-p4): remove Current State and UART sections; integrate into ArUco subsections
    Dissolved "Current State (May 2026)" — image, fps, and console output format
    distributed into the Navigation and Box Detection sections. Removed "UART Output
    → ESP32-S3" section.
2026-06-03 docs(vision-p4): rename title to Vision Module – ESP32 P4
2026-06-03 docs(vision-p4): strip verbose tuning prose, rename Tools to Troubleshooting & Debugging
    Remove explanatory paragraphs from Camera Exposure, Detection Resolution, and
    Pose-Acceptance sections — keep only code defines and config tables. Remove
    orientation guard explanation and distance gate detail. Rename Tools section
    and update entries to desktop launchers.
2026-06-03 docs(vision-p4): expand ToF section with sensor directions and known issue
    Add slot direction table (slots 0-5: Left/L-front/Front/R-front/Right/Up),
    S3 hover-on-obstacle behaviour at 0.5m, and Known Issue 1 — PX4 Offboard mode
    ignores OBSTACLE_DISTANCE and DISTANCE_SENSOR.
2026-06-03 docs(vision-p4): rename Arena View launcher label to IDE – Arena View
2026-06-03 docs(vision-p4): link ESP32-P4 WiFi6 to Waveshare docs, remove Hardware section
2026-06-03 docs(comms-s3): rename title, link XIAO ESP32-S3 to Seeed wiki
2026-06-03 docs(comms-s3): shorten title to Comms Module – ESP32 S3
2026-06-03 docs(comms-s3): remove UART Protocol and MAVLink Obstacle Distance Mapping sections
2026-06-03 docs(comms-s3): clarify micro-ROS topic direction — drone vs GCS as publisher
2026-06-03 docs(readme): remove ESP32- prefix from MCU column cells
2026-06-03 docs(readme): restore ESP32- prefix in Repository Structure tree comments
2026-06-03 docs(readme): fix tense — is one => was one
2026-06-03 docs(readme): compact version table — merge CPU/PSRAM into Specs, merge ArUco cols
2026-06-04 Add full To Do list to drone-comms-esp32s3 README
2026-06-04 Set inertial_anchor_valid at ARM time to fix frozen trail
    [main.c]
2026-06-04 Implement Manhattan waypoint navigation in S3 comms firmware
    - 1 m steps, X-leg first then Y-leg
    - Yaws to face direction of travel at each waypoint
    - Stops and awaits new GCS command on obstacle (ToF < 500 mm)
    - New GCS destination mid-flight restarts sequence from current position
    - Arrival tolerance 1 m
    - Setpoints <= 1 m Manhattan distance bypass to pass-through (keyboard control)
    [main.c]
2026-06-04 Move Manhattan parameters section to drone-comms-esp32s3 README
2026-06-04 Remove Pending Work section from drone-comms-esp32s3 README
2026-06-04 fix(nav): hover at arrived position after Manhattan destination
    On reaching the final Manhattan waypoint the sequencer cleared nav_active
    but latched no hold. The next mission cycle then found nav_active,
    nav_obs_hold and setpoint_received all false (the large-step path in
    control_callback never sets setpoint_received) and fell through to the
    "hover at home" branch — so the drone flew all the way back to launch
    after correctly reaching the target.
    Latch the destination into the pass-through hold (setpoint_*,
    setpoint_received=true) on arrival so it parks at the arrived position.
    New waypoints still replan from live px4_pos via nav_build_waypoints, so
    the hover position is taken into accou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
    [main.c]
2026-06-04 fix(nav): negate East/Y in arena↔NED conversion (commands flew mirrored)
    The arena frame is Z-up/CCW ("0=+X, 90=+Y") but PX4 NED is Z-down/CW, so a
    right-handed NED with North=arena+X forces East to run along arena -Y. The
    firmware flipped only Z and passed Y straight through, so every Y command
    mirrored about the drone's start (physical_Y = 2*sy - cmd). X was unaffected.
    Confirmed in flight 2026-06-04: drone 1 (start y=5) cmd 2 -> phys 8; drone 2
    (start y=4) cmd 2 -> phys 6 = 2*sy-cmd (start-relative, not a fixed-centre
    reflection). Optical flow / EKF frame is internally correct; bug was purely the
    arena<->NED Y sign.
    Negate East at every arena<->NED boundary: setpoint convert, home see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
    [main.c]
2026-06-04 feat(nav): stop on obstacle from any of the 5 horizontal ToF sensors
    The Manhattan obstacle check derived which ToF sensor to read from a heading
    estimate (vision_yaw), which is stale/0/flipped when ArUco EKF is disabled, so
    the wrong sensor was read and the drone flew through obstacles (e.g. straight to
    (10,5)). The drone always faces its travel direction, so heading derivation is
    unnecessary.
    Add tof_min_horizontal_clearance() scanning all 5 horizontal sensors (LH, 45 LH,
    FWD, 45 RH, RH), skipping invalid readings, returning the nearest. Each step on a
    leg now stops and hovers on the current position if anything is within
    MANHATTAN_OBSTACLE_MM on any side. The pass-through clamp keeps the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
    [main.c]
2026-06-04 tune(nav): raise MANHATTAN_OBSTACLE_MM 500→1000 for braking distance
    The drone detected an obstacle at 500 mm then commanded hover at its current
    position, but coasted forward by its braking distance (~0.5 m at cruise) and
    stopped on the obstacle. Closest approach ≈ threshold − braking distance, so 500
    mm ≈ braking dist gave ~zero gap. Raise to 1000 mm so it detects earlier and
    keeps a margin. Tune higher for more standoff, or lower the PX4 cruise speed to
    shrink braking distance.
2026-06-04 tune(nav): raise MANHATTAN_OBSTACLE_MM 1000→1500
    Detect obstacles earlier (1.5 m). Detection window is 1..threshold mm with a
    valid (status==0, non-zero) reading; readings ≥ threshold, 0 mm, or an error
    status still read as "clear" (fail-open), so this only helps when the sensor
    returns a valid sub-threshold value a bit beyond 1 m.
    [main.c]
2026-06-04 fix(nav): per-side frame_sign so RH/blue scene navigates correctly
    With no magnetometer and vision/EV disabled (IMU+flow only), PX4's EKF "North"
    is the drone's physical facing at arm. Red/LH faces +X (North=+X, East=−Y, the
    baseline); blue/RH faces −X (North=−X, East=+Y) — red's frame rotated 180°. The
    heading seed can't correct this: it is gated behind vision_enabled and
    mav_send_vision_estimate sends yaw cov[20]=NaN, so PX4 never fuses it. Result:
    blue's frame was 180° off, so a waypoint made it spin 180° and fly into the +X
    wall (the all-5 ToF stop saved it); red worked by luck.
    Add frame_sign (+1 red/LH, −1 blue/RH, set in team_color_callback) multiplying
    every arena↔NED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
    [main.c]
2026-06-05 tune(vision): lower AEC target 15→10 for bright room; set DRONE_ID 1
    Reduce OV5647 auto-exposure brightness target (~29%→~19% full scale)
    so white ArUco quads don't blow out and lose contrast in bright venues.
2026-06-05 feat(vision): drop-zone gate — only publish boxes inside team areas
    Box markers whose computed world position falls outside both team
    rectangles (red x∈[0,7], blue x∈[13,20], y∈[0,10]) are dropped and not
    sent over the P4→S3 link / micro-ROS. Union gate (either area), no
    team-to-area matching since boxes can be captured into the opponent area.
2026-06-05 fix(vision): require fresh same-frame arena anchor for box world pose
    Boxes were positioned with best_pw/best_R_wc that persisted (static)
    across frames, so when a box was seen without a co-visible arena marker
    the current-frame box vector (tvec_b) was projected from a stale drone
    pose — placing the box in front of the wrong marker.
    Gate the box loop on best_dist < 1e9f (an arena marker chosen THIS
    frame) instead of !best_R_wc.empty() (true forever after first fix), and
    drop the static qualifier so the anchor cannot leak across frames.
    [aruco_pose.cpp]
2026-06-05 fix(vision): reword box-anchor comment that broke the build
    'best_pw_*/best_R_wc' contained the literal */ sequence, closing the C
    block comment early and turning the rest into code (new_boxes undeclared
    cascade). Reword to 'best_pw_x/y/z and best_R_wc'. No logic change.
    [aruco_pose.cpp]
2026-06-05 tune(vision): raise POSE_MAX_RANGE_M 5→8 m for box anchoring
    Boxes need a co-visible, in-range arena wall marker to be positioned
    (fresh-anchor gate). At 5 m the wall anchor was often out of range while
    the camera viewed a ground box, suppressing box publishes. 8 m matches
    the QVGA reliable-detection range. Watch the 12↔14 midline flip — the
    opposite wall is admissible again (the reason it was lowered to 5).
    [aruco_pose.cpp]
2026-06-05 fix(viz): point drone pose arrow at true forward (yaw-only)
    The P4 quaternion is camera-in-world (camera +Z = forward) but RViz
    draws the pose arrow along local +X, rendering it 90° off (along the
    drone's right). Rebuild a flat yaw-only quaternion from the camera
    forward vector — the same extraction that feeds vision_yaw — so the
    arrow points where the drone looks in both LH and RH scenes. Also
    flattens the symmetric disc marker. S3 firmware only; P4 and RViz
    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
    [main.c]
2026-06-05 tune(vision): halve minMarkerPerimeterRate 0.20→0.10
    Let smaller/farther box markers pass the detector's size pre-filter,
    raising box-detection probability. Slightly more candidate quads (CPU);
    ID whitelist + drop-zone gate still reject junk.
2026-06-05 tune(nav): lower MANHATTAN_OBSTACLE_MM 1500→1000; note hover TODO
    Reduce the Manhattan leg-path obstacle stop distance to 1.0 m. Add a
    TODO (code + top README) to implement a 1 s hover/debounce on detection,
    since the net wall's holes make the ToF reading flicker and a single
    short reading currently latches a hard stop.
    [main.c]
2026-06-05 fix(teleop): match keyboard move handedness to firmware arena→NED reflection
    Forward/strafe inverted after a Q/E 90° rotation: the firmware reflects Y
    (dy_n = -frame_sign·dy_a) for position but the keyboard movement was
    computed in the un-reflected arena CCW frame, so once sin(yaw)≠0 the
    translation went opposite the commanded heading. Pre-apply MX=frame_sign
    (cos) and MY=-frame_sign (sin) so a key press moves the drone along its
    nose for both teams. Rotation sense and heading quaternion unchanged.
    Verified red(+1)/blue(-1): movement direction == NED heading.
2026-06-05 tune(vision): minMarkerPerimeterRate 0.10→0.15 to restore ToF headroom
    0.10 detected boxes well but ~doubled detectMarkers cost (3→2 fps) and
    the extra PSRAM/heap pressure on CPU0 starved the CPU1 ToF loop, lagging
    obstacle readings (degrades the 1.0 m stop). 0.15 keeps some of the
    detection reach while giving CPU0 headroom back.
2026-06-05 fix(teleop): don't spin blue 180° when entering keyboard fly mode
    Climb-wait holds both teams at command-yaw 0, but fly mode initialized
    blue to 180, so the first keyboard setpoint commanded a 180° turn.
    Command yaw is passed straight through as NED yaw and each team's NED
    North = its launch heading (red +X, blue −X via frame_sign), so both
    launch at command-yaw 0. Init yaw=0 for both; heading now unchanged on
    entry. Consistent with the W/A/S/D handedness fix.
2026-06-05 feat(viz): floating coordinate label over each box in RViz
    Publish a TEXT_VIEW_FACING marker per box reading "ArUco No. ZZ (X, Y)",
    floating above the cube, on the existing /visualization_marker topic in
    a distinct ns ("box_label") so it doesn't overwrite the cube. Label text
    is (re)formatted only when box data arrives to limit String__assign
    churn, and published alongside the cube in both the seen and 2 s refresh
    branches.
    [main.c]
2026-06-05 chore(comms): set DRONE_ID 2
    Per-device identity for flashing drone 2.
2026-06-05 revert(vision): restore minMarkerPerimeterRate 0.20 and POSE_MAX_RANGE_M 5 m
    Put both detection gates back to their originals for the ArUco
    position-bias investigation. minMarkerPerimeterRate 0.15→0.20 (cleaner
    poses, less CPU/ToF load); POSE_MAX_RANGE_M 8→5 m (a far anchor gives a
    noisy/flip-prone pose, and both the drone pose and box coords derive
    from it). Boxes will be harder to anchor at 5 m — revisit with
    bounded-staleness if needed.
    [aruco_pose.cpp]
2026-06-05 tune(vision): relax POSE_MAX_RANGE_M 5→8 m for box visibility
    Boxes weren't appearing; widen the arena-marker range gate so a wall
    anchor stays resolvable while framing a box. 8 m ≈ QVGA detection limit.
    Accepts a noisier far-anchor pose for box-visibility testing.
2026-06-05 feat(vision): bounded-staleness box anchor + POSE_MAX_RANGE_M back to 5 m
    8 m admitted far/oblique markers whose flipped pose put the drone outside
    the arena (and biased box coords). Revert range to 5 m for a clean
    near-anchor pose, and decouple box co-visibility from it: a box may now be
    positioned from the most recent resolved anchor if it is <=
    BOX_ANCHOR_MAX_AGE_FRAMES (30) old. Frame a wall marker (<=5 m), pan to a
    box, and it still resolves. age 0 = same-frame (most accurate); the cache
    ages each frame without a fresh fix and stops positioning past the window.
    [aruco_pose.cpp]
2026-06-05 tune(viz): box label "(X,Y)" integer, 1 m above; POSE_MAX_RANGE_M 5→6 m
    Box label now reads "(X,Y)" with rounded integer arena coords (no "ArUco
    No. ZZ" prefix, no spacing), same text style, floated 1 m above the box.
    Widen pose-range gate 5→6 m for a bit more box-anchor reach.
2026-06-05 feat(vision): hybrid box localization — drone-relative fallback
    Decouple box visibility from arena-marker co-visibility. The P4 now emits
    each box as either ANCHORED (arena world x,y, when a fresh bounded-staleness
    anchor exists — accurate) or CAMERA (box vector in the camera optical
    frame). The S3 projects CAMERA-frame boxes to arena world using the drone's
    own px4 position + heading (forward-level cam, CAM_TILT_DEG=0), so a box
    publishes whenever the camera sees it — no wall marker needed.
    Drop-zone gate kept, moved to the S3 in arena frame and applied to BOTH
    frames. Protocol: p4_box_entry_t gains a 1-byte `frame` tag (13→14 B,
    payload 131→137 B); buffers auto-resize from sizeo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
2026-06-05 docs(readme): add hardware-mod TODO (common ground, LED resistor, S3 roles)
2026-06-05 chore(comms): set DRONE_ID 5
    Per-device identity for flashing drone 5.
2026-06-06 feat(swarm): drone roles + SDC26 Commander backbone
    Firmware (drone-comms-esp32s3/main.c):
    - Compile-time DRONE_ROLE keyed on DRONE_ID (1,3 Seeker / 2,4 Executor /
    5 Leader); published on /drone_<ID>/role at boot instead of "idle".
    - CONFIG_ROLE_* accepted on /gcs/drone_<ID>/config as a no-op provision
    (role stays compile-time; reserved for a future runtime role switch).
    Ground station:
    - New sdc26_commander.py backbone (rclpy): role roster, box registry,
    role/state/pose subscriptions, control/config publishers, 2 Hz control
    loop. Assignment, fallback fill, and leader home-check are stubbed.
    Team is taken live from the RQT panel (/gcs/system/team_color).
    - Args: --boxes-timeout, -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
2026-06-06 feat(commander): live dashboard + random-box fallback fill
    Terminal dashboard (1 Hz, flicker-free):
    - Keep logo; show team, uptime, [DRY-RUN], and a [STARTUP HOLD Ns] flag.
    - Box line BOX1/2/3 with coordinates; per-drone table
    DRONE/STATUS/ROLE/LOC/WP/DELAY (DELAY = age of last message).
    - "last command sent: D<id> <role> (x,y)" line below the table.
    - Flicker-free refresh: cursor-home overwrite (\033[H + \033[K/\033[J),
    full clear only on the first frame (replaces os.system('clear')).
    Behaviour:
    - 5 s startup grace (STARTUP_DELAY_S): track boxes but send no drone
    commands until elapsed >= 5 s.
    - Random fallback fill (TODO #2): at boxes-timeout, fill each still-missing
    opponent box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
2026-06-06 feat(commander): publish random fallback boxes to RViz
    - Commander now publishes the random fallback boxes on /visualization_marker
    in the firmware's exact format: CUBE (frame map, ns blue/red by id, 0.5 m,
    matching colours, z=0.25) plus a 'box_label' TEXT_VIEW_FACING "(X,Y)" label
    1 m above. Re-sent each tick so a late-starting RViz still picks them up.
    - Only fallback (source='fallback') boxes are published. Found/real boxes are
    owned by the ESP32-S3 firmware and are never republished or overwritten.
    - _marker_cb yields to a genuine firmware detection of a fallback id (same id,
    different position) — drops the fallback so the firmware's found box wins;
    an identical-position ec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
2026-06-06 fix(commander): publish fallback boxes once, not every tick
    Republishing the random fallback boxes on every 2 Hz control tick (and the
    RQT re-labelling it triggered) caused terminal/RViz lag. Publish each fallback
    CUBE + label exactly once, when the fallback fires — RViz markers persist, and
    if a box is later found the firmware's marker (same id) overwrites ours.
    Removes the per-tick _publish_fallback_boxes() call and the now-unused method.
2026-06-06 feat(commander): replace DELAY column with per-drone COOLDOWN
    Dashboard now shows a COOLDOWN column instead of telemetry-age DELAY: the
    time remaining in a per-drone command cooldown (COMMAND_COOLDOWN_S = 5 s)
    after a setpoint is sent — counts down to 'ready', '—' if never commanded.
    Cooldown is stamped in _send_control (real and dry-run); the future
    assignment logic can read _last_cmd_time to honor the 5 s gap. Drops the
    now-unused _last_contact tracking.
2026-06-06 feat(commander): executor box-capture mission + README Swarm Behaviour
    Executor logic (drones 2 & 4) in sdc26_commander.py:
    - Per-executor state machine: idle → to_box → dwell(cooldown) → to_border
    → to_out → hover.
    - Idle executors claim the nearest unclaimed opponent box (exclusive claims,
    so the two executors never target the same box) and are sent there.
    - On arrival, dwell for the 5 s cooldown, then return keeping the box's Y to
    the team-zone border X (LH/red 5, RH/blue 15), then 3 m out (LH 8, RH 12),
    then hover until the next command.
    - Dashboard WP shows the live waypoint/hover; COOLDOWN shows the box dwell.
    - Verified end-to-end (two executors took separate boxes;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
2026-06-06 feat(commander): LOC from RViz disc marker + ALT/HDG columns
    - Drone position now comes from the firmware's RViz disc marker (CYLINDER,
    ns 'drone_<id>') on /visualization_marker — the actual displayed pose — not
    /drone_<N>/vision_pose (which can be held/faded after ArUco loss). Used for
    both the LOC display and executor arrival detection.
    - Added ALT (altitude, disc z) and HDG (heading from disc orientation, arena
    degrees 0=+X/90=+Y) columns to the per-drone table.
    - Dropped the vision_pose subscription and _pose_cb; pose/heading captured in
    _marker_cb; added _yaw_deg helper.
2026-06-06 feat(commander): seeker search-position logic
    Seekers (drones 1 & 3) are sent to a fixed search waypoint in the opponent
    area after the start-up cooldown, then hover:
    - D1 → (15,5) LH / (5,5) RH ; D3 → (15,3) LH / (5,3) RH (SEEKER_WP by scene).
    - Commanded once; only re-sent if the scene/target changes (holds till the
    next waypoint). Runs only past the 5 s start-up grace.
    - Dashboard WP column shows the seeker waypoint.
2026-06-06 feat(commander): executors fly to/from box at 2 m altitude
    Add EXECUTOR_ALT_M = 2.0 and use it for all three executor legs (to box,
    return to border, step out). Seekers remain at start_alt (1.0 m).
2026-06-07 feat(nav): obstacle auto-resume, tighter ToF window, 1m box boundary inset
    - Obstacle hold now rechecks all 5 horizontal ToF sensors every 1 s and
    resumes the Manhattan path from the current waypoint when clear, rather
    than waiting indefinitely for a new GCS command.
    - ToF detection window tightened: lower bound raised from 1 mm to 50 mm
    (filter contact/saturation noise), upper bound lowered from 1000 mm to
    500 mm (MANHATTAN_OBSTACLE_MM).
    - Box drop-zone boundaries inset 1 m from all walls: X_MIN 0→1, X_MAX
    20→19, Y_MIN 0→1, Y_MAX 10→9 — boxes on walls are physically impossible.
    [main.c]
2026-06-07 feat(gcs): stagger drone launches, add arena-view launcher, rename desktop shortcuts
    - commander: lower executor altitude 2.0→1.5 m; stagger seeker and
    executor dispatch by SEEKER_STAGGER_S (3 s) to prevent mid-air conflicts
    - rviz: enable all drone namespaces (1–5), drone_heading markers, update view
    - launchers: rename desktop shortcuts from "Mach Mind" to "GCS —" prefix;
    add GCS — Arena View shortcut and launch-arena-view.sh (port-selection menu
    for P4/S3 ArUco serial feeds)
2026-06-08 feat(commander): implement leader two-phase flight to team base
    Drone 5 (leader) now executes a two-phase flight after the seekers depart:
    1. Flies to centre-arena (10, 5) at start altitude, facing the team zone
    (yaw 180° / −X for LH/red; yaw 0° / +X for RH/blue).
    2. On arrival, closes in to the team base waypoint at 0.5 m altitude
    (LH/red → (8, 5); RH/blue → (12, 5)).
    Departure is gated by a 3 s stagger after the last seeker launch.
    State machine resets automatically on team colour change.
2026-06-09 chore(hardware): add drone v1/v2 design files, ground station, and transportation assets
    [Exaust.stl, Schematics.brd, Schematics.sch, camera_sleve.stl, camera_sleve_alternative.stl, side_bracket_for_laser_ranger.stl, swarm stack bracket mk6.stl, swarm stack bracket mk7.stl]
2026-06-09 docs(hardware): add v2.0 PCB photo after comparison table
2026-06-09 docs(hardware): move v2.0 PCB photo inside comparison table
2026-06-09 Revert "docs(hardware): move v2.0 PCB photo inside comparison table"
    This reverts commit aeaee8f319c36baea5a87a6bfd99ee73ab40f1a1.
2026-06-09 docs(hardware): rename PCB photo title to Swarm Stack Version 2.0
2026-06-09 chore(hardware): rename all drone images to kebab-case, update README paths
2026-06-09 chore(hardware): add STL files for drone mounts, ground station, and transport v2.0
    [Bezel_Mk2.stl, Bottom frame_Mk2.stl, Panel 1_Mk2.stl, Panel 2.stl, Panel 3_Mk2.stl, Panel 4.stl, Panel 5.stl, Panel 6.stl]
2026-06-09 chore(hardware): rename ground-station files to lowercase with underscores, add README
    [bezel_mk2.stl, bottom_frame_mk2.stl, exaust.stl, panel_1_mk2.stl, panel_2.stl, panel_3_mk2.stl, panel_4.stl, panel_5.stl]
2026-06-09 docs(hardware): update ground-station README table to match transportation style
2026-06-09 chore(hardware): add component renders, reorganise done/ into mk2/, remove old images
    [bottom_frame_mk2.stl, panel_1_mk2.stl, panel_2.stl, panel_3_mk2.stl, panel_4.stl, panel_5.stl, panel_6.stl]
2026-06-09 docs(hardware): rewrite ground-station README as 3-column component image table
2026-06-09 docs(hardware): add component titles to ground-station README table
2026-06-09 docs(hardware): update ground-station titles to header-row style matching hardware README
2026-06-09 docs(hardware): add assembled GCS photo and assembly progress table to ground-station README
2026-06-09 docs(hardware): resize assembled GCS photo to 780px, update assembly table titles
2026-06-09 docs(hardware): set assembled GCS photo to 868px, reflow assembly table to 2x2
2026-06-09 docs(hardware): increase assembly table image width to 420px
2026-06-09 docs(hardware): change assembly table image width to 400px
2026-06-09 docs(hardware): add part list table to ground-station README
2026-06-09 docs(hardware): expand Ground Control Station section with full content from ground-station README
2026-06-09 chore(hardware): add ground-station and transportation images, remove old GCS photo
2026-06-09 docs(readme): append hardware section with GCS components, assembly, and transportation
2026-06-09 docs(hardware): rename PCB Board to Swarm Stack PCB in drone v2.0 README
2026-06-09 docs(hardware): update base mount title in drone v2.0 README
2026-06-09 docs(hardware): update base mount title to Base for LiDAR & Flow Motion
2026-06-09 docs(hardware): update FC mount adapter title in drone v2.0 README
2026-06-09 docs(hardware): add assembled drone photo table to v2.0 README, add assembly photos
2026-06-09 docs(hardware): set assembly photo width to 260px to match component tables
2026-06-09 docs(hardware): expand Drone section to Drone Version 2.0 with full component and assembly content
2026-06-09 docs(hardware): link Swarm Stack PCB image to PCB folder in both READMEs
2026-06-09 docs(hardware): remove No name toolbox cell, merge assembly into 3-column table at 260px
2026-06-09 docs(readme): add Drone Version 2.0 section, fix GCS assembly table to 3-column at 260px
2026-06-09 docs(hardware): add wide drone photo and second assembly row to v2.0 README
2026-06-09 docs(hardware): update drone assembly title and move above image
2026-06-09 docs(hardware): insert middle row of assembly photos in drone v2.0 README
2026-06-09 docs(ground-station): add GCS software screenshot to README
2026-06-09 docs(pcb): add README with Eagle software note and LED resistor warning
2026-06-09 docs(pcb): split note into Note 1 and Note 2, remove blockquote
2026-06-09 docs(pcb): remove title from README
2026-06-09 docs(pcb): add 2x2 photo table to README
2026-06-09 docs(pcb): add title and update pcb-1, pcb-2 images
2026-06-09 docs(pcb): add Note 3 about ESP32-P4 pinout differences
2026-06-09 docs(pcb): remove last row from photo table
2026-06-09 docs(pcb): add ToF sensor S0-S5 GPIO and direction table
2026-06-09 docs(pcb): add ESP32-P4 I2C GPIO table
2026-06-09 docs(pcb): clarify Waveshare devboard in Note 3
2026-06-09 docs(pcb): remove devboard from Note 3
2026-06-09 docs(pcb): add Note 4 about C6 WiFi 6 module
2026-06-09 docs(pcb): update Note 1 to current limiting resistor
2026-06-09 docs(gcs): add ground-station-software README with screenshot table
2026-06-09 docs(firmware): fix EKF2_HGT_REF to range sensor (MTF-01 LiDAR)
2026-06-09 docs(drone-firmware): rewrite PX4 parameter tables from actual params file
    All values read directly from PX4_settings.params — no guessed values.
2026-06-09 docs(drone-firmware): remove "Mach Mind — " prefix from title
2026-06-09 docs: move vision comparison image from v2.0 README to drone-vision-esp32p4 README
2026-06-09 docs(drone-comms-esp32s3): clarify Agent IP and Port both require manual menuconfig
2026-06-09 feat(commander): seeker patrol, base defence, re-intercept, emergency executor
    Seeker patrol (D1 & D3)
    - Full multi-waypoint zigzag covering opponent base columns (near x=12/8, deep x=15/5)
    - 60 s dwell at arrival waypoints; pass-throughs advance immediately
    - D1 and D3 depart simultaneously with 3 s stagger on match start
    - D3 receives +5 s extra delay at conflict steps to avoid head-on Y-leg collision
    - Seekers descend to 0.5 m after crossing arena midline (x=10)
    Executor improvements
    - Mission recycling: executors return to idle after to_out, loop to next box
    - Base defence: D2 intercepts opponent ArUco boxes detected inside own team zone
    (priority 2 after opponent-zone boxes; D4 takes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
2026-06-12 docs(v1.0): link XIAO ESP32S3 Sense to Seeed wiki
2026-06-13 hardware: add drone assembly photos
2026-06-13 hardware: add reference STL models for drone frame and top plate
    [for_reference_only_bottom_frame_rough.stl, for_reference_only_top_plate.stl]
