machmind-dev/drone-swarm-challenge-2026/(notices)

Notices in the files:
hardware/drone/v2.0/PCB/Schematics.brd:
Mach Mind (c) 2026
